nakujaproject/N3-Solid-_Propulsion/FlightData_N3_launch/Motor_design_Aluminum_casing/CAD/landscape04-bg_04.jpg

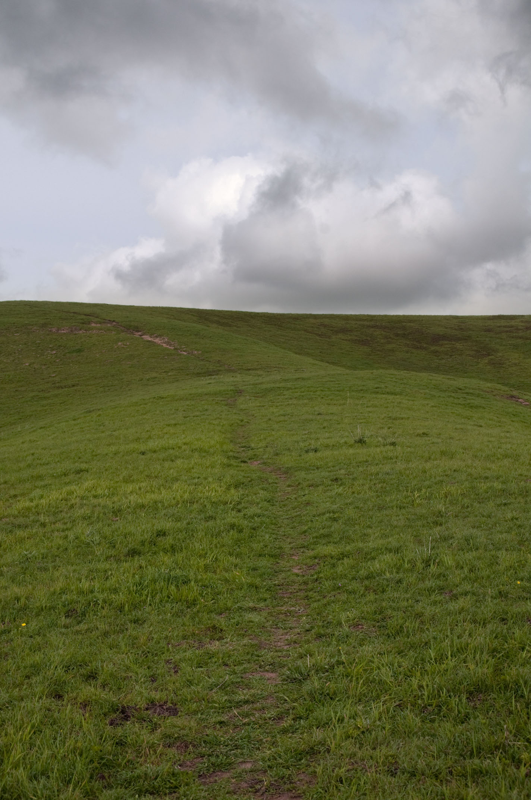
FlightData_N3_launch/Motor_design_Aluminum_casing/CAD/landscape04-bg_04.jpg
