nakujaproject/N3-Solid-_Propulsion/README.md

# N3-Solid-_Propulsion
Reporsitory to hold files for the development of the N3 solid propellant motor.
With a target apogee of 2KM
The propellant of choice is KNSB.
