nakujaproject/N3-Solid-_Propulsion/CAD_files/README.md

#CAD files
Directory to hold all CAD files
