nakujaproject/N3-Solid-_Propulsion/OpenMotor_files/README.md

#Open Motor Files
Directory to hold open motor files.
