nakujaproject/N3-Solid-_Propulsion/weeklyReports/BATCH 2 WEEK 11  REPORT.pptx

## BATCH 2 WEEK 110

SOLID PROPULSION REPORT

## MAJOR REMAINING TASKS ACCORDING TO TIMELINE

1. Three grain static test and analyzing of results.
2. Four grain static test and analyzing of results.

https://docs.google.com/spreadsheets/d/1hBBPNcnpQUVeR51bRd35yVVWFX5lDWHhBGYU0TpIXSk/edit#gid=0

## THIS WEEK'S OBJECTIVES

1. TWO GRAIN MOTOR SECOND STATIC TEST.
2. MODIFY THE DESIGN OF CASTING TOOLS.
3. START AND FINISH WORKING ON THE 3 GRAIN MOTOR.
4. COOK 2 GRAINS FROM SCRATCH.**
5. 3D PRINT REDESIGNED ELECTRONIC CASING.

## TWO GRAIN MOTOR SECOND STATIC TEST.

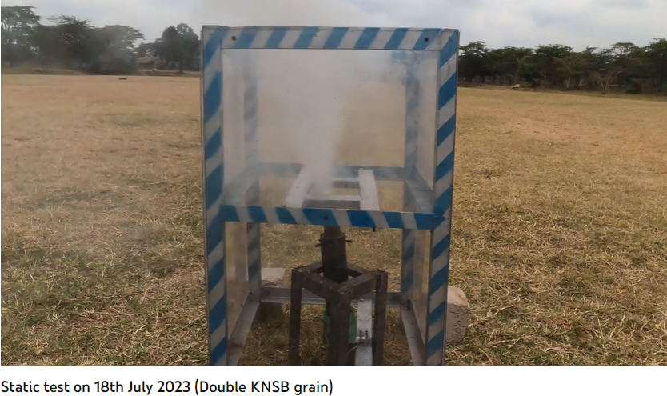
[picture p2: figure]
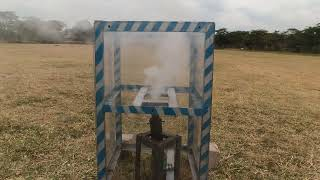
[picture p3: figure]

## AFTERMATH OF STATIC TEST

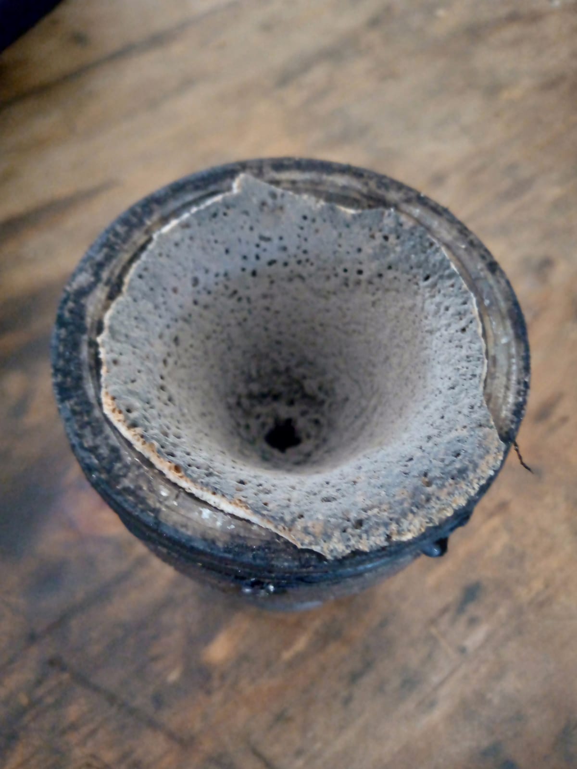
[picture p4: figure]
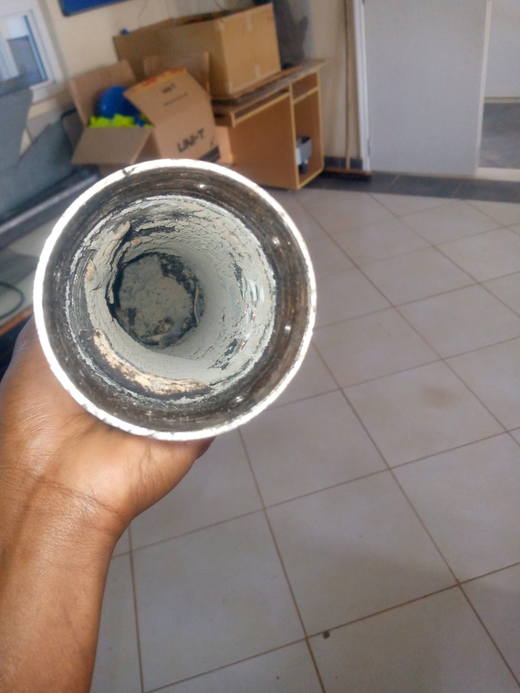
[picture p5: figure]
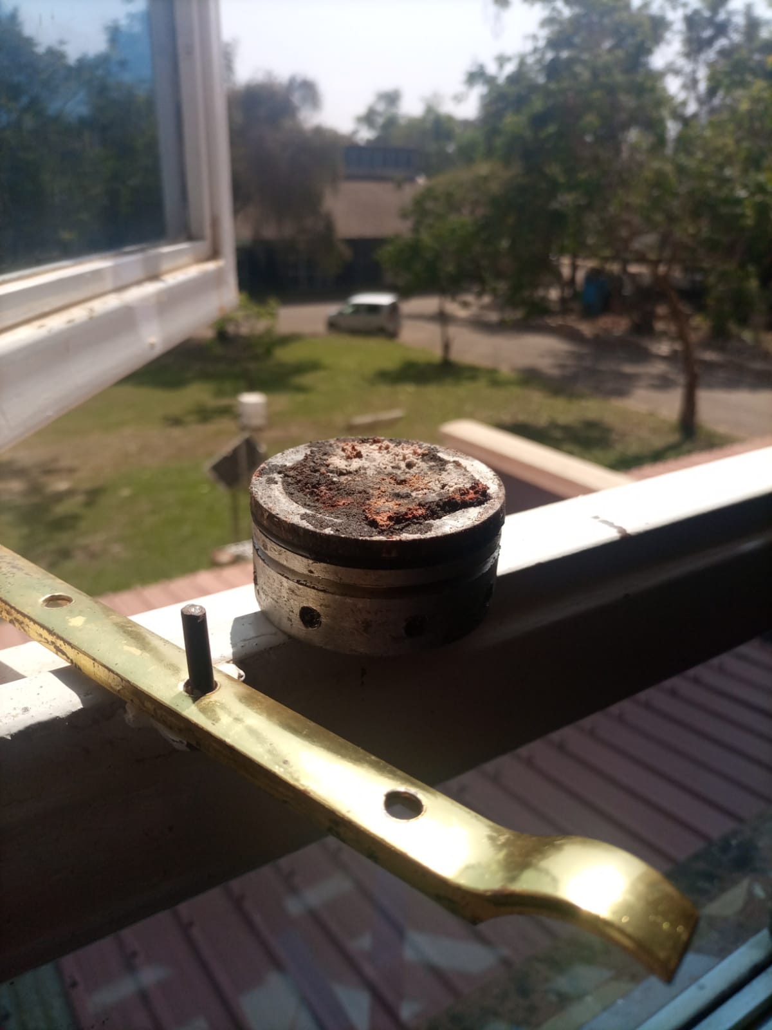
[picture p6: figure]

## OPEN MOTOR SIMULATION

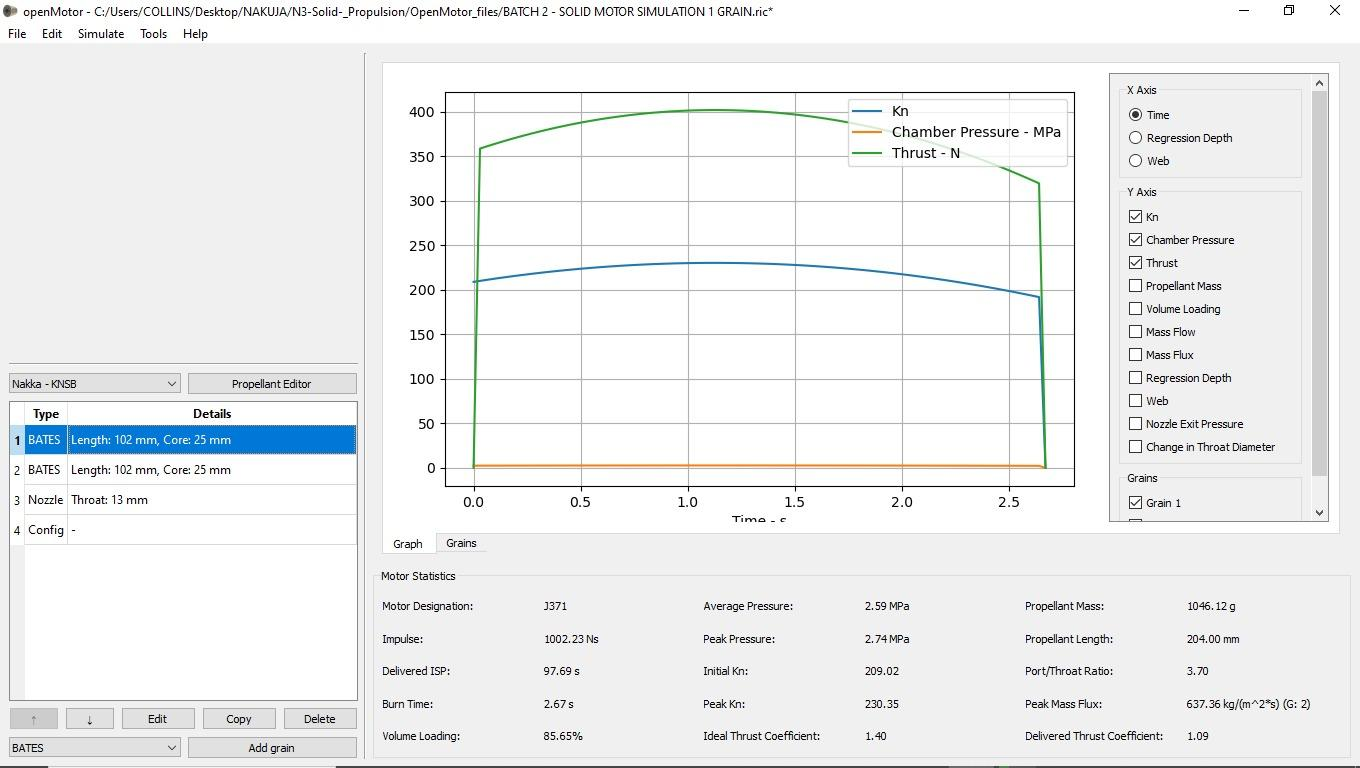
[picture p7: figure]

## ANALYZING STATIC TEST VALUES

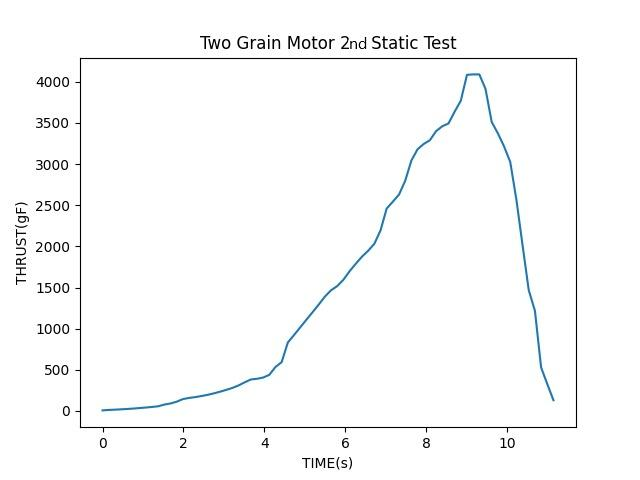
[picture p8: figure]

IMPULSE OF 2ND TWO GRAIN TEST: 165.O6 Ns

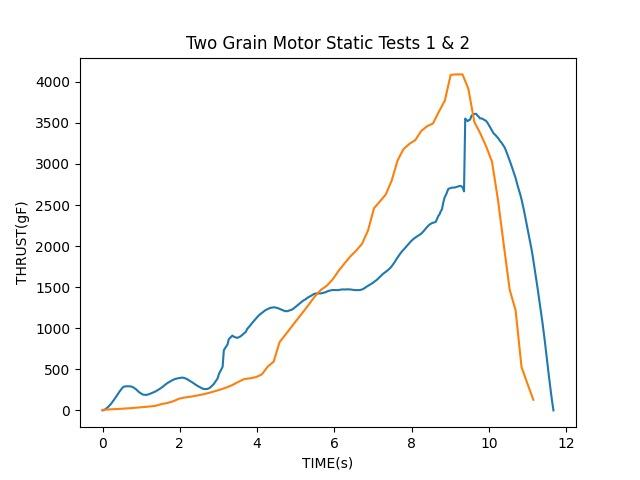
[picture p9: figure]

## TESTING OF THE GRAIN BURN RATE

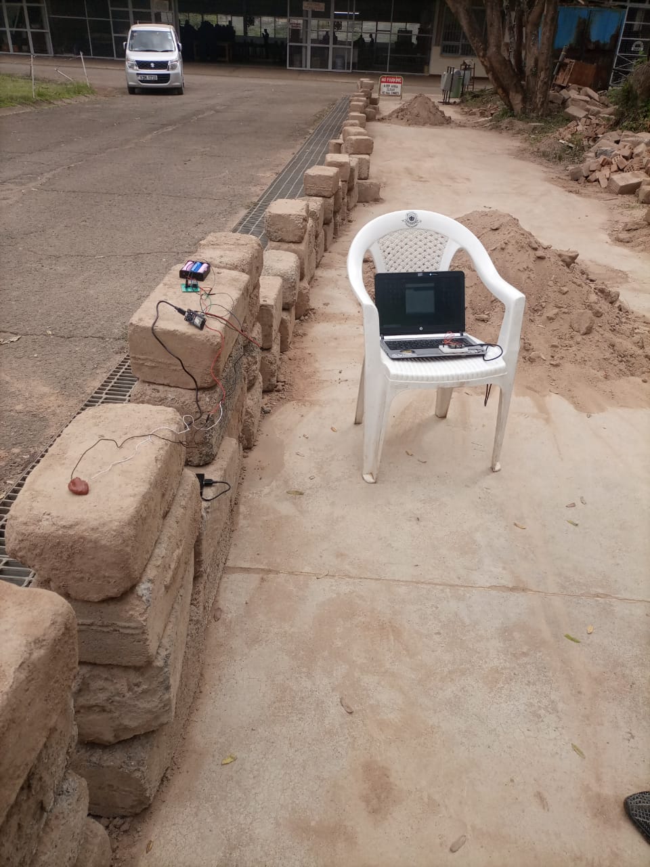
[picture p10: figure]

https://photos.google.com/share/AF1QipPy1zYaDyku8yvup7_9s7e2EUUXyLsp6BuL0e7tGyP1ksXkVun3unHOr58JC0QGWQ/photo/AF1QipNi4DA2iSjmNpshN0YMY0NlOidJ966pOgjzi1Rp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

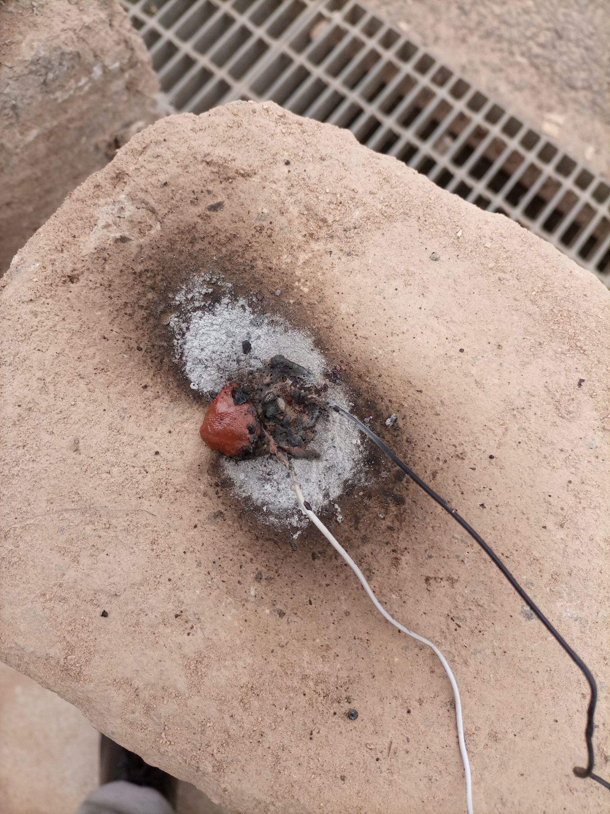
[picture p11: figure]

## MODIFY THE DESIGN OF CASTING TOOLS

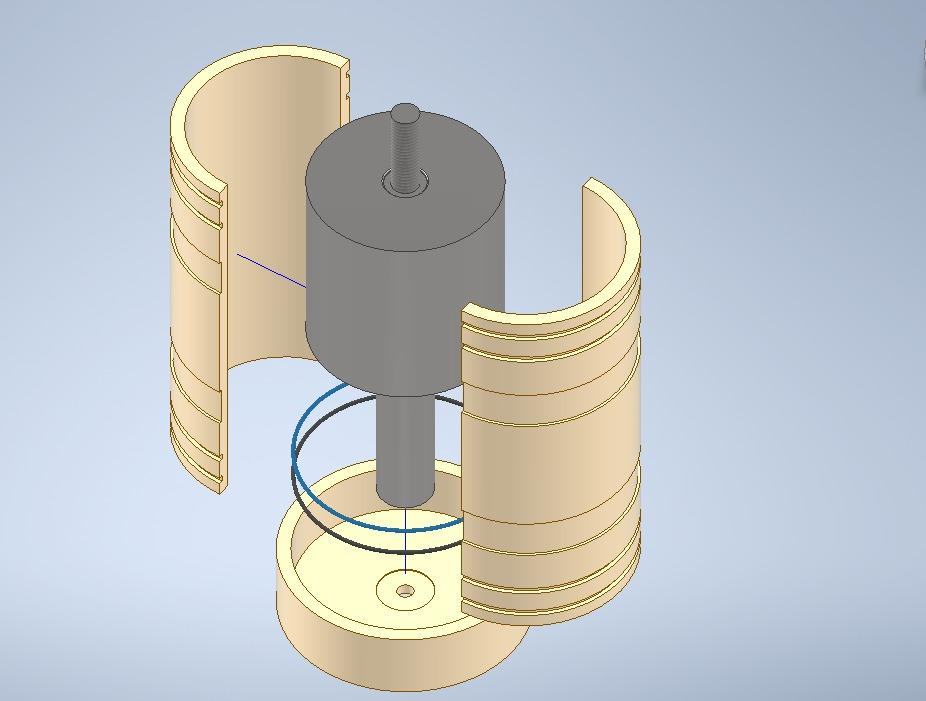
[picture p12: figure]

## START AND FINISH WORKING ON THE THREE GRAIN MOTOR

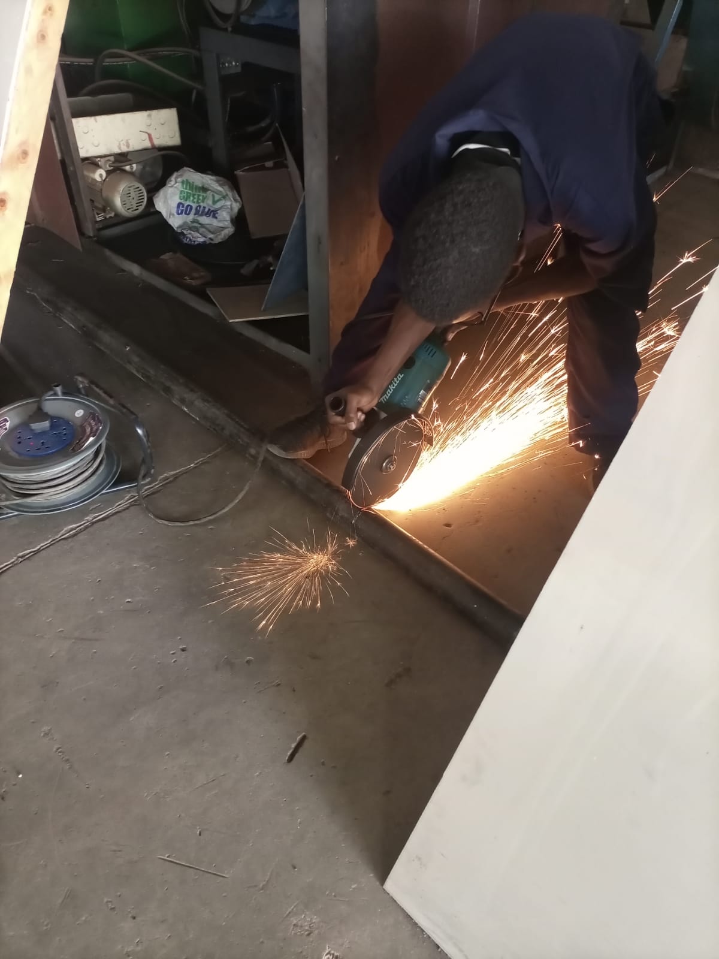
[picture p13: figure]
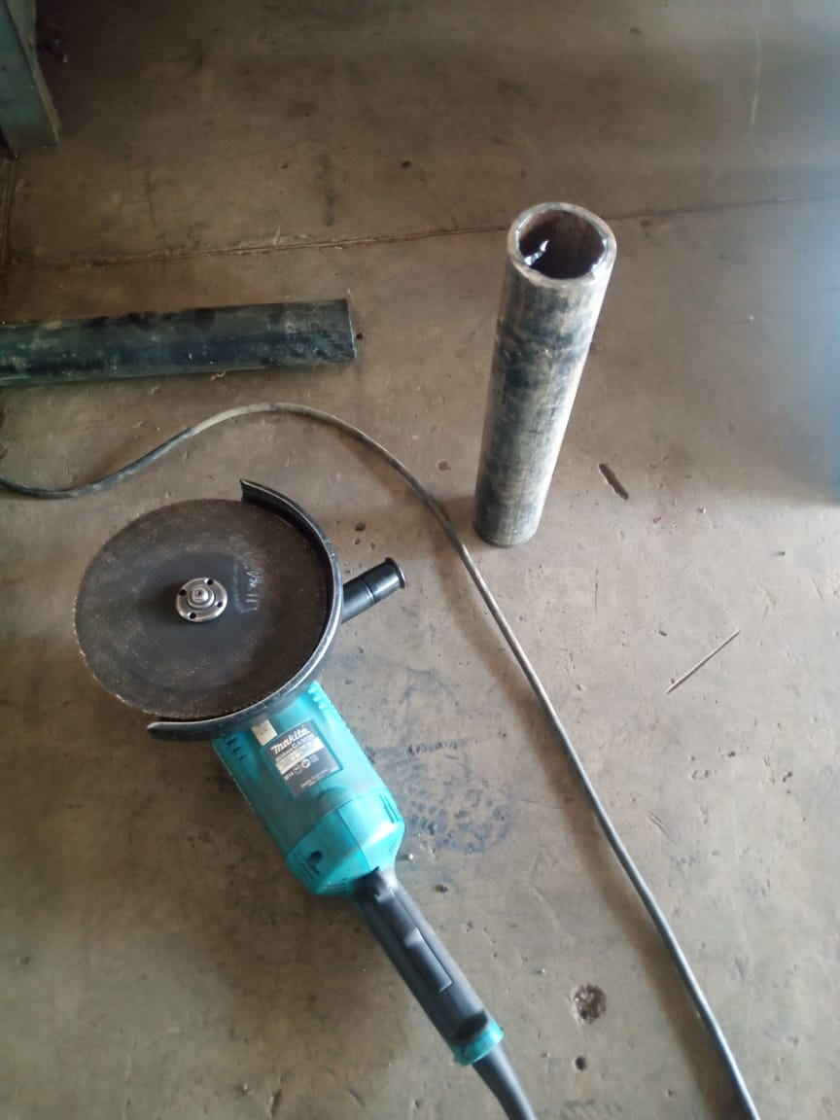
[picture p14: figure]
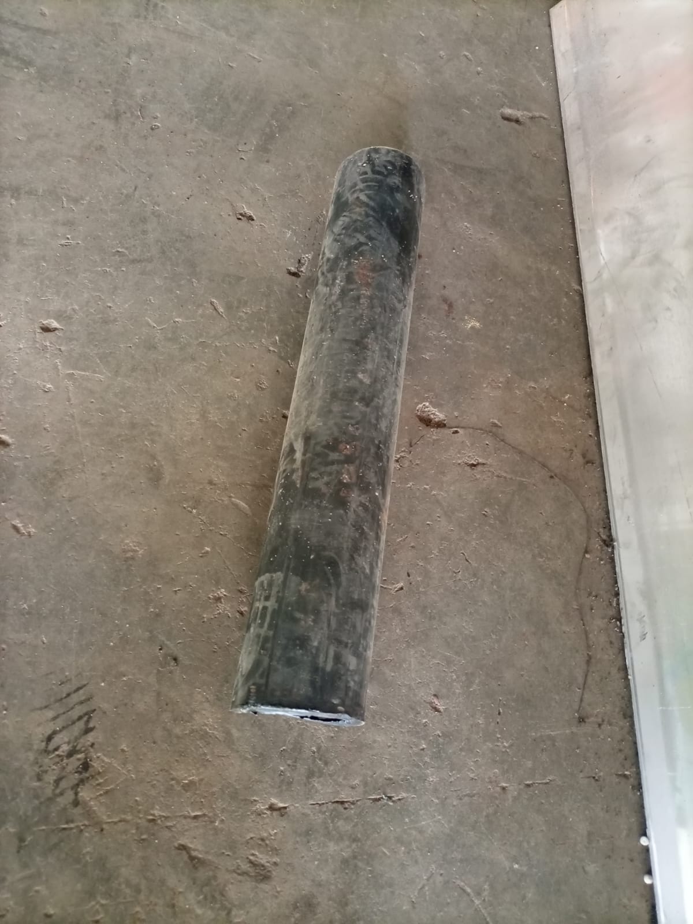
[picture p15: figure]

## 3D PRINTING OF REDESIGNED ELECTRONICS CASING

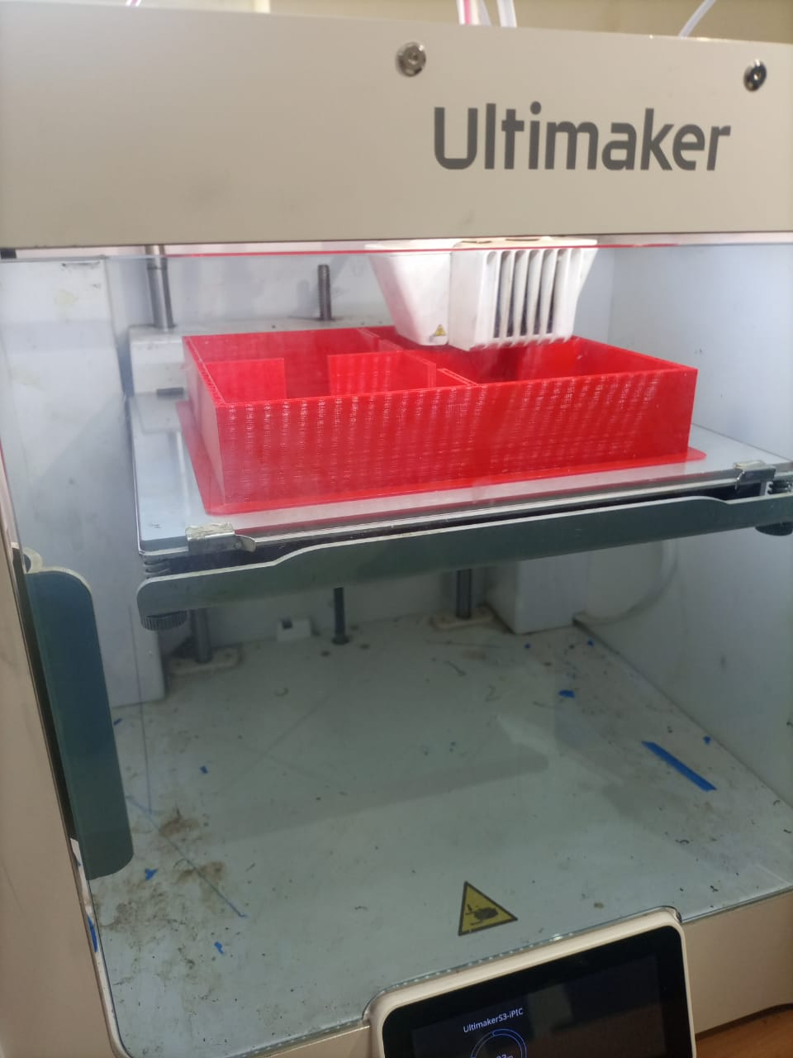
[picture p16: figure]
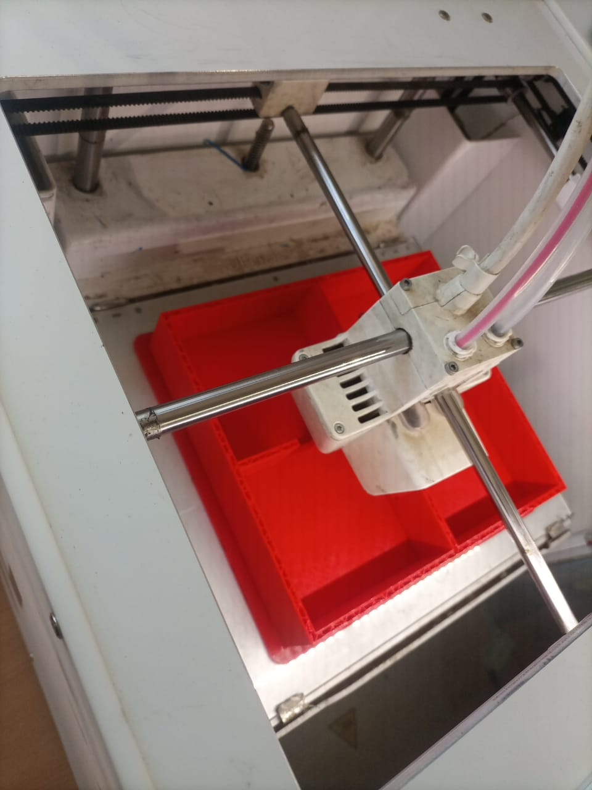
[picture p17: figure]

## CHALLENGES

1. FAULTY ENGINE LATHE

## NEXT WEEK'S OBJECTIVES

1. COOK 2 FULL GRAINS
2. CONDUCT 3RD 2 GRAIN STATIC TEST.
3. FINISH UP ON THE 3 GRAIN MOTOR.

## THANK YOU
