nakujaproject/N3-Solid-_Propulsion/weeklyReports/BATCH_2_WEEK_10.pptx

## WEEK 10 SOLID PROPULSION REPORT

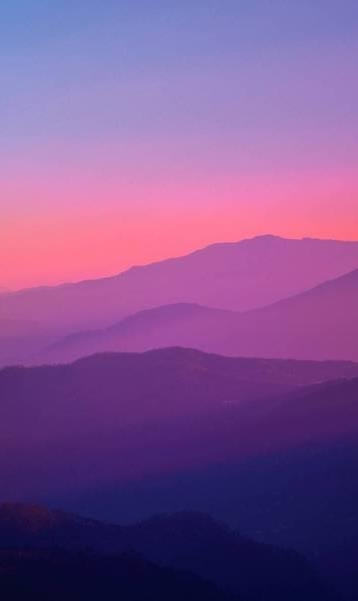
[picture p18: figure]
A picture containing mountain, sky, outdoor, nature, sunrise

BATCH 2

## Slide 2

https://docs.google.com/spreadsheets/d/1hBBPNcnpQUVeR51bRd35yVVWFX5lDWHhBGYU0TpIXSk/edit#gid=0

Gantt chart

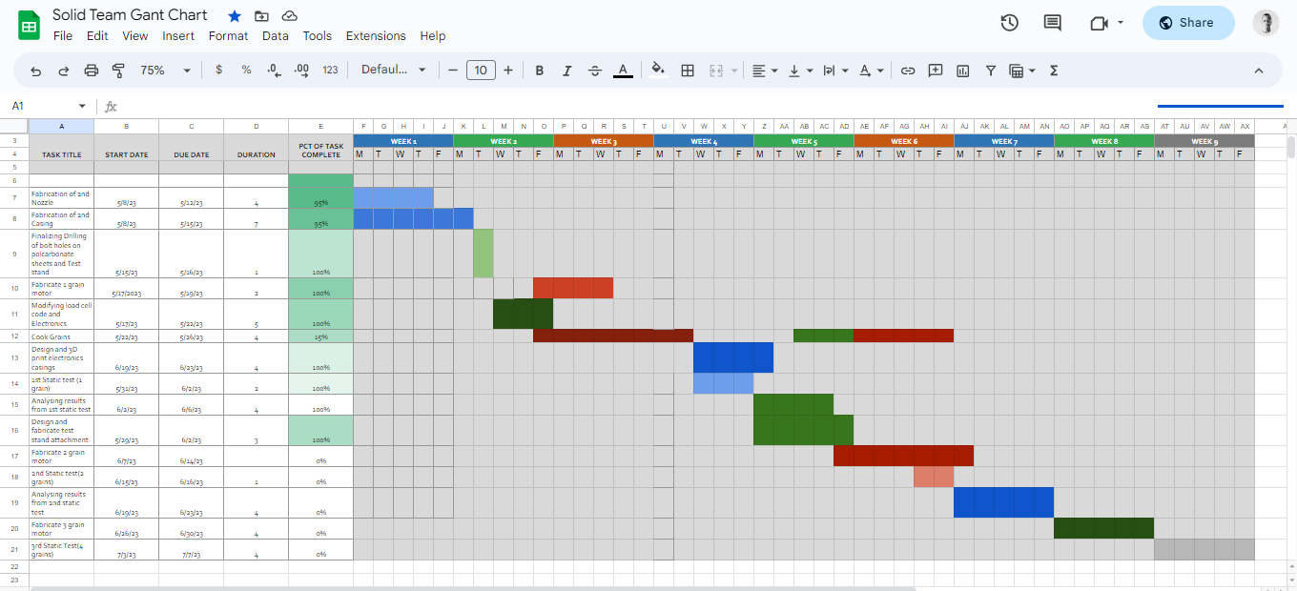
[picture p19: figure]

## WEEKLY OBJECTIVES

COOK
COOK3FULL GRAINS.
TWO GRAIN MOTOR.
PREPARE TWO GRAIN MOTOR FOR SECOND TEST.
REDESIGN.
CASING FOR ELECTRONICS.
MOTOR HOLDER.

## REDESIGN.

CASING FOR ELECTRONICS.

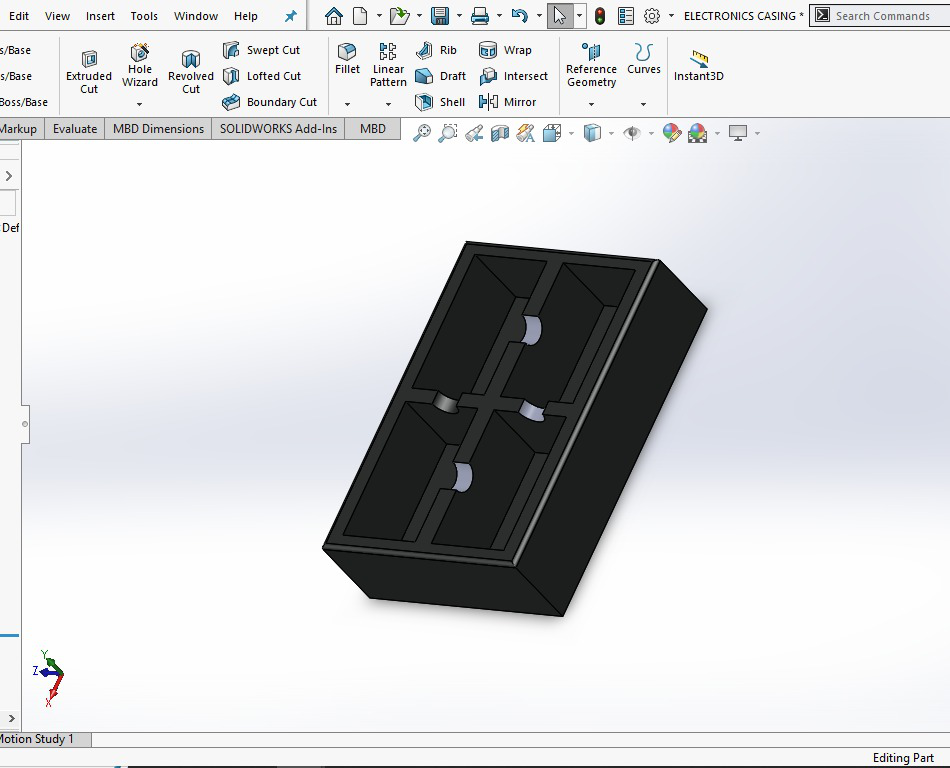
[picture p20: figure]
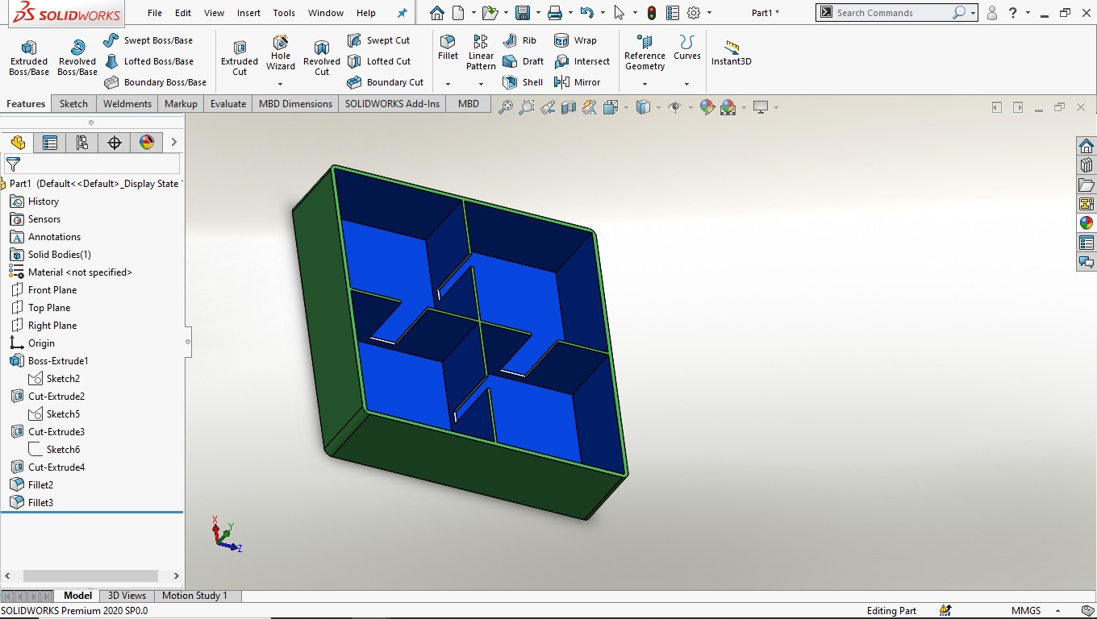
[picture p21: figure]

## COOKING TWO GRINS

REDESIGN.

MOTOR HOLDER.

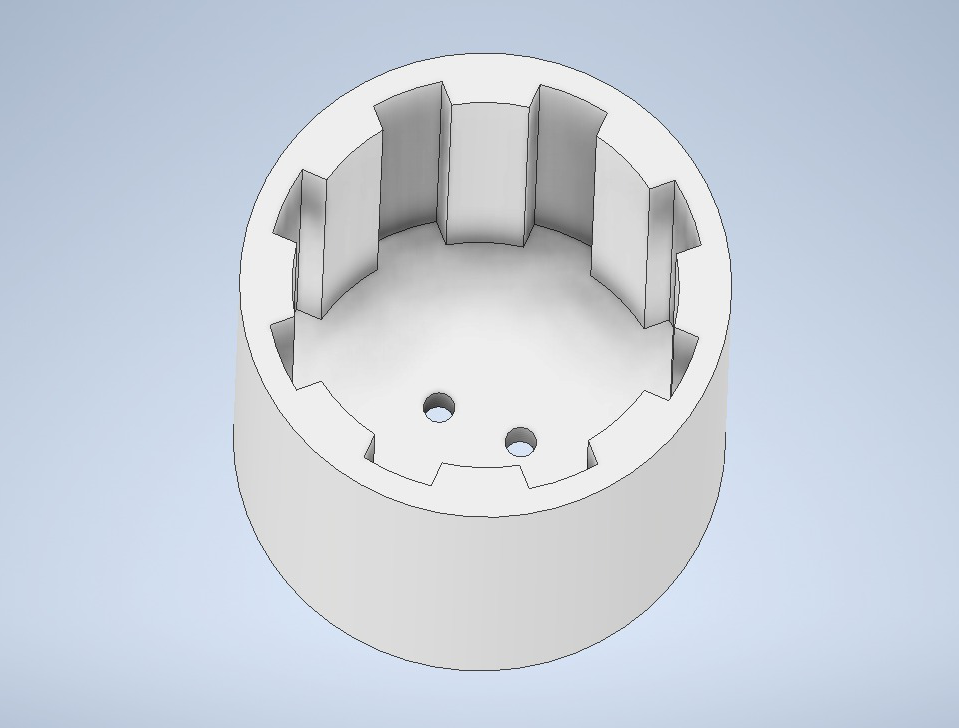
[picture p22: figure]
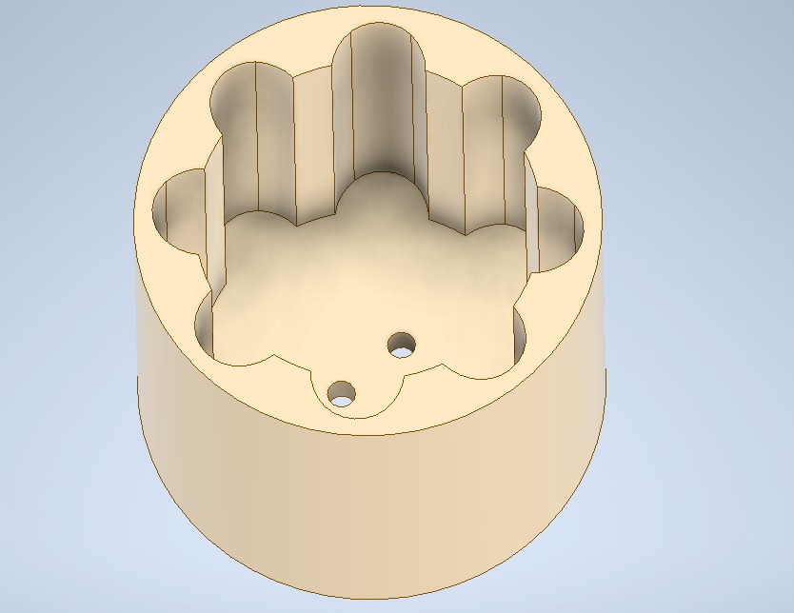
[picture p23: figure]

## FINAL PRODUCT

COOK.

COOK 3 FULL GRAINS.

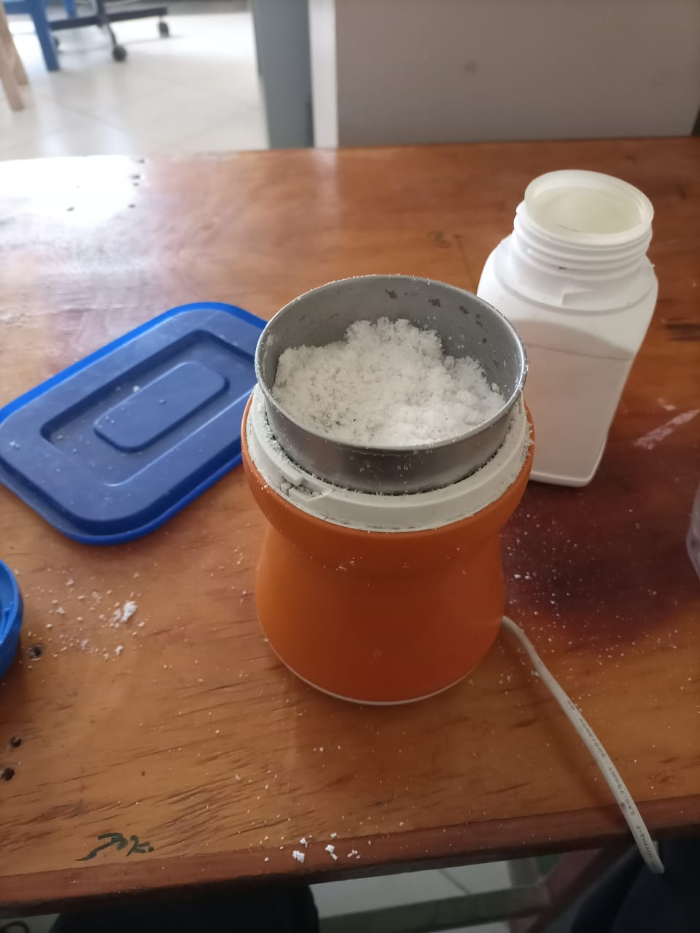
[picture p24: figure]
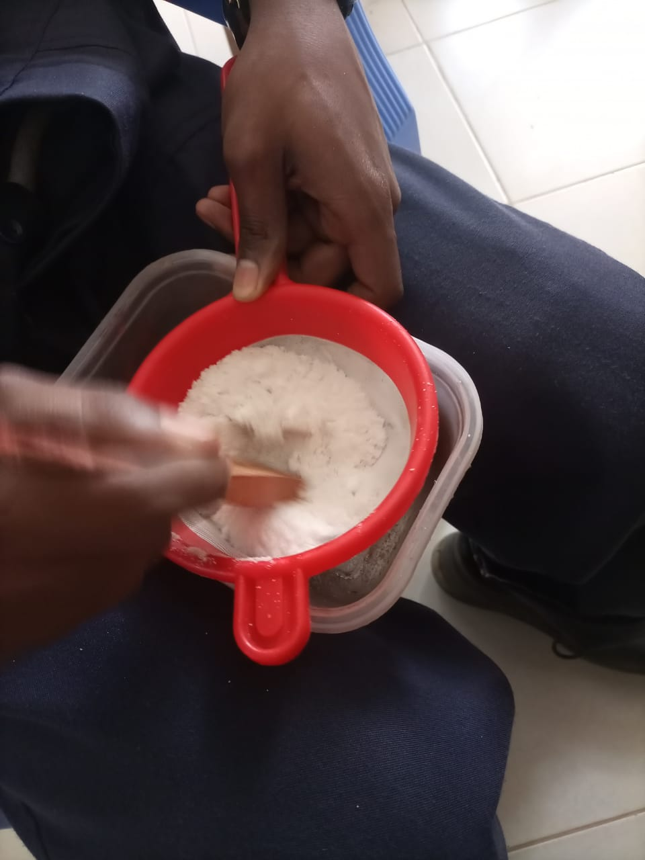
[picture p25: figure]

## DRILLING OF BULKHEAD AND CASING

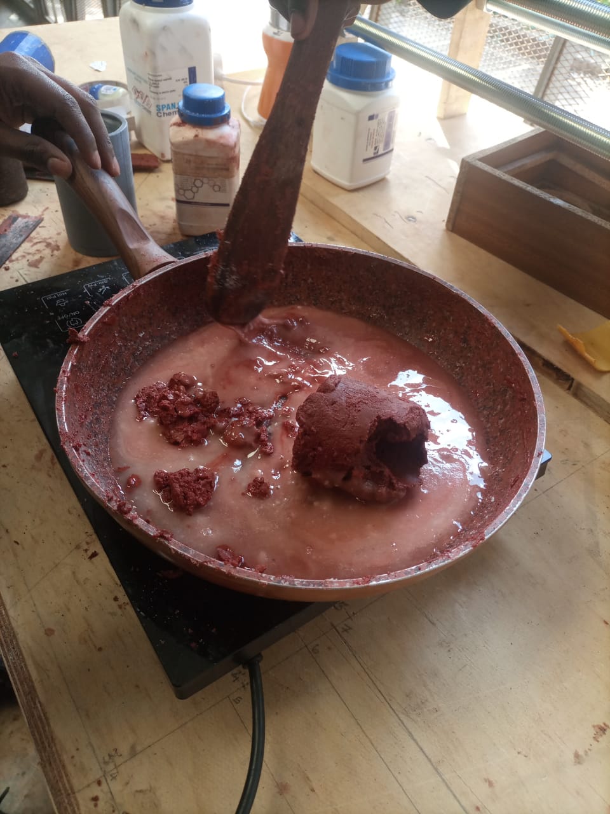
[picture p26: figure]
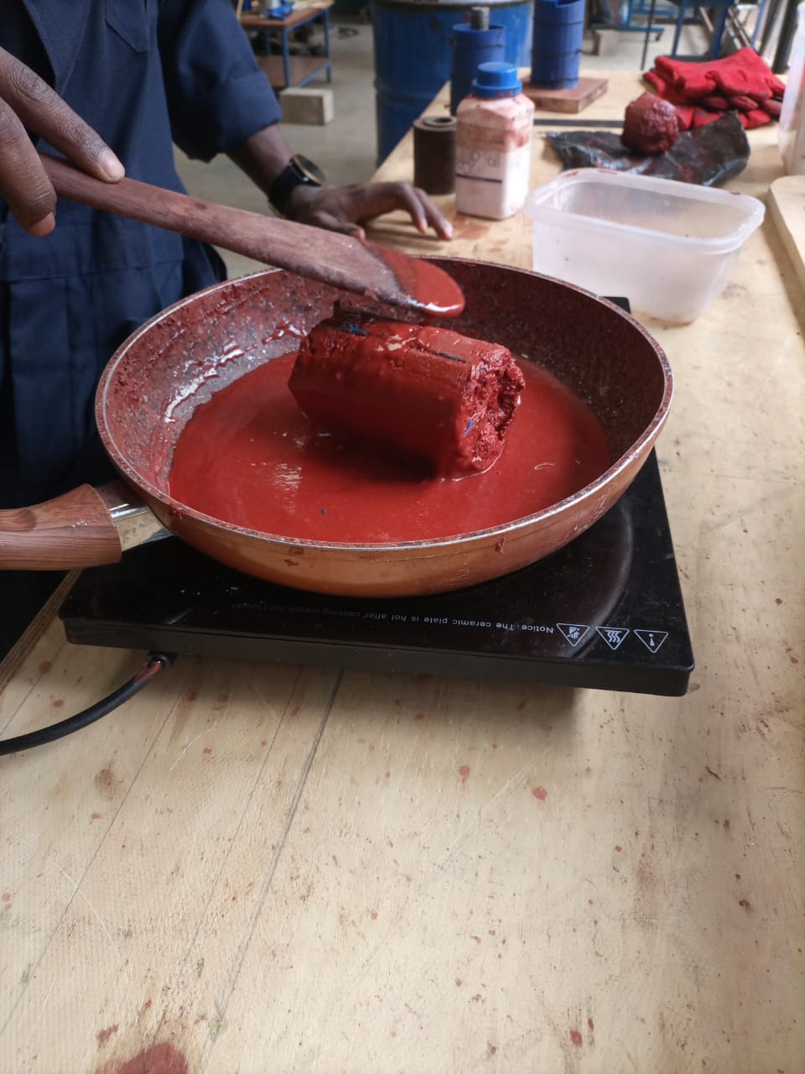
[picture p27: figure]
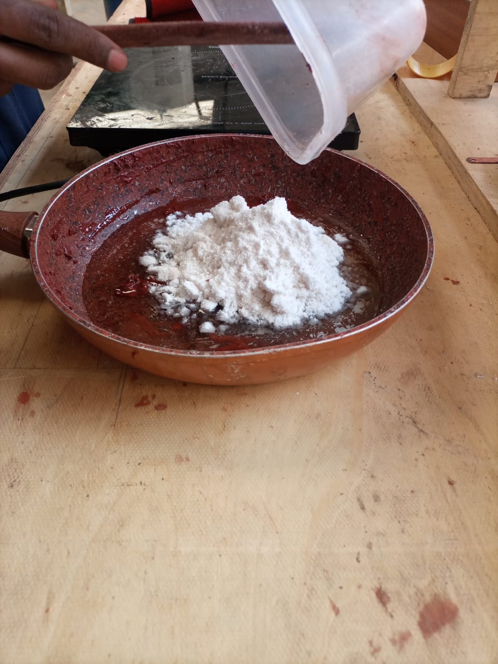
[picture p28: figure]

COOK.

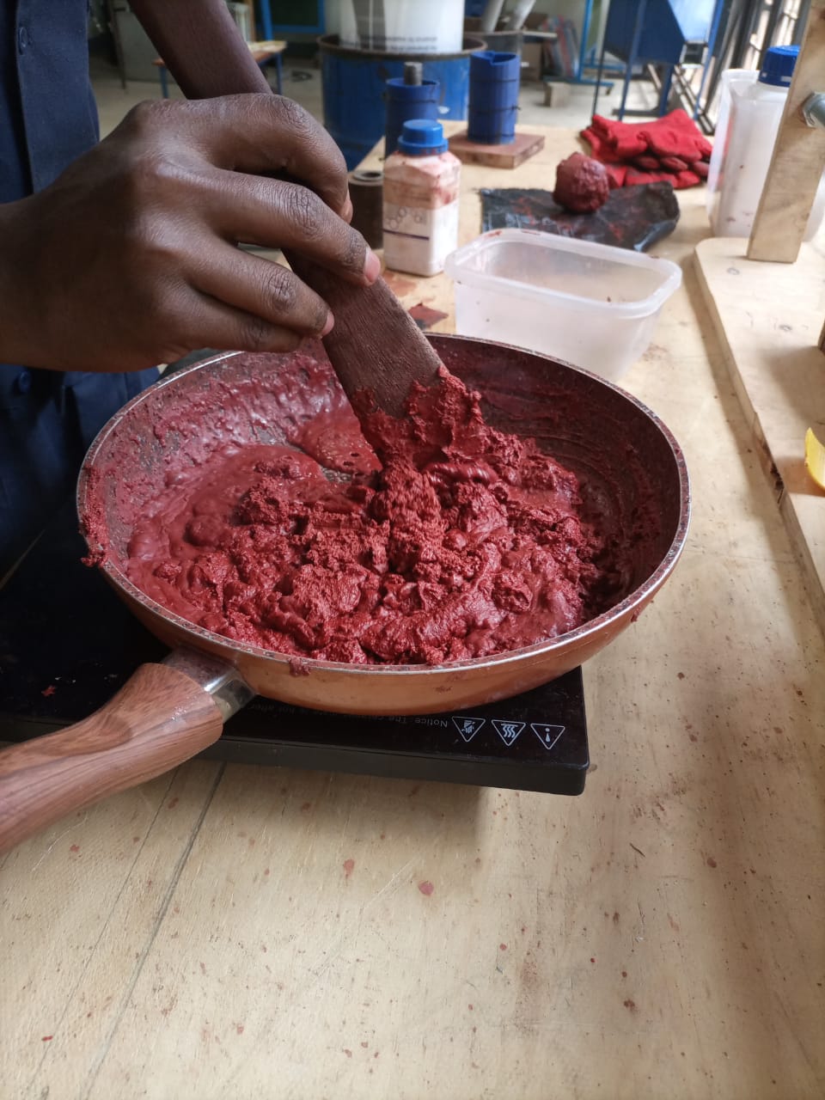
[picture p29: figure]
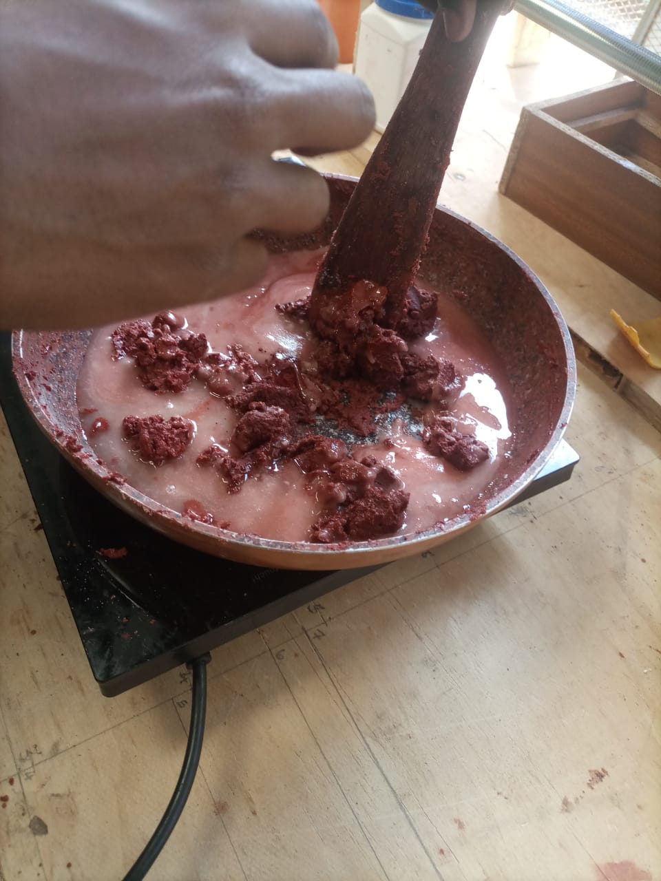
[picture p30: figure]
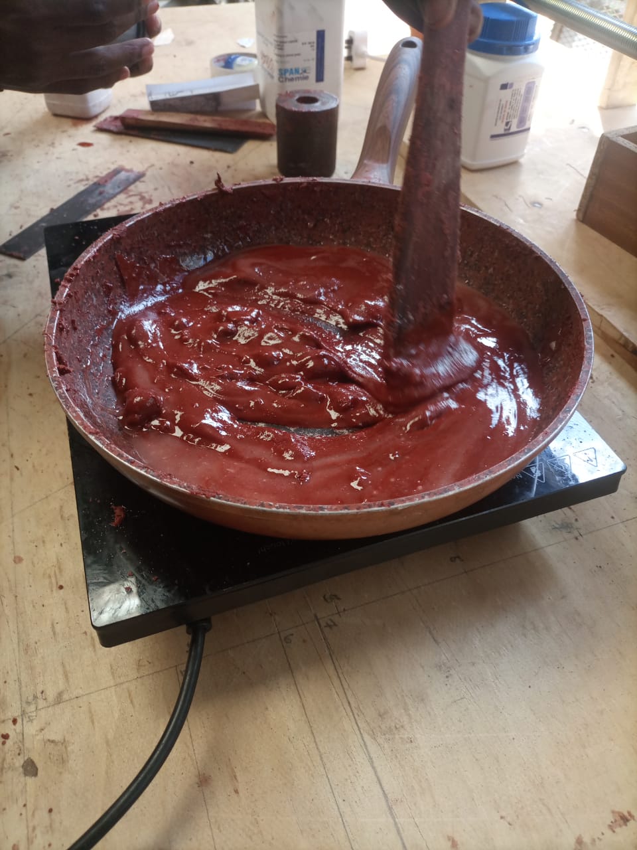
[picture p31: figure]

## Slide 8

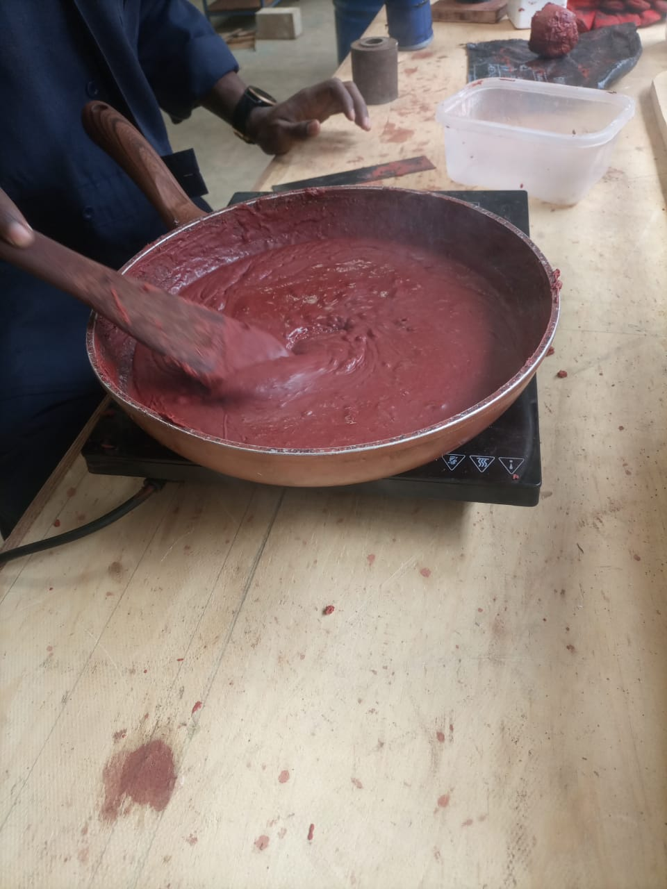
[picture p32: figure]
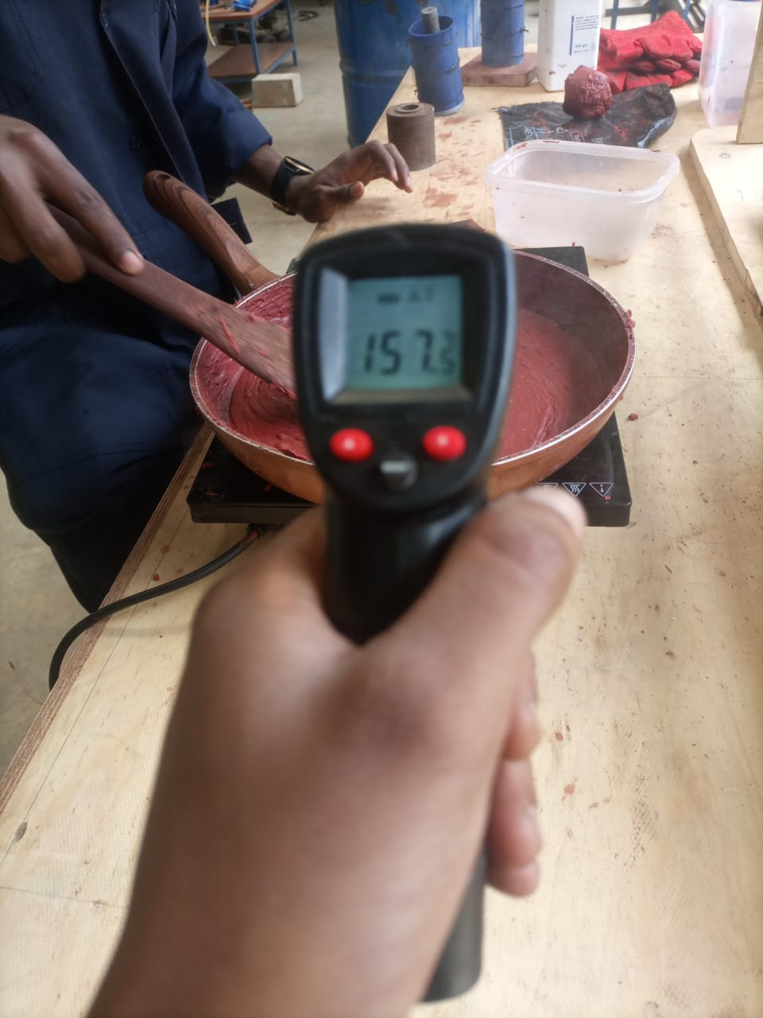
[picture p33: figure]
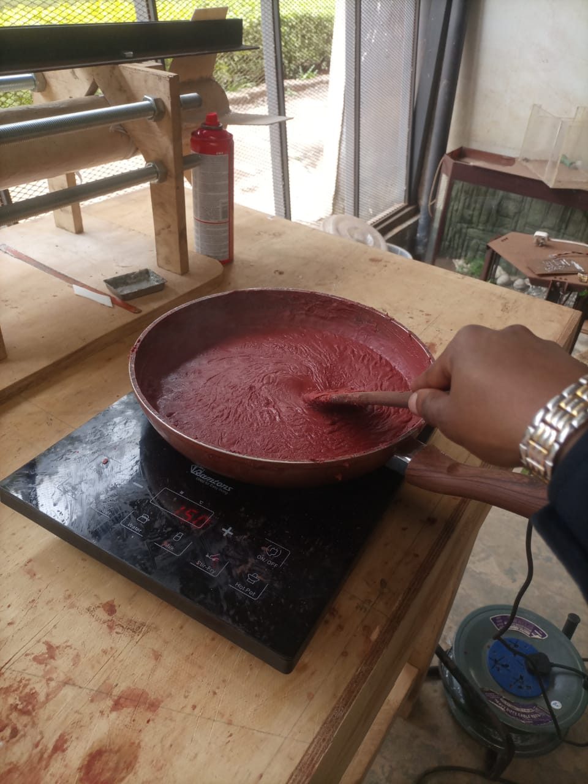
[picture p34: figure]
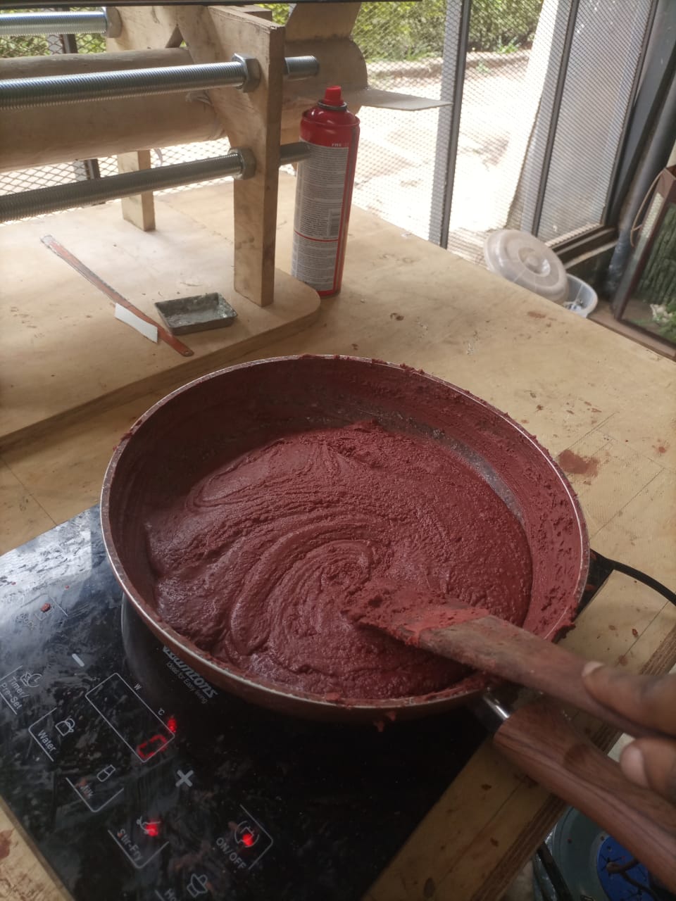
[picture p35: figure]
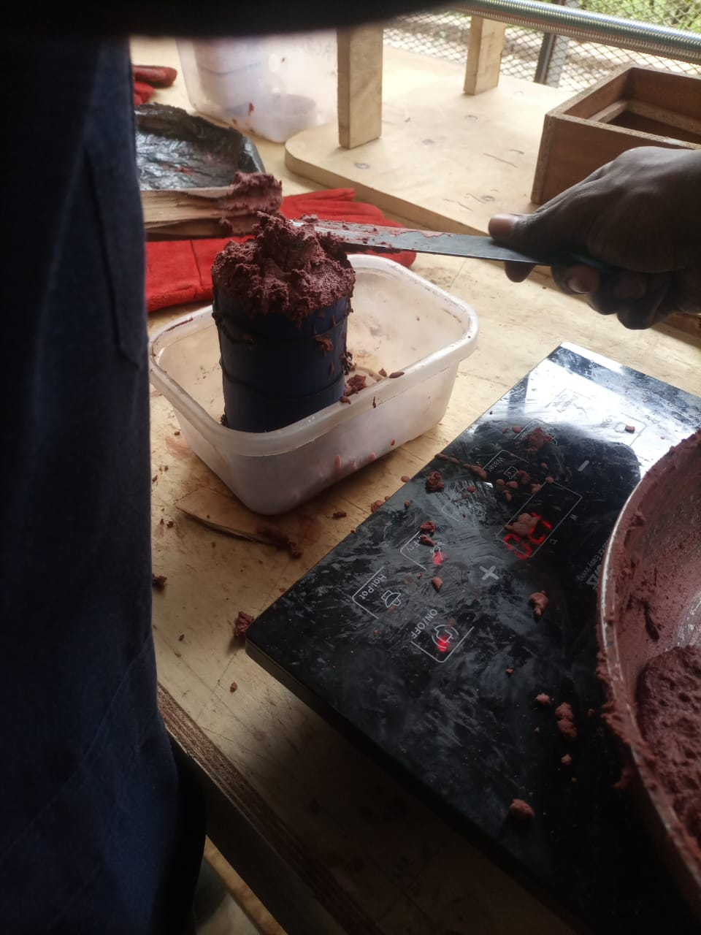
[picture p36: figure]
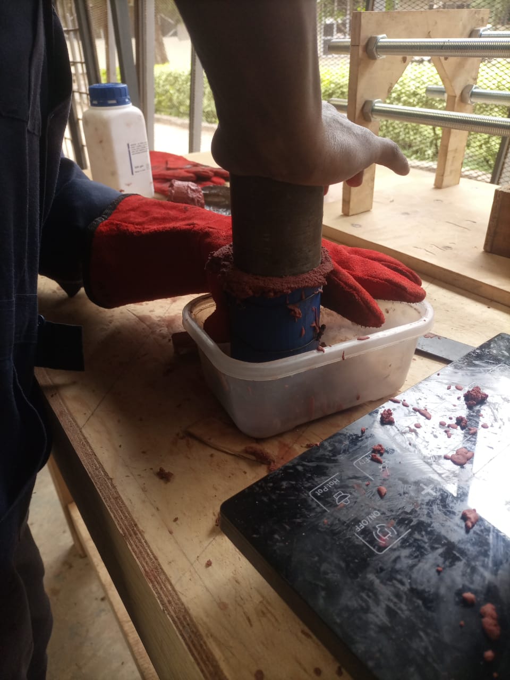
[picture p37: figure]

## FINAL PRODUCT.

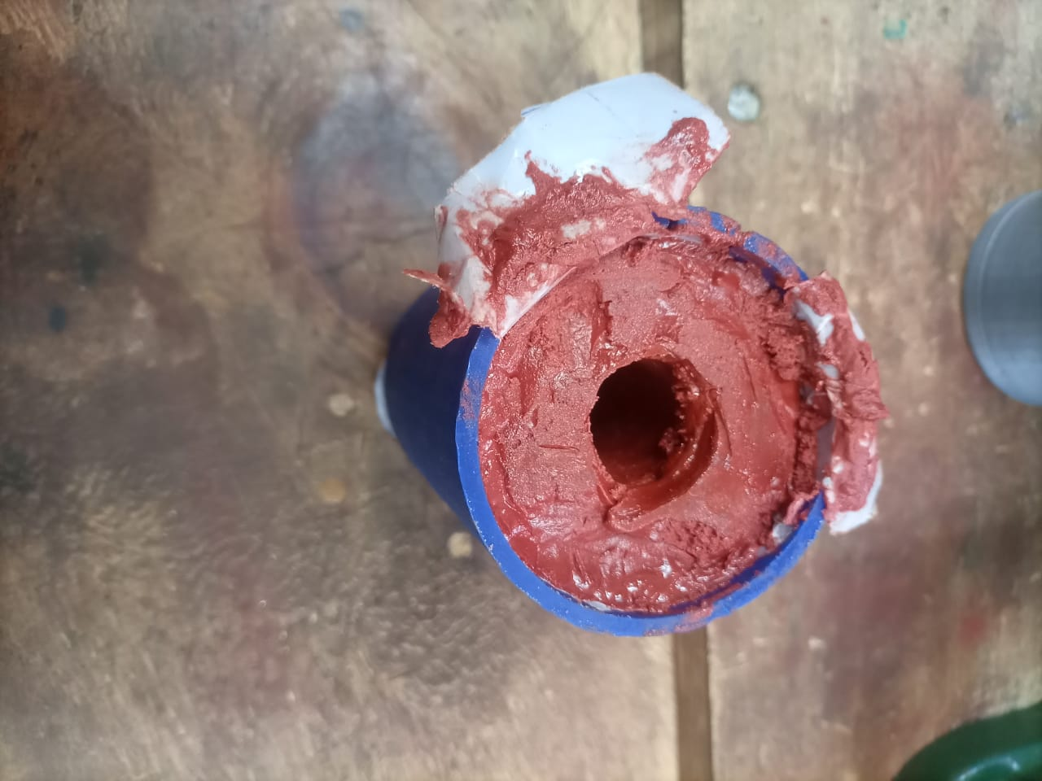
[picture p38: figure]
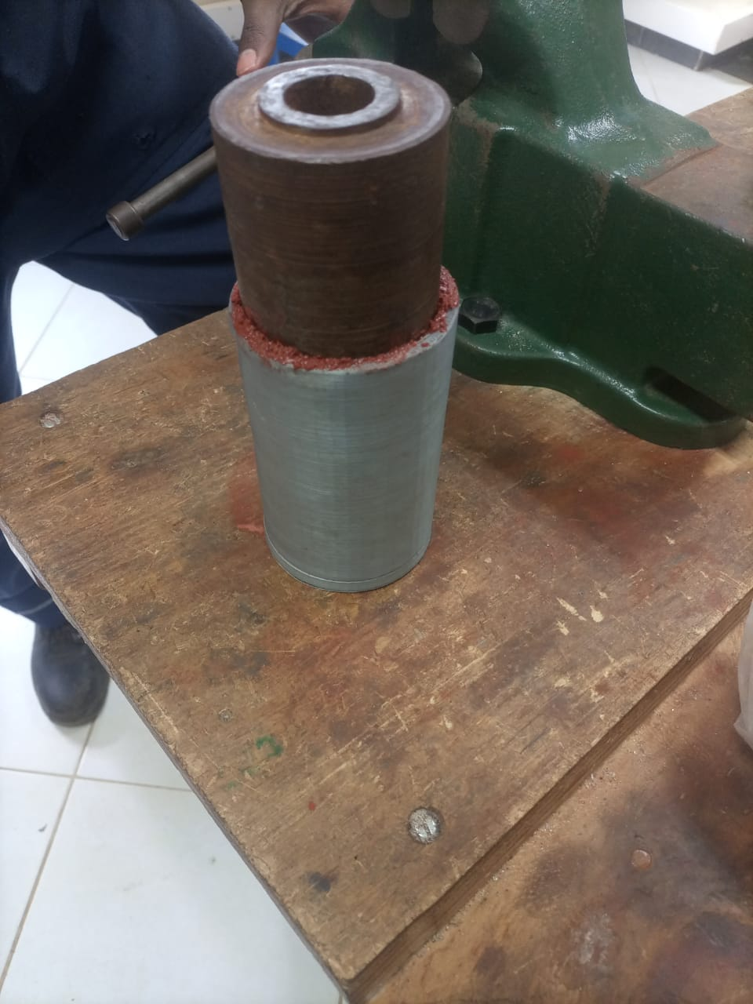
[picture p39: figure]
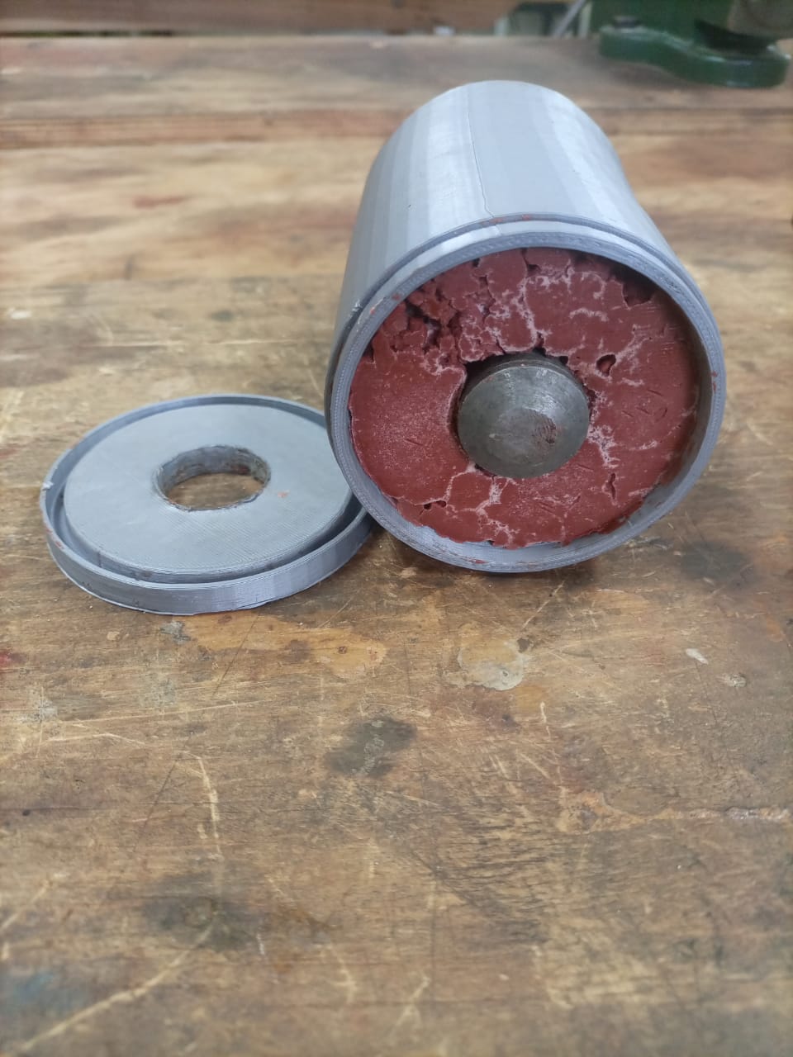
[picture p40: figure]
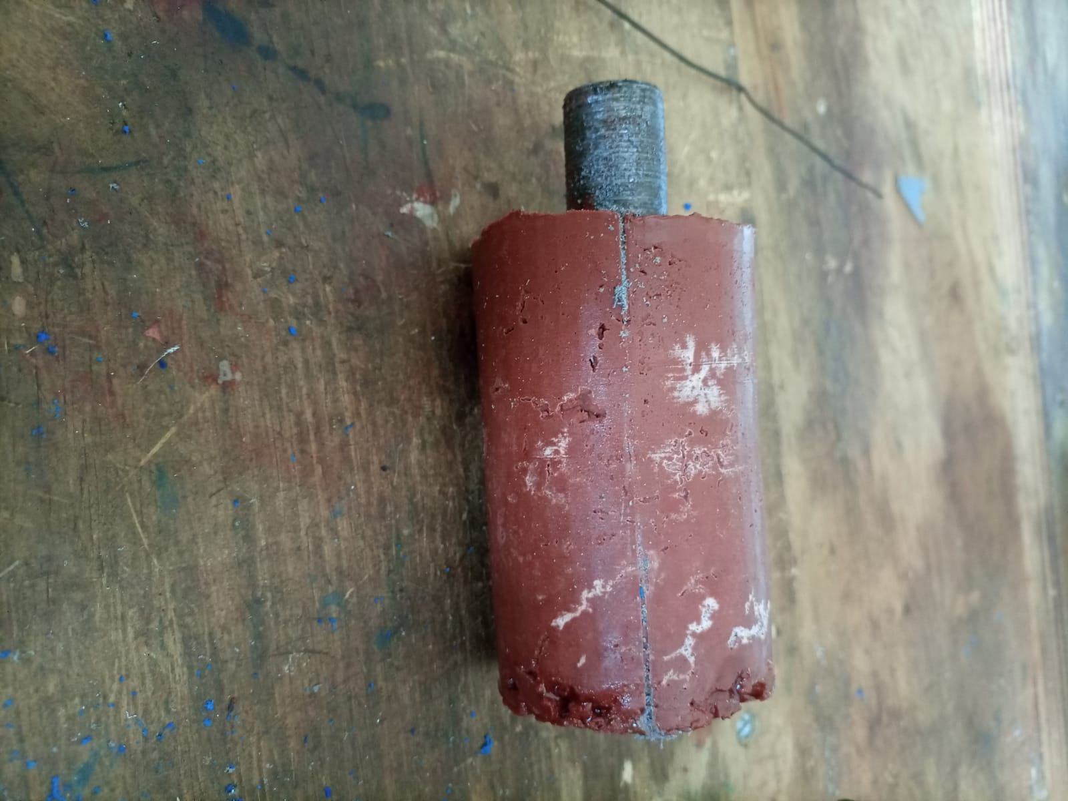
[picture p41: figure]

## CHALLENGES

- Lathe machine faulty.

## NEXT WEEK’S OBJECTIVES

- TWO GRAIN MOTOR SECOND STATIC TEST.
- COOK 2 GRAINS FROM SCRATCH.
- START AND FINISH WORKING ON THE 3 GRAIN MOTOR.
- MODIFY THE DESIGN OF CASTING TOOLS.

## THANK YOU

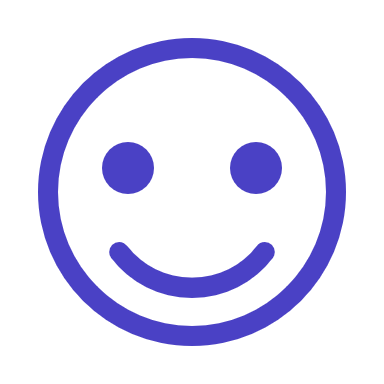
[picture p42: figure]
Smiling Face with No Fill
