nakujaproject/N3-Solid-_Propulsion/weeklyReports/BATCH 2 WEEK 9 SOLID TEAM REPORT.pptx

## WEEK 9 SOLID TEAM REPORT

A picture containing mountain, sky, outdoor, nature, sunrise

BATCH 2

## WEEKLY OBJECTIVES

FINISH UP
FINISH UP ON THE 2 GRAIN MOTOR.
COOK
COOK 2 FULL GRAINS.
CONDUCT
CONDUCT STATIC TEST.

## SIMULATION OF TWO GRAIN MOTOR

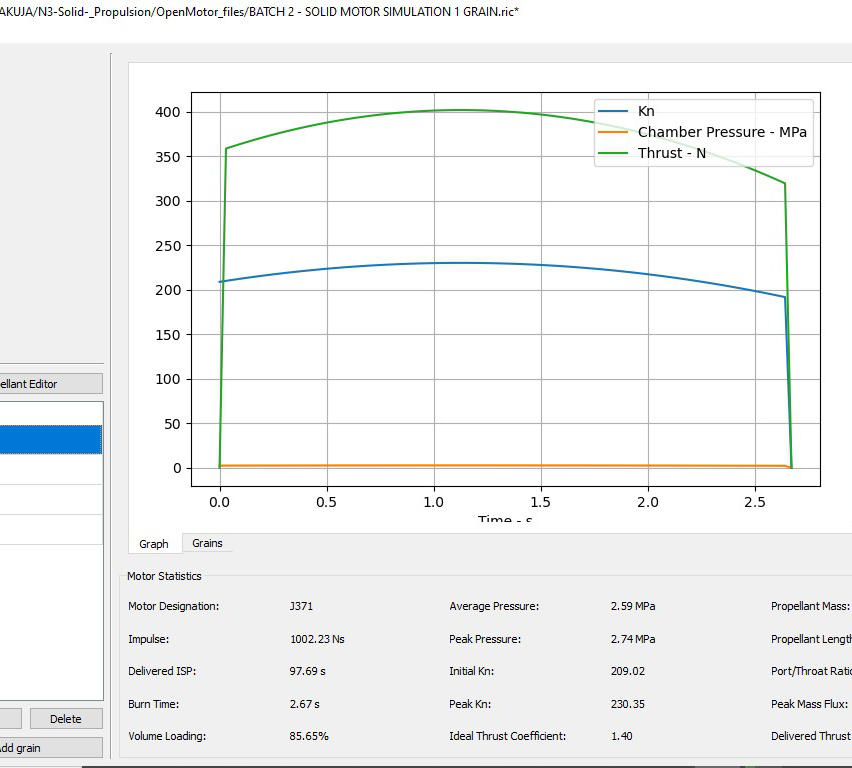
[picture p43: figure]

## COOKING TWO GRAINS

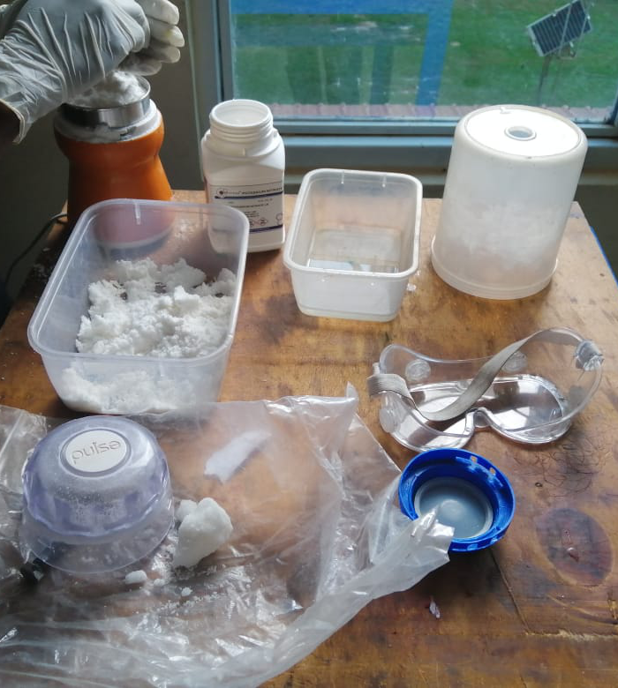
[picture p44: figure]
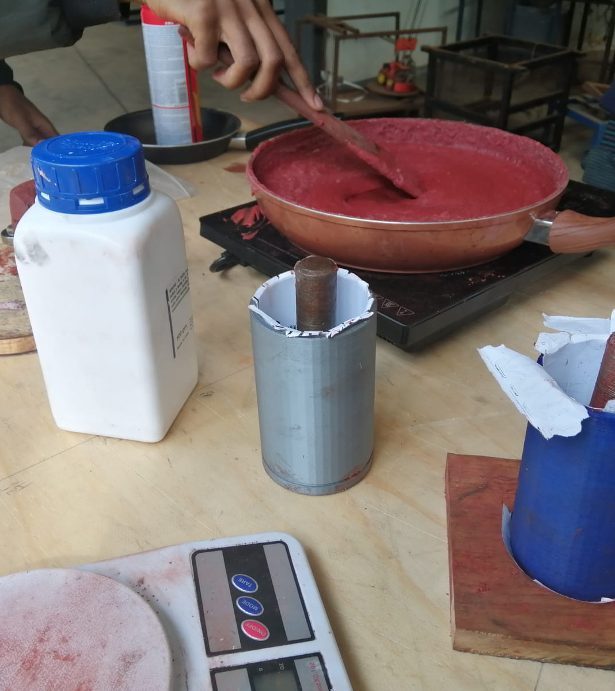
[picture p45: figure]
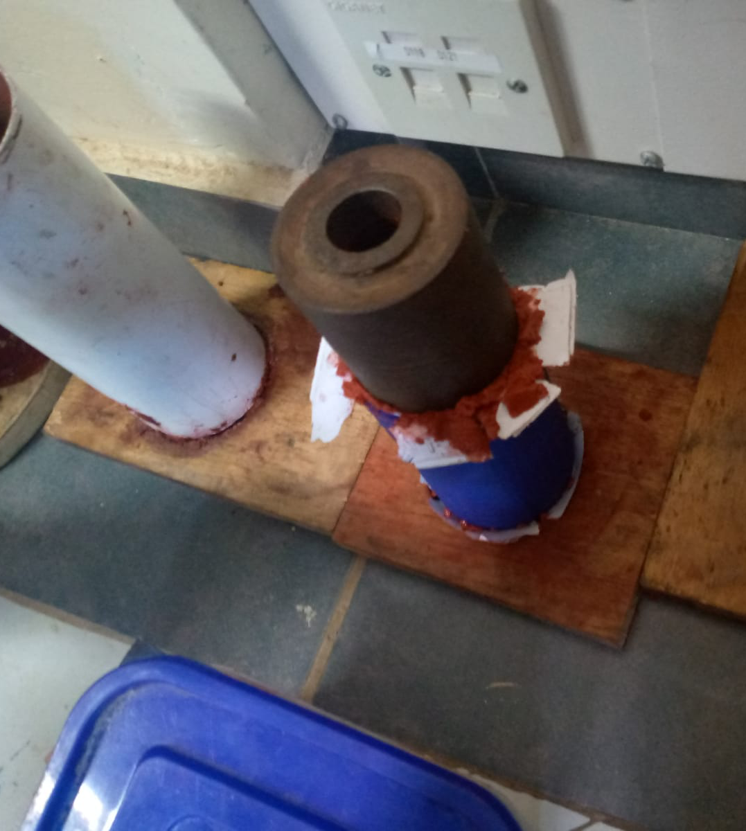
[picture p46: figure]

## FINAL PRODUCT

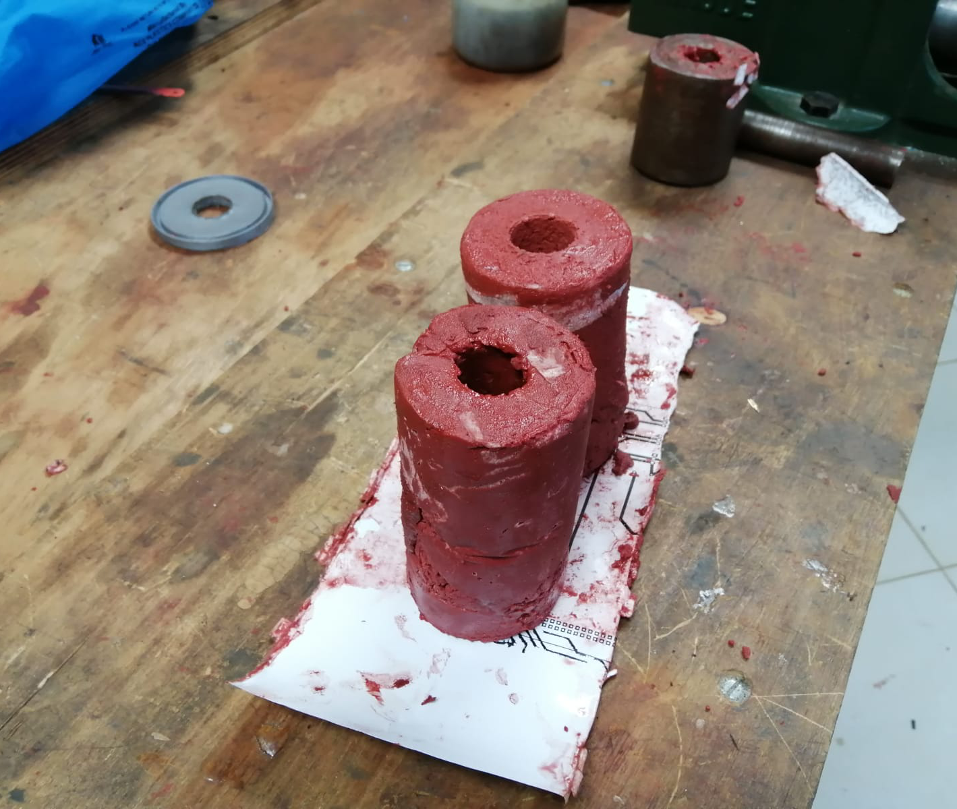
[picture p47: figure]

## DRILLING OF BULKHEAD AND CASING

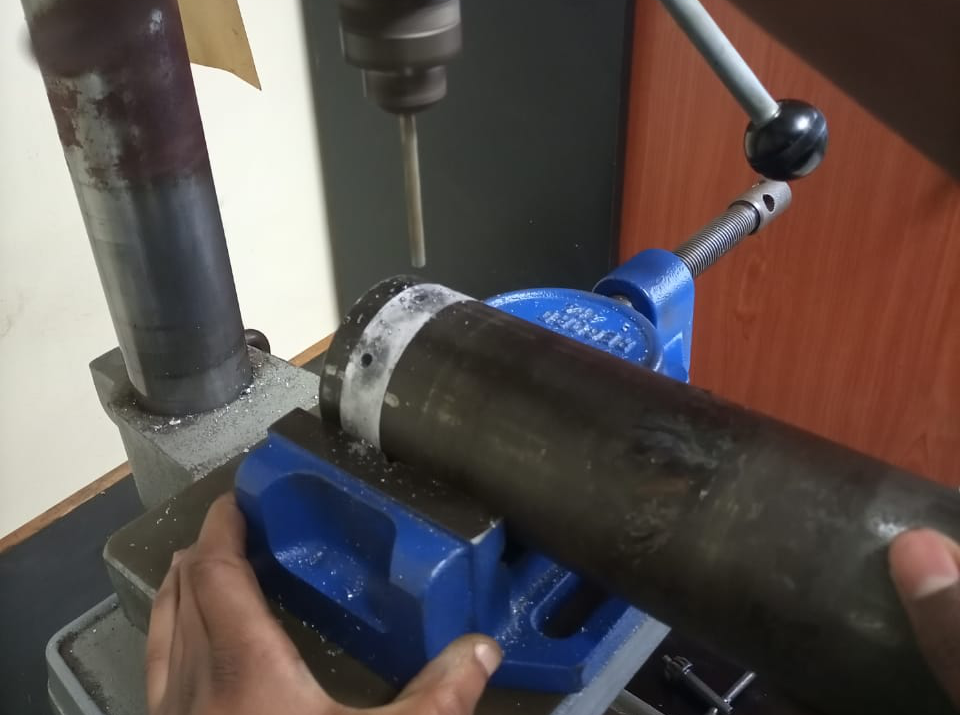
[picture p48: figure]
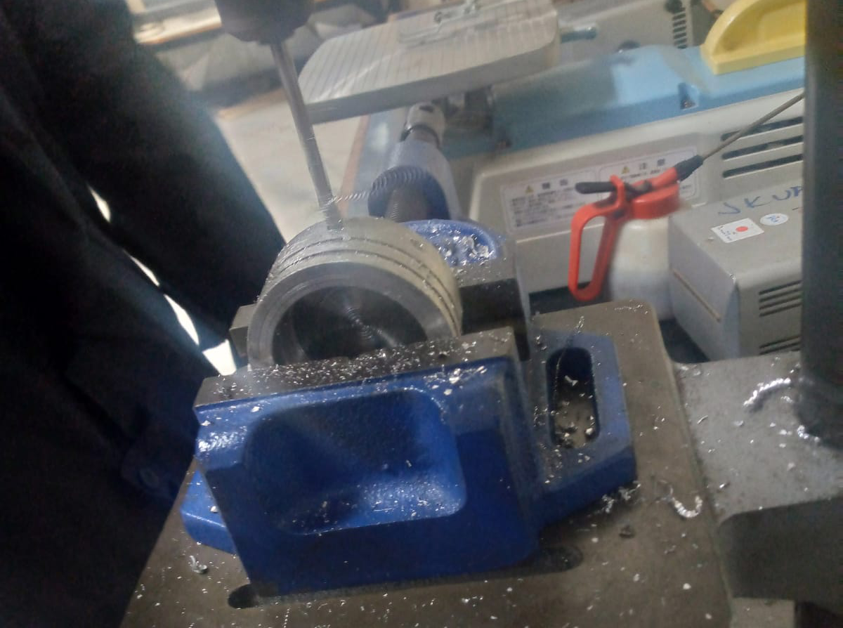
[picture p49: figure]

## TAPPING OF BULKHEAD AND CASING

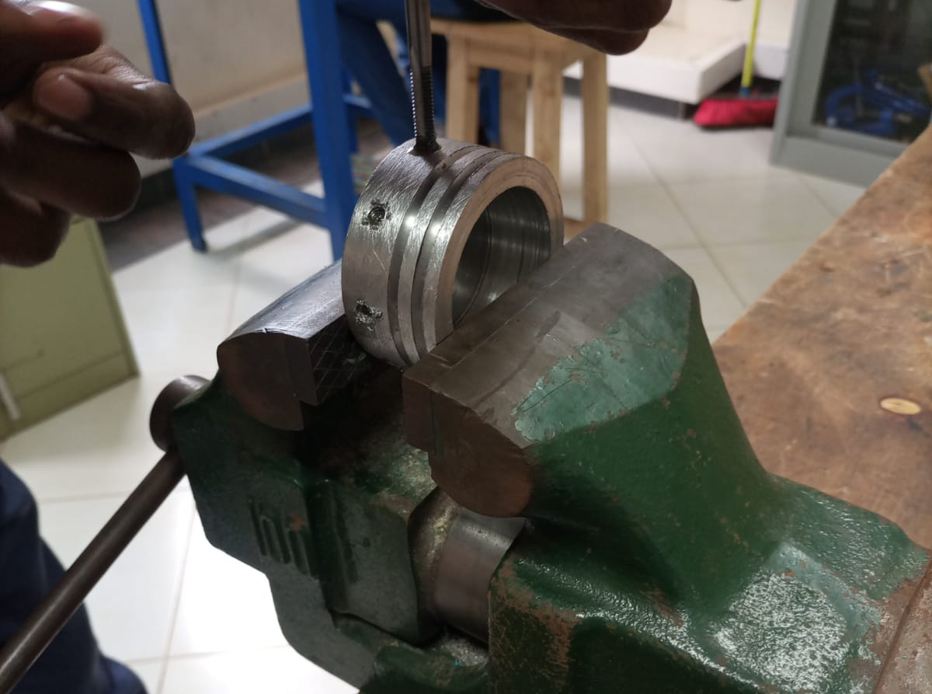
[picture p50: figure]
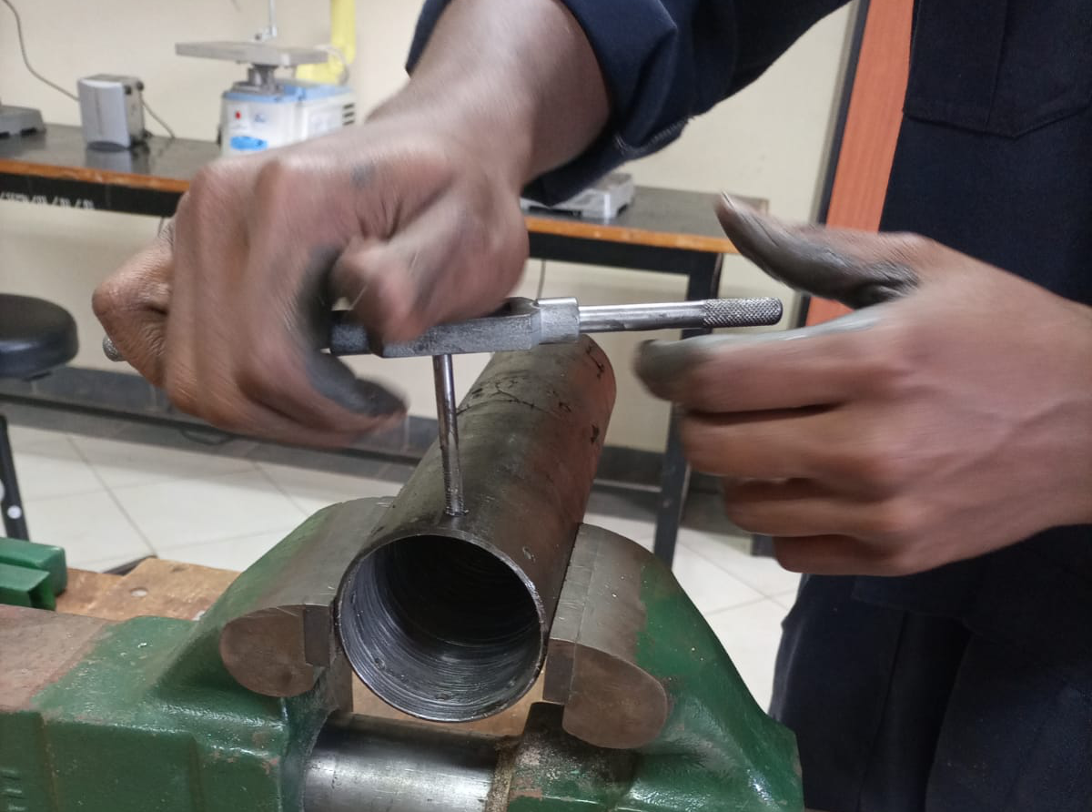
[picture p51: figure]

## ASSEMBLY

Presentation title

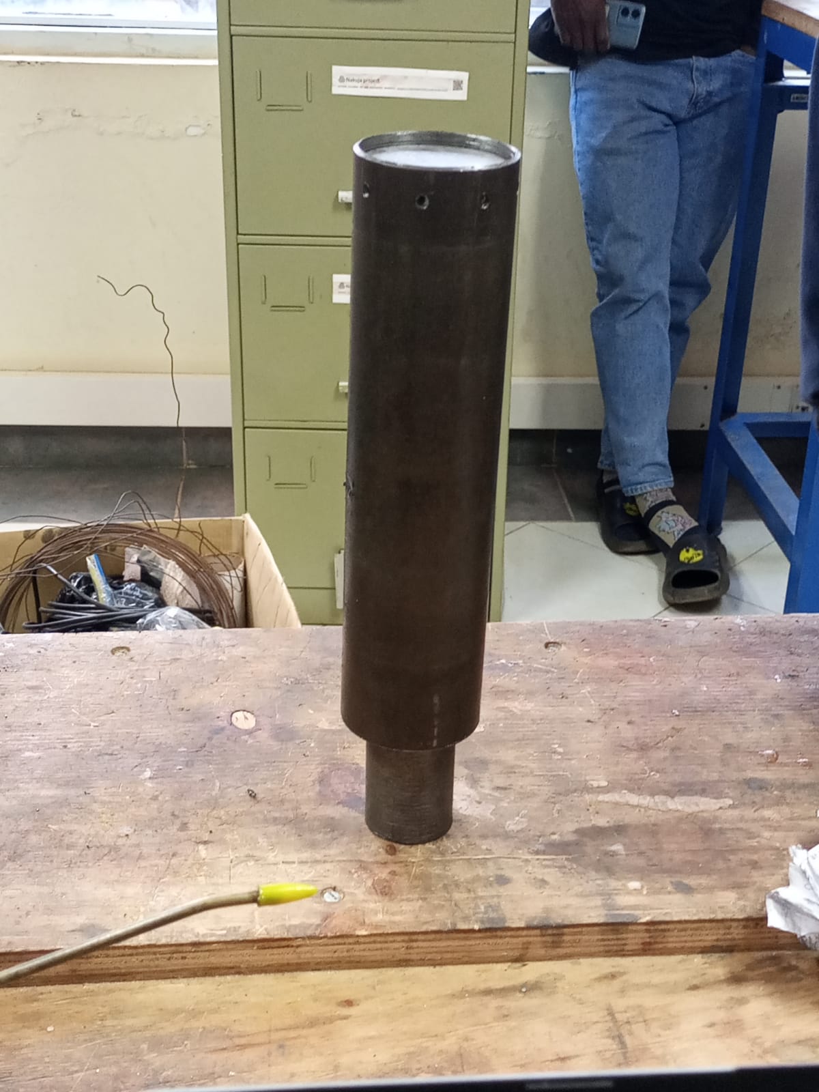
[picture p52: figure]

## STATIC TEST

https://photos.google.com/share/AF1QipPy1zYaDyku8yvup7_9s7e2EUUXyLsp6BuL0e7tGyP1ksXkVun3unHOr58JC0QGWQ/photo/AF1QipMpY0uJvHiwtVLpGcDX913BXv2ZJIp-a-Eqessq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

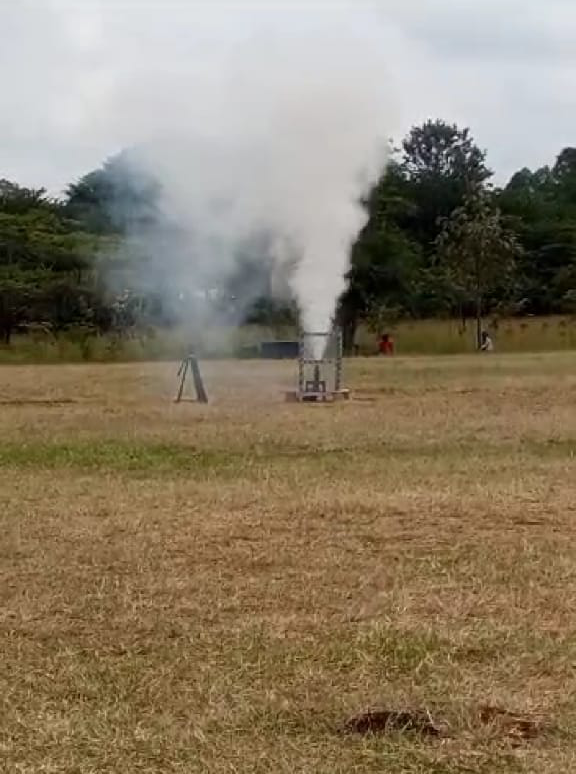
[picture p53: figure]

## RESULTS

Total impulse generated was 169Ns

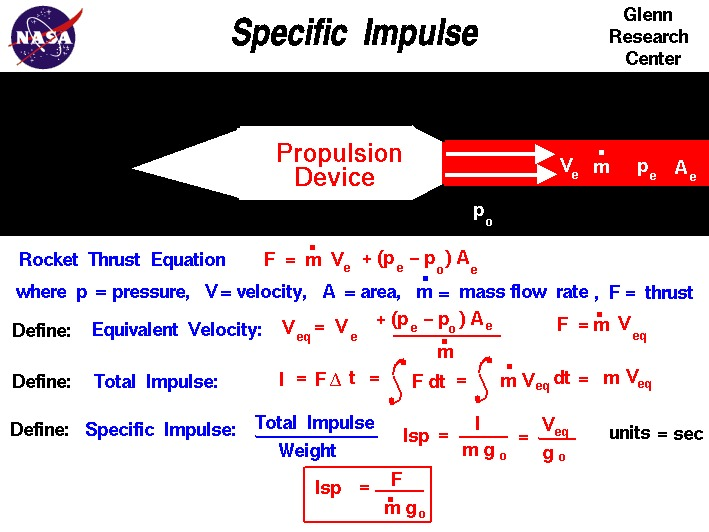
[picture p54: figure]
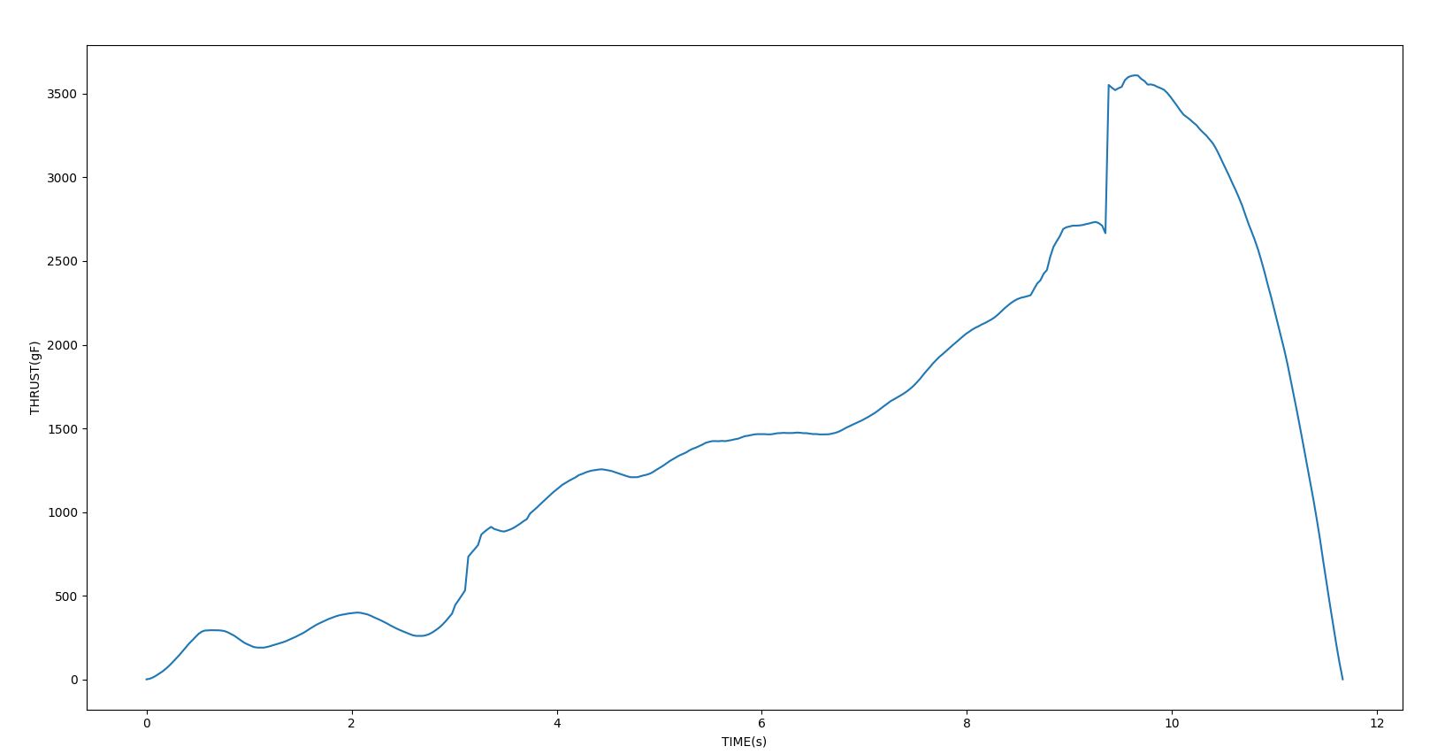
[picture p55: figure]

## CHALLENGES

- GRAINS USED DID NOT DRY

## NEXT WEEK’S OBJECTIVES

- COOK 2 GRAINS FOR SCRATCH
- REDESIGN CASING FOR ELECTRONICS
- FINISHING UP ON DESICCATOR
- PREPARE TWO GRAIN MOTOR FOR SECOND TEST

## THANK YOU

Smiling Face with No Fill
