nakujaproject/N3-Solid-_Propulsion/weeklyReports/BATCH 2  WEEK 8 REPORT.pptx

## BATCH 2

WEEK 8 SOLID TEAM REPORT

## WEEKLY OBJECTIVES

1. MODIFY THE CASE FABRICATION PROCESS.
2. COOK 1 GRAIN FROM SCRATCH.
3. CREATE MORE CASTING TOOLS.
4. PREP THE TWO GRAIN MOTOR.

## Gantt chart

https://docs.google.com/spreadsheets/d/1hBBPNcnpQUVeR51bRd35yVVWFX5lDWHhBGYU0TpIXSk/edit#gid=0


## MODIFY CASE FABRICATION PROCESS

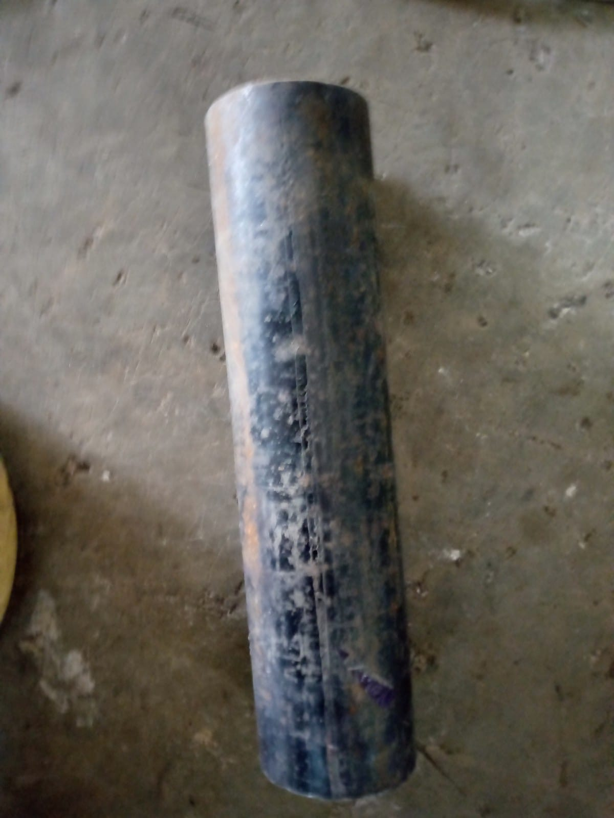
[picture p56: figure]
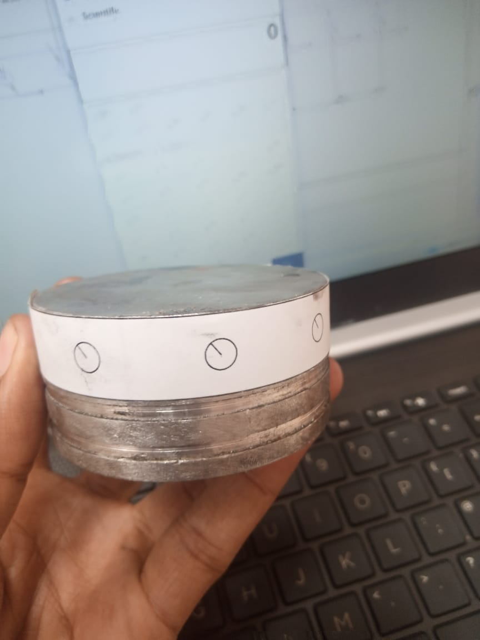
[picture p57: figure]

## PREP THE 2 GRAIN MOTOR

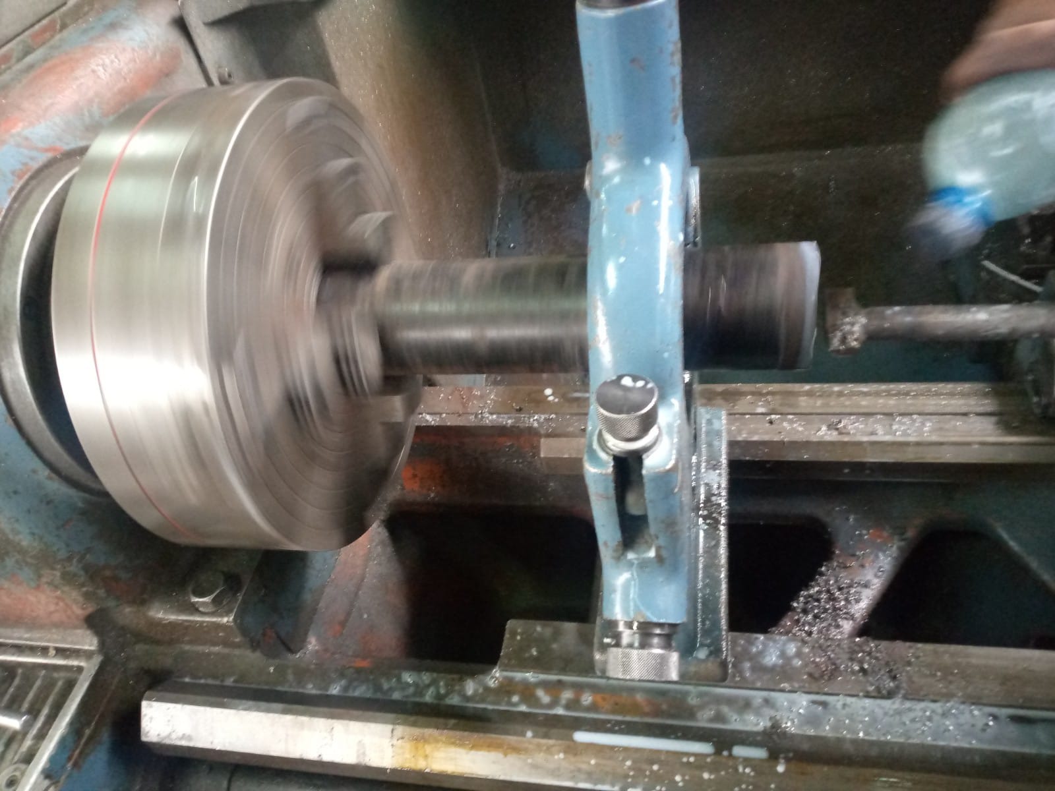
[picture p58: figure]
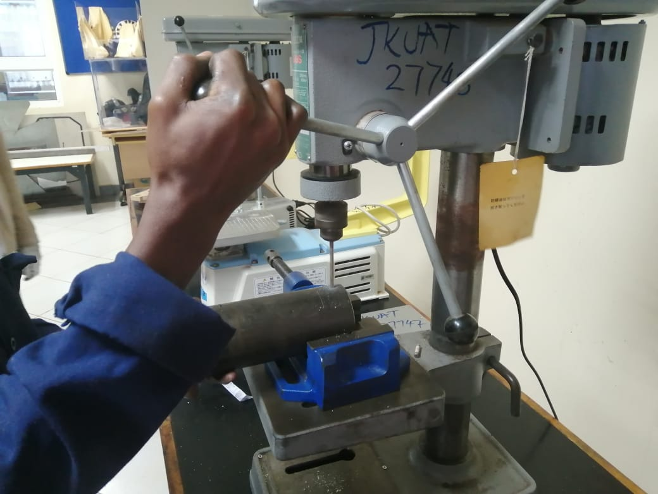
[picture p59: figure]
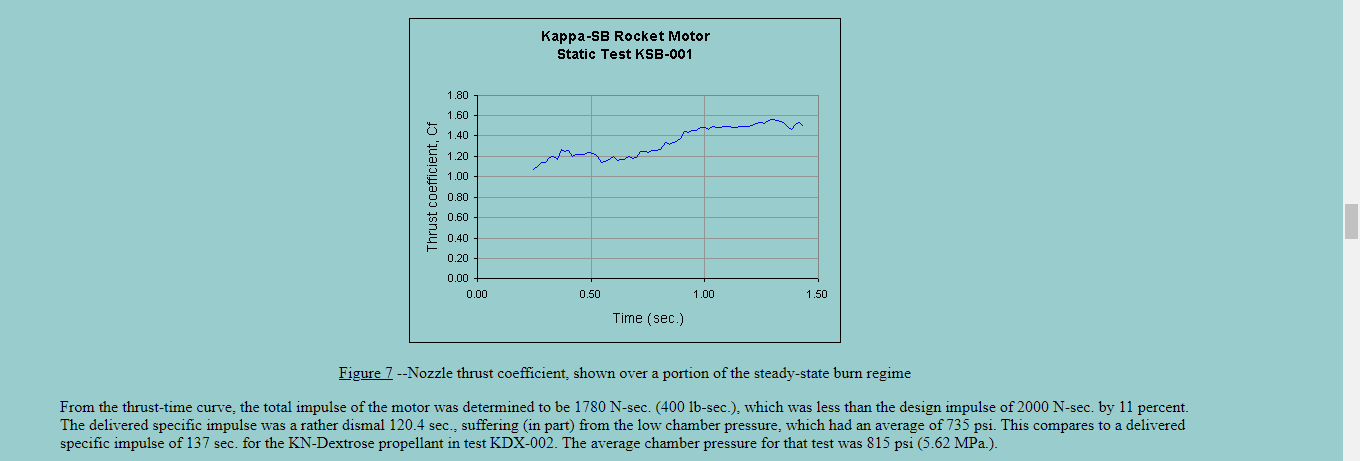
[picture p60: figure]

## COOK 1 GRAIN FROM SCRATCH

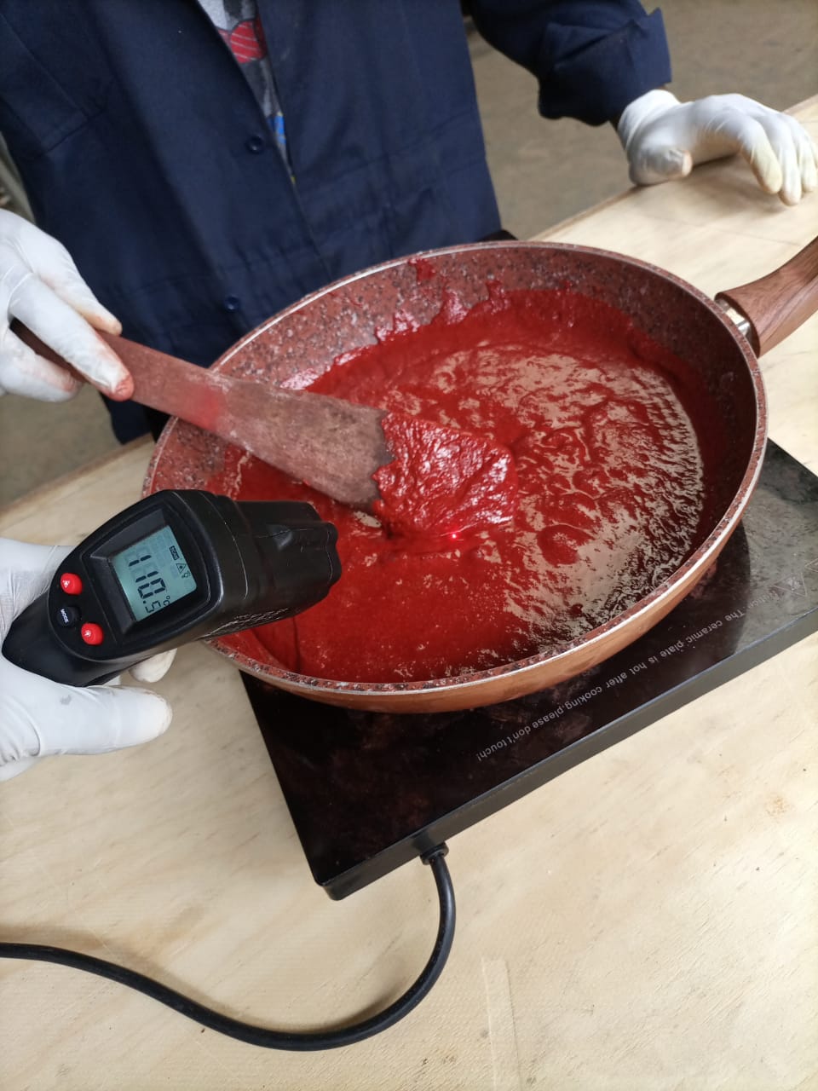
[picture p61: figure]
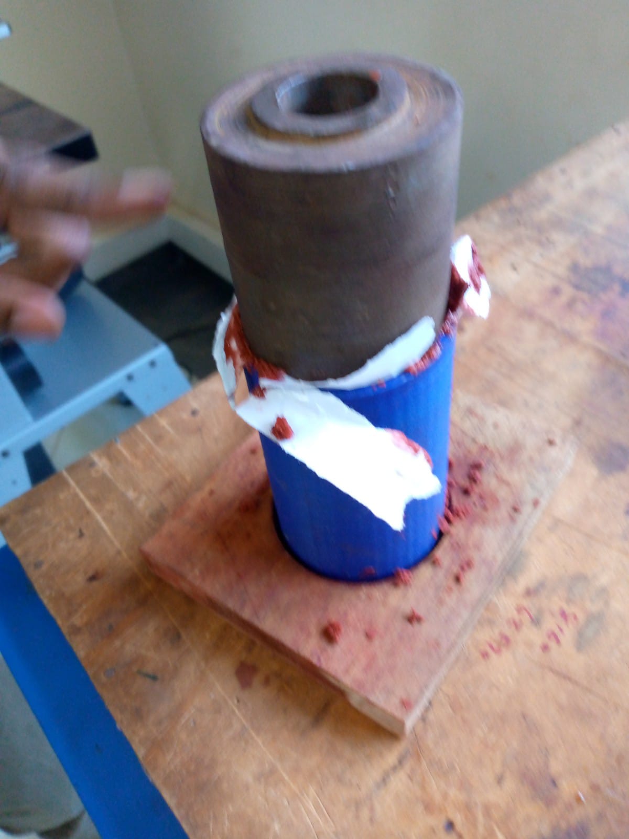
[picture p62: figure]
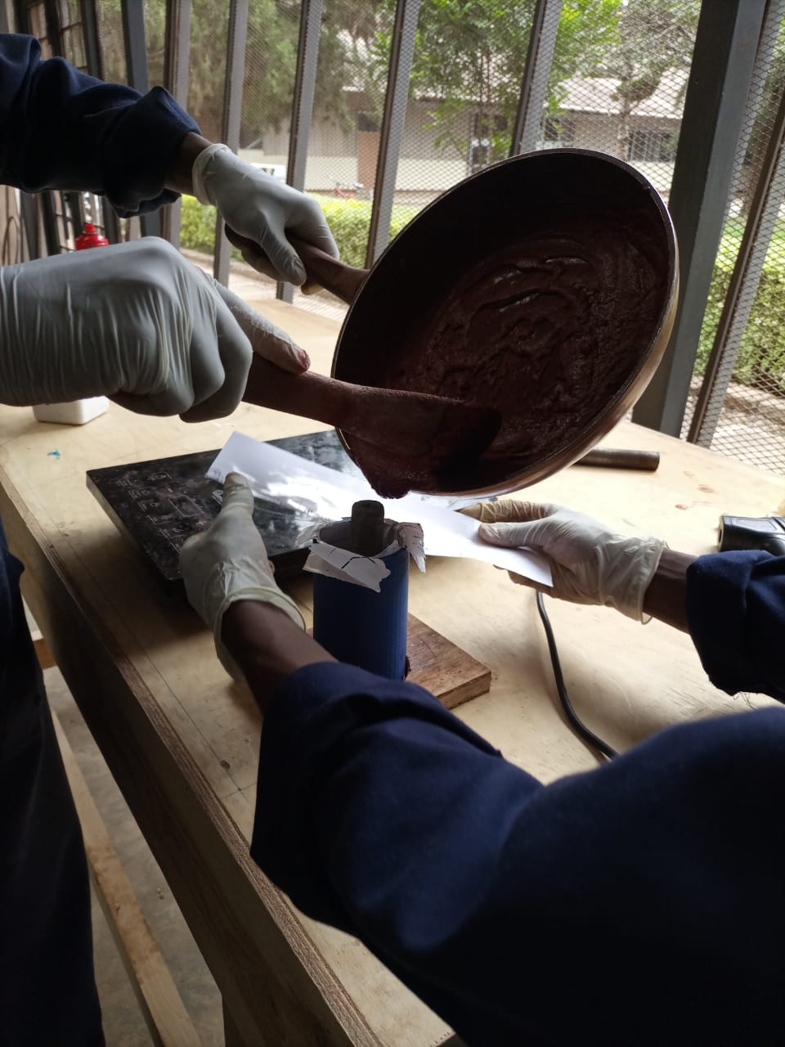
[picture p63: figure]

## CREATE MORE CASTING TOOLS

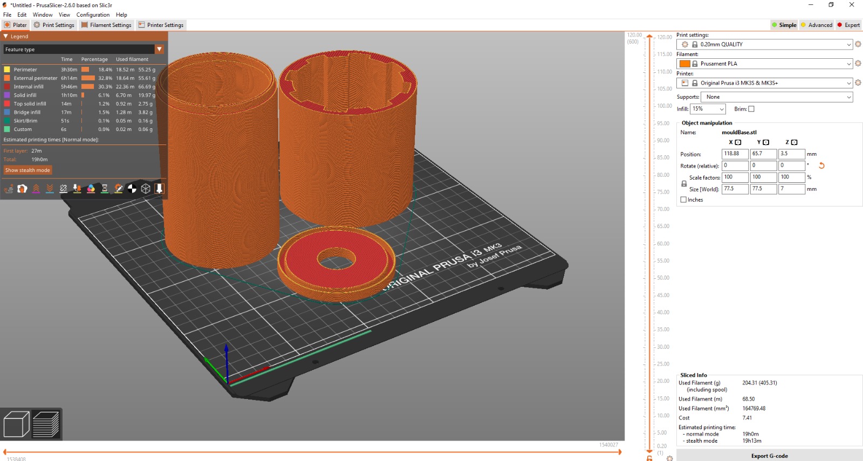
[picture p64: figure]
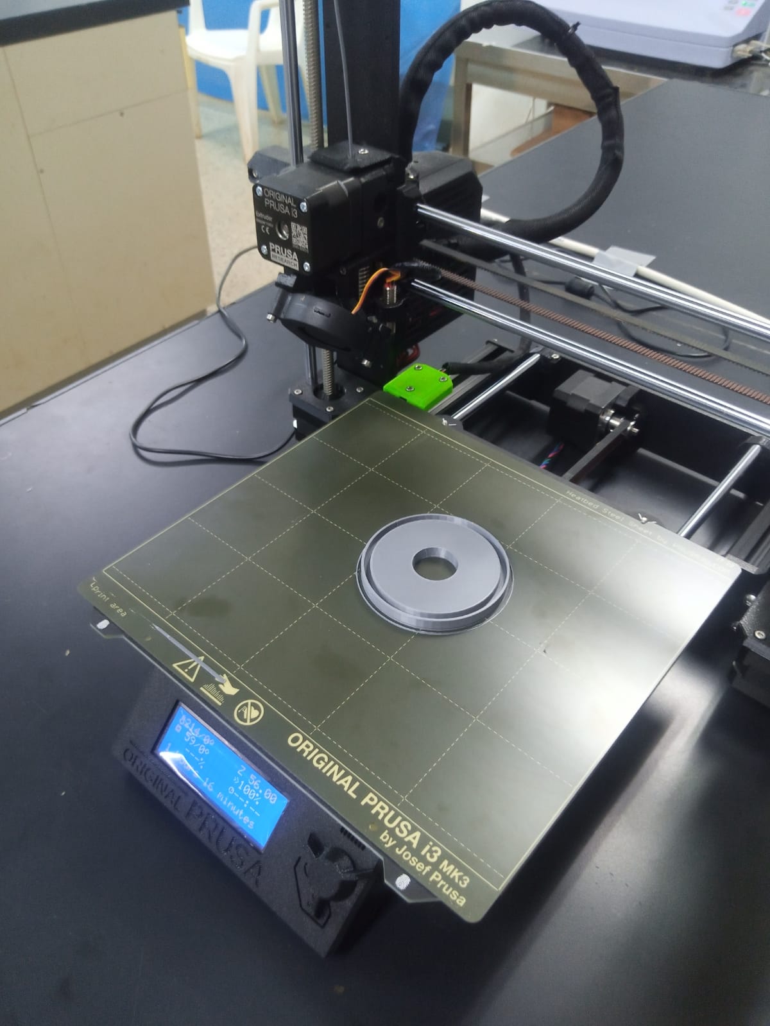
[picture p65: figure]

## NEXT WEEK’S OBJECTIVES

1. FINISH UP ON THE 2 GRAIN MOTOR.
2. COOK 2 FULL GRAINS.
3. CONDUCT STATIC TEST.

## THANK YOU
