nakujaproject/N3-Solid-_Propulsion/weeklyReports/BATCH 2 WEEK 3 REPORT.pptx

## BATCH 2 WEEK 3 REPORT

## This weeks objectives:

1. Ascertain the credibility of the use of bolts in holding the nozzle and the bulkhead
2. Test the load cell instrumentation system
3. Prepare one propellant grain
4. Search for a material to fabricate an N2 case

## Slide 3

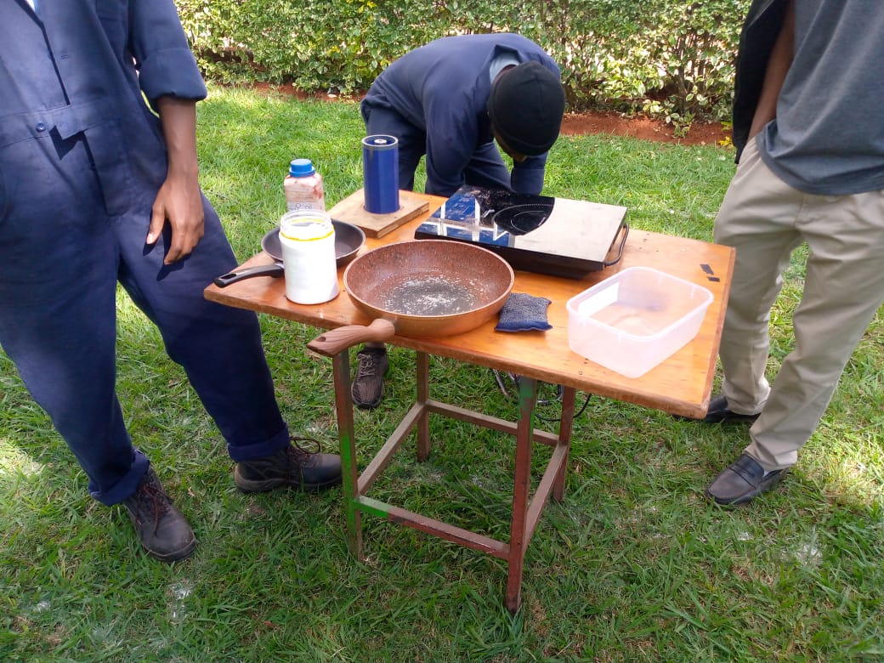
[picture p66: figure]
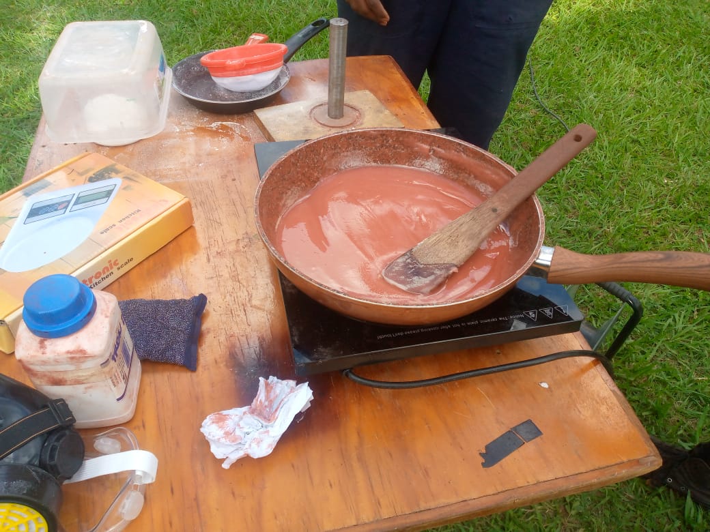
[picture p67: figure]
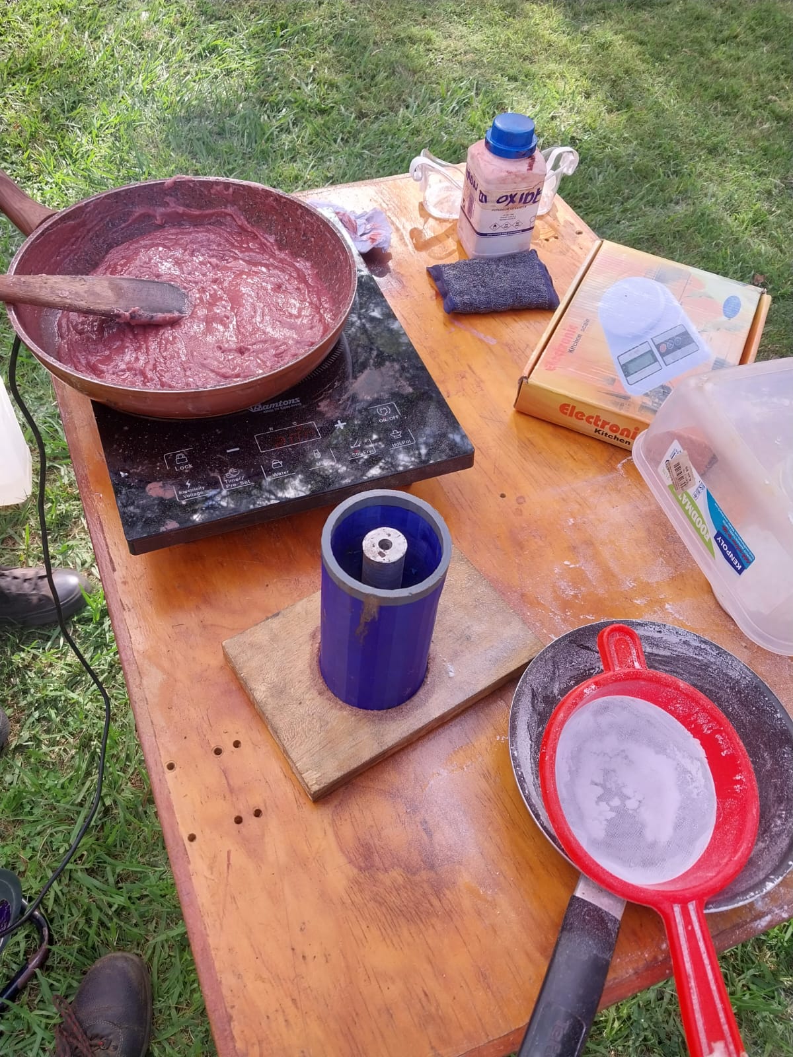
[picture p68: figure]
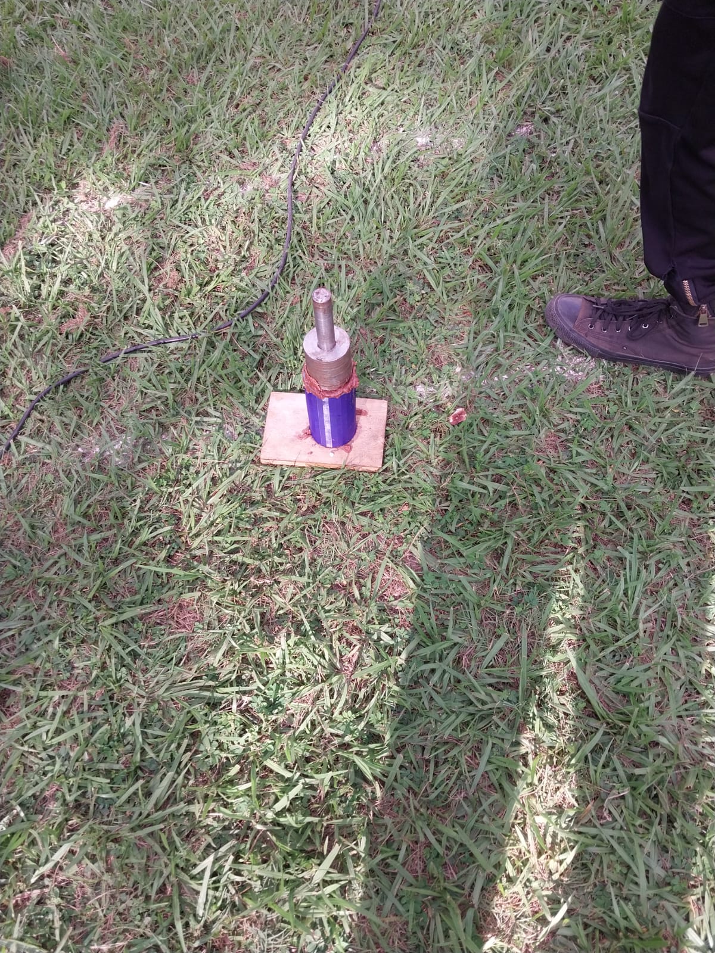
[picture p69: figure]

## Open motor simulation:

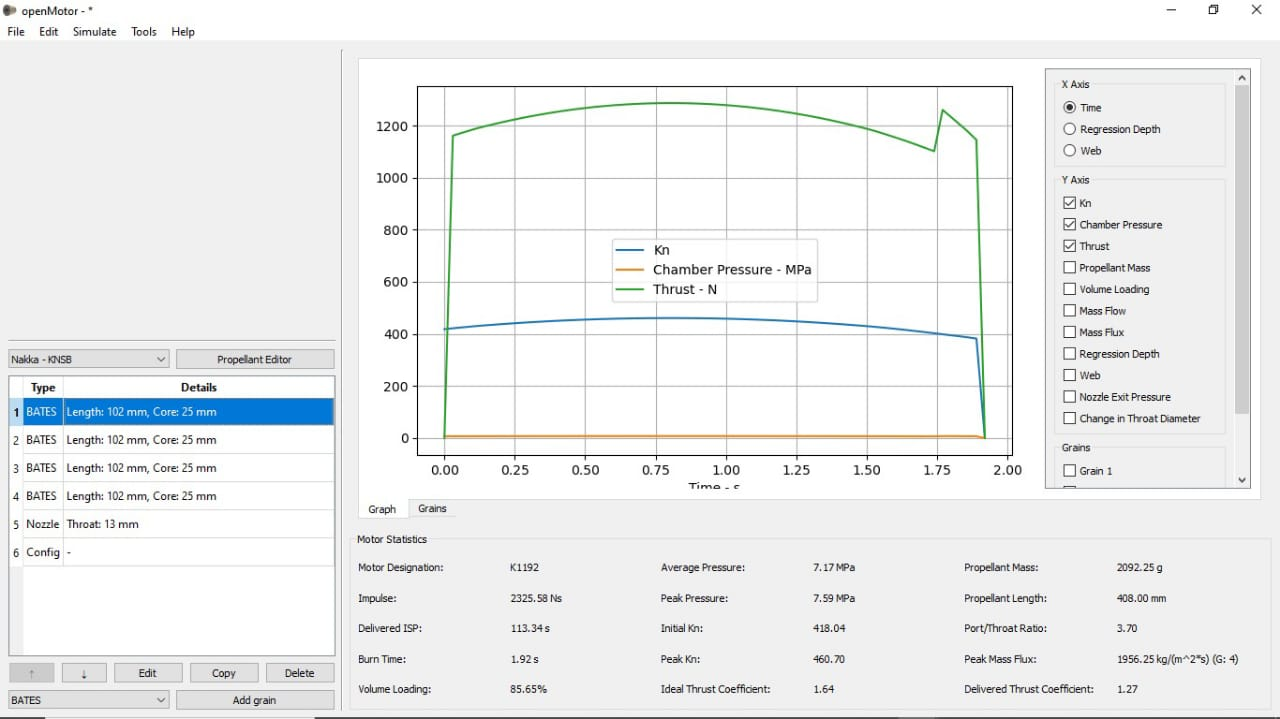
[picture p70: figure]

Finding: peak chamber pressure 7.59 MPa

## Slide 5

Converting the chamber pressure to force (F):

=chamber pressure×cross area=(7.59×10^6 )×(π×(0.034)^2 )

FORCE GENERARED = 27564 N

=8×π×(3 ×10^(−3) )^2 =2.262 ×10^(−4) m^2

Bolt surface area subjected to the shear force:

Shear stress generated on the bolts:

=(FORCE)/(AREA)=27564/(2.262×10^(−4))= 122MPa

FINDING:
Since the shear yield strength of stainless steel is 303MPa
Achieving a safety factor=2.97

## Load cell testing:

- Issues:
- Nrf24101+ module transmits noisy data
- Suggested solution:
- Utilize EEPROM(AT24C256) to temporarily store data

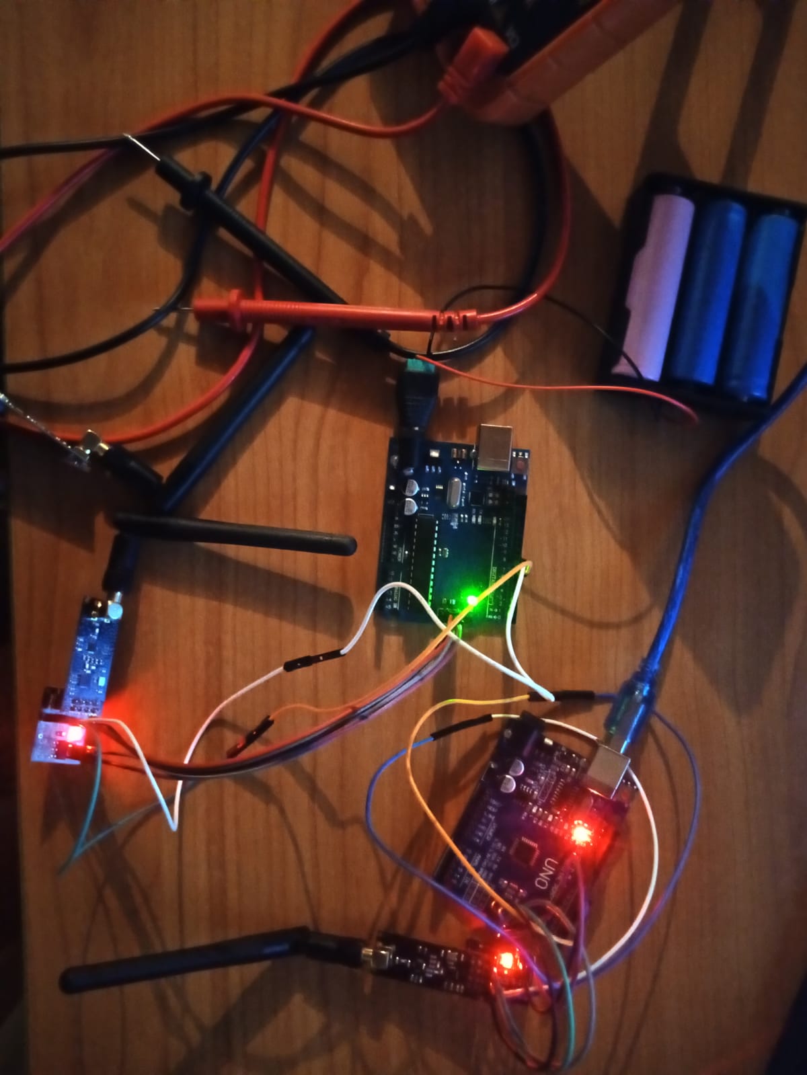
[picture p71: figure]

## THE TEST STAND SUPPORTS

- Settled on bolting as a means of connecting the supports as opposed to welding

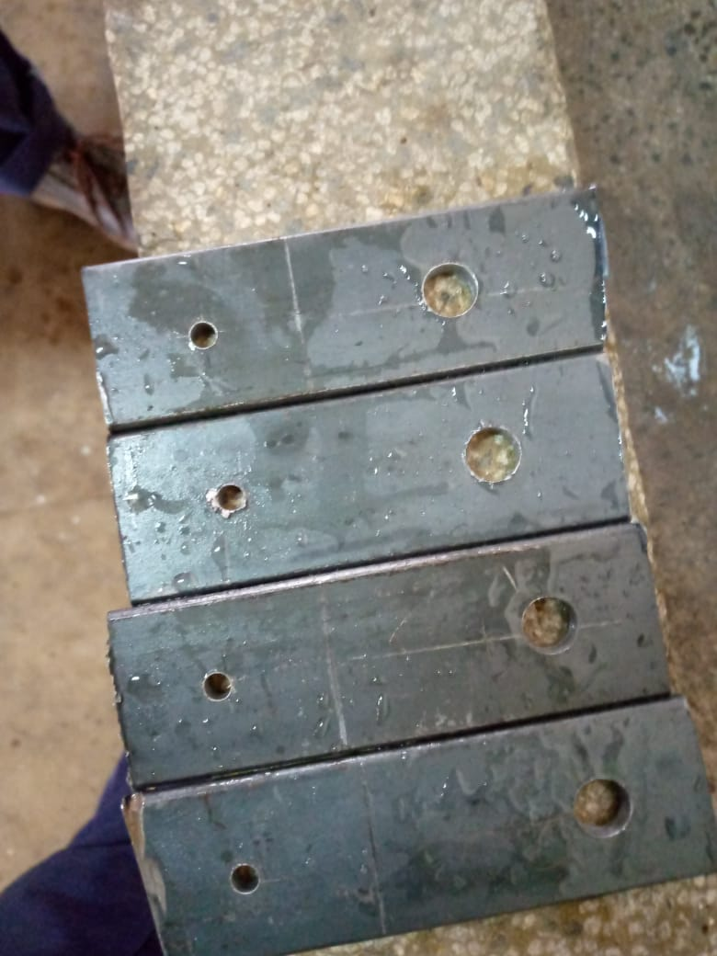
[picture p72: figure]
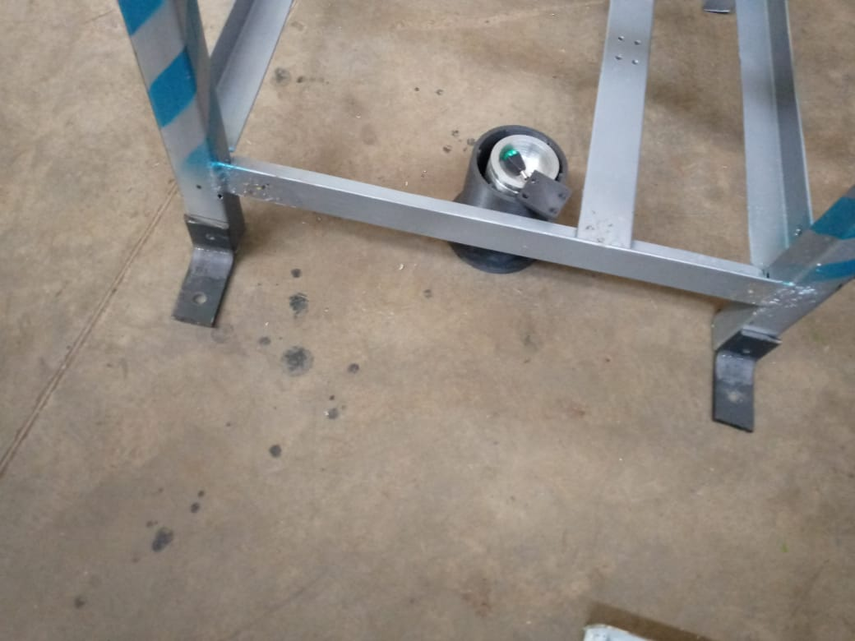
[picture p73: figure]

## Next weeks objectives:

- Melt and recast the previous cooked grains
- Continue search for a 2 1/2" SCH40 pipe for the N2 case
- Modify the test stand to accommodate the N2 motor
- Continue testing the loadcell instrumentation system
