nakujaproject/N3-Solid-_Propulsion/weeklyReports/BATCH 2 WEEK 2.pptx

## BATCH 2

WEEK 2 REPORT

## WEEK’S OBJECTIVES

- 1. FINISH MACHINING 2ND CASING
- 2. FINALIZE INSTALLEMENT OF POLYCARBONATE SHEETS ON TEST STAND
- 3. CREATE A GANTT CHART
- 4. PROOF THAT THE BOLTS AND O-RINGS METHOD IS SUFFICIENT FOR CASING , NOZZLE & BULKHEAD JOINING.
- 5. COOK A TEST GRAIN.
- 6. REFINE LOAD CELL READING AND VALUE TRANSMISSION CODE.

## FINISHED MACHINING OF THE SECOND CASING

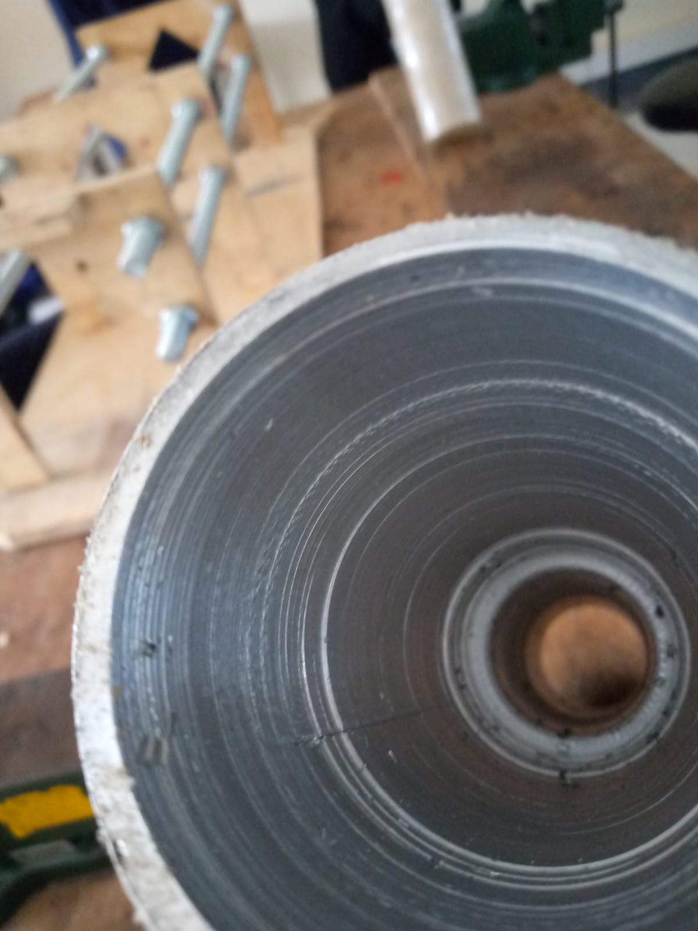
[picture p74: figure]
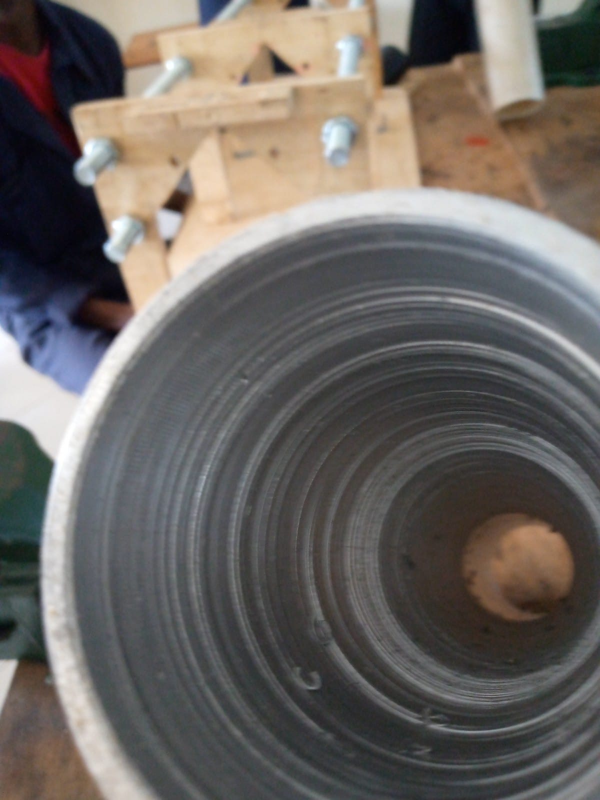
[picture p75: figure]

1. Temporarily paused fabrication.
- Awaiting a proper boring tool
- but the work is almost complete

## COMPLETED INSTALLEMENT OF POLYCARBONATE SHEETS

1. Need:
- -20 m6 bolts needed for complete assembly.
- - Mesh for top part

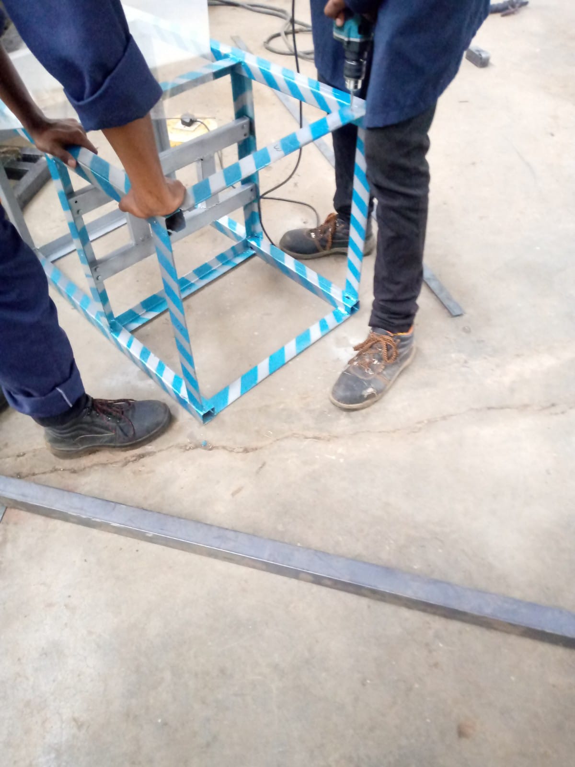
[picture p76: figure]

## EXAMINED AND REFINED LOAD CELL CODE

1. https://gist.github.com/Collins-Omariba/2d21948d538d4a60c9a962925e4371f2
2. https://gist.github.com/Collins-Omariba/1e220c2707260a9d6de4eb6ad4a623cc

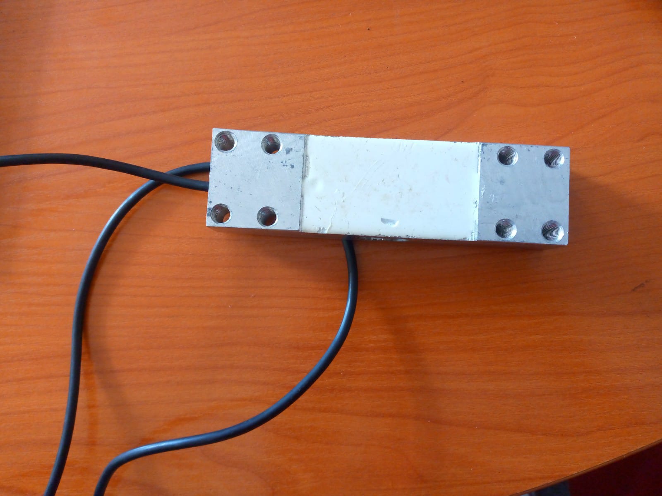
[picture p77: figure]

## SOLID MOTOR ASSEMBLY

- OUR DESIGN

- KAPPA MOTOR ON NAKKA’S WEBSITE

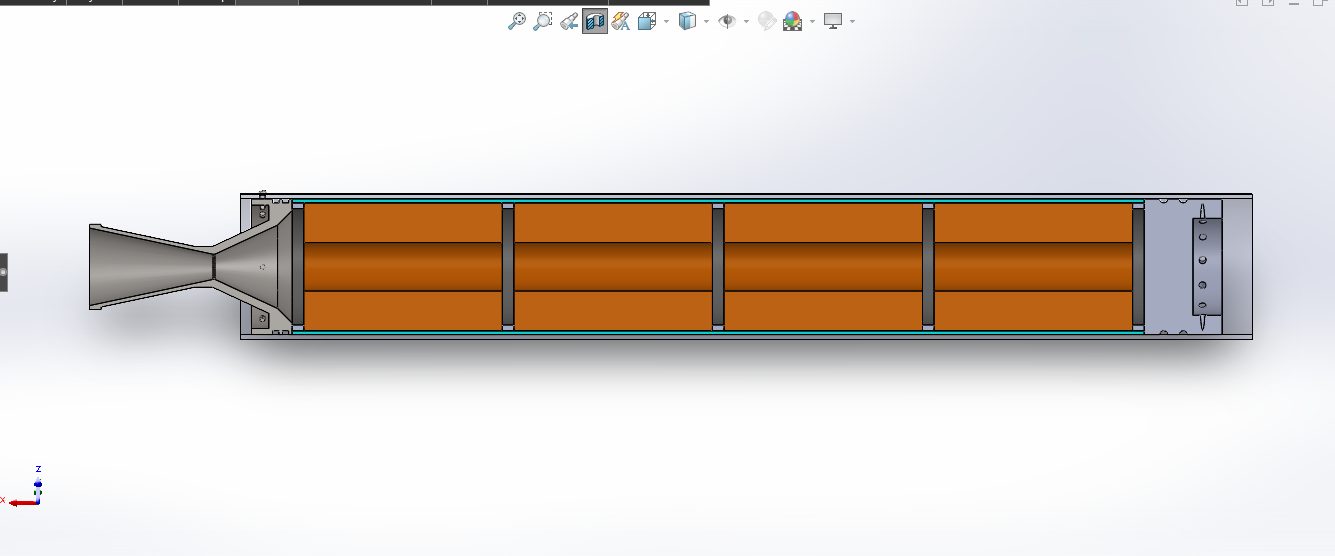
[picture p78: figure]
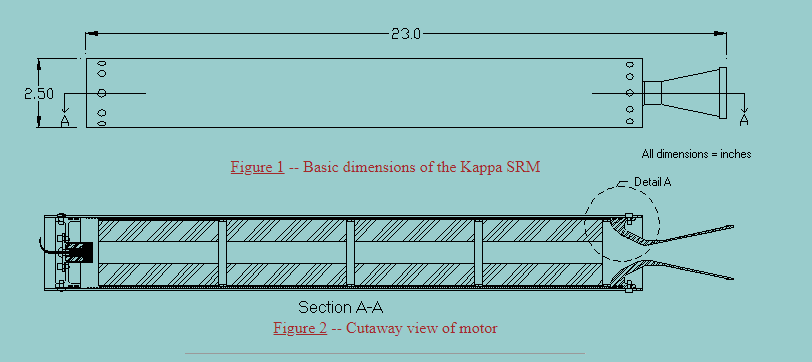
[picture p79: figure]

## NOZZLE & JOINING MECHANISM

- KAPPA MOTOR ON NAKKA’S WEBSITE

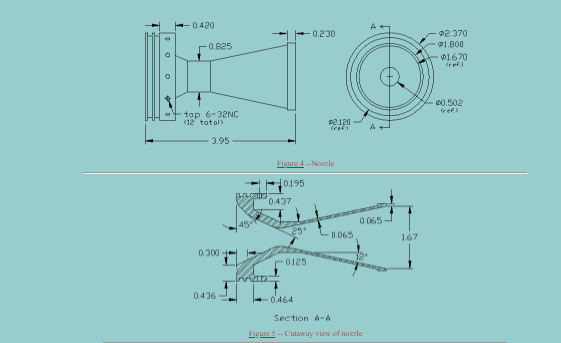
[picture p80: figure]

- OUR DESIGN

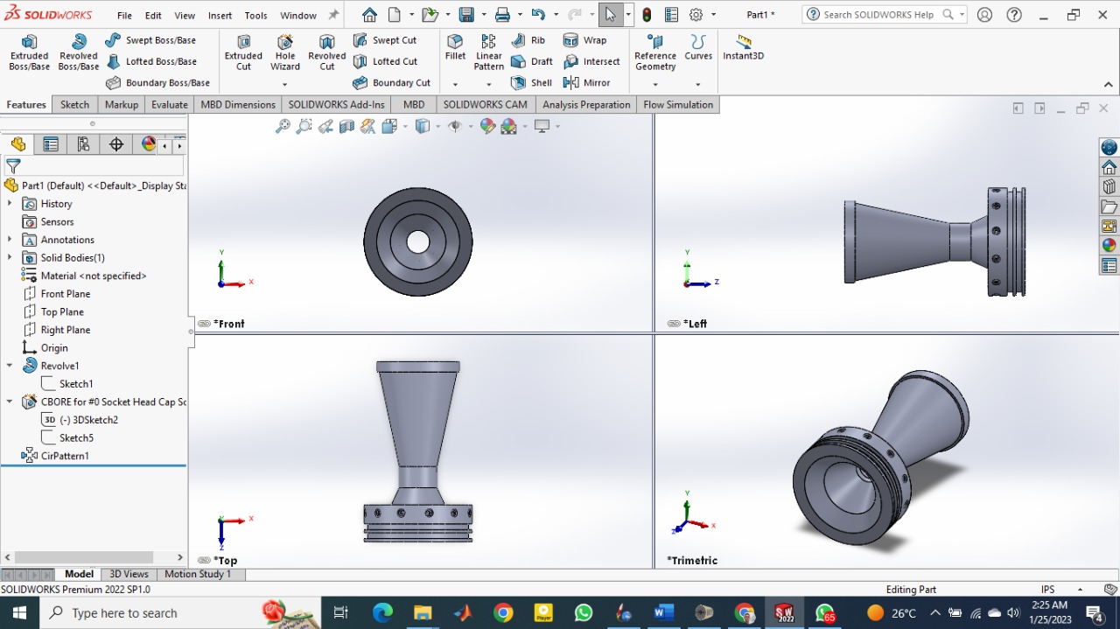
[picture p81: figure]

- The comparison between the 2 proves that the method of joining using bolts & O-rings will work.
- Currently working on the calculations.

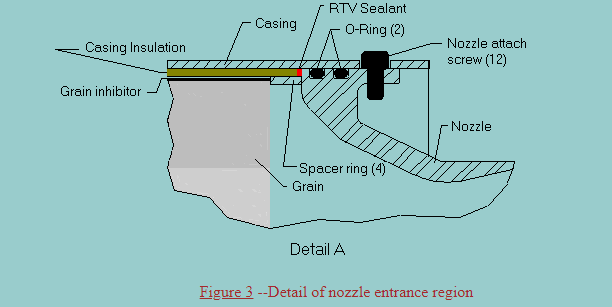
[picture p82: figure]

## GANTT CHART

- https://docs.google.com/spreadsheets/d/1hBBPNcnpQUVeR51bRd35yVVWFX5lDWHhBGYU0TpIXSk/edit#gid=0

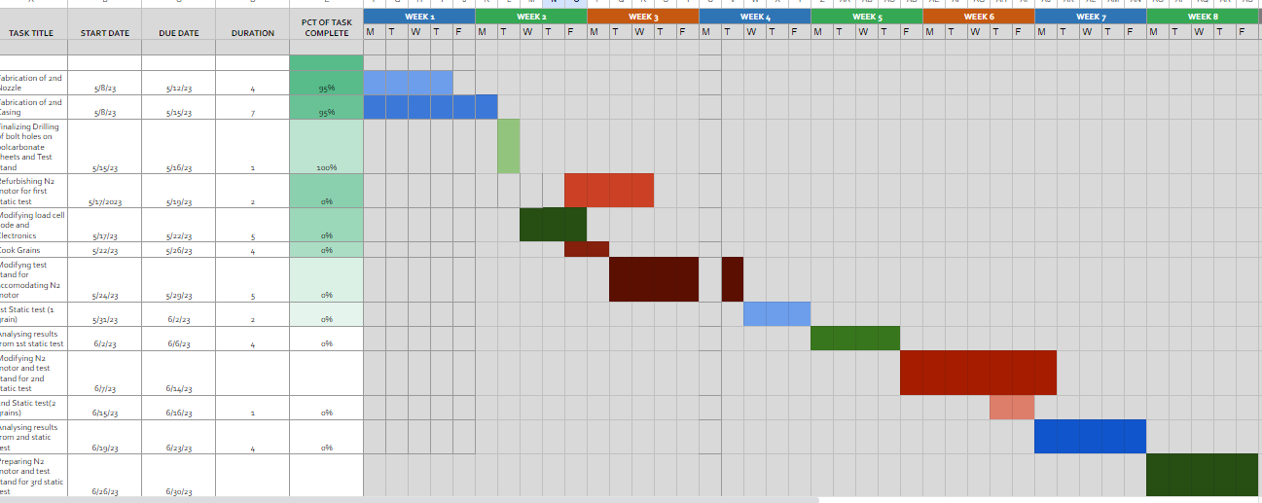
[picture p83: figure]

## CHALLENGES ENCOUNTERED

- 1. LOW TURN UP OF MEMBERS
- 2. INEFFECTIVE BORING TOOL

## NEXT WEEK’S OBJECTIVES

- 1. COOK 1 FULL GRAIN
- 2. COMPLETELY ASSEMBLE THE TEST STAND
- 3. FURTHER RESEARCH ON THE USAGE OF BOLTS & O-RINGS JOINING METHOD.
- 4. FABRICATE 1 GRAIN MOTOR FOR 1ST STATIC TEST
- 5. FABRICATE N2 MOTOR FOR A MINIATURIZED STATIC TEST
