nakujaproject/N3-Solid-_Propulsion/weeklyReports/WEEK_2_EDITED.pptx

## WEEK 2

Motor configuration, nozzle and casing

## Slide 2

## MOTOR

- The grain structure that brought desired results was the bates configuration.
- The dimensions are as follows:
- 1. Length – 102mm x 4 cartridges
- 2. Diameter – 60mm
- 3. Core diameter – 20mm

## Simulation results

1. Average pressure – 6.57Mpa
2. Peak pressure – 7.52Mpa
3. ISP – 115.77seconds
4. Burn time – 1.83seconds
5. Motor Designation – K1095
6.

## Properties from simulation

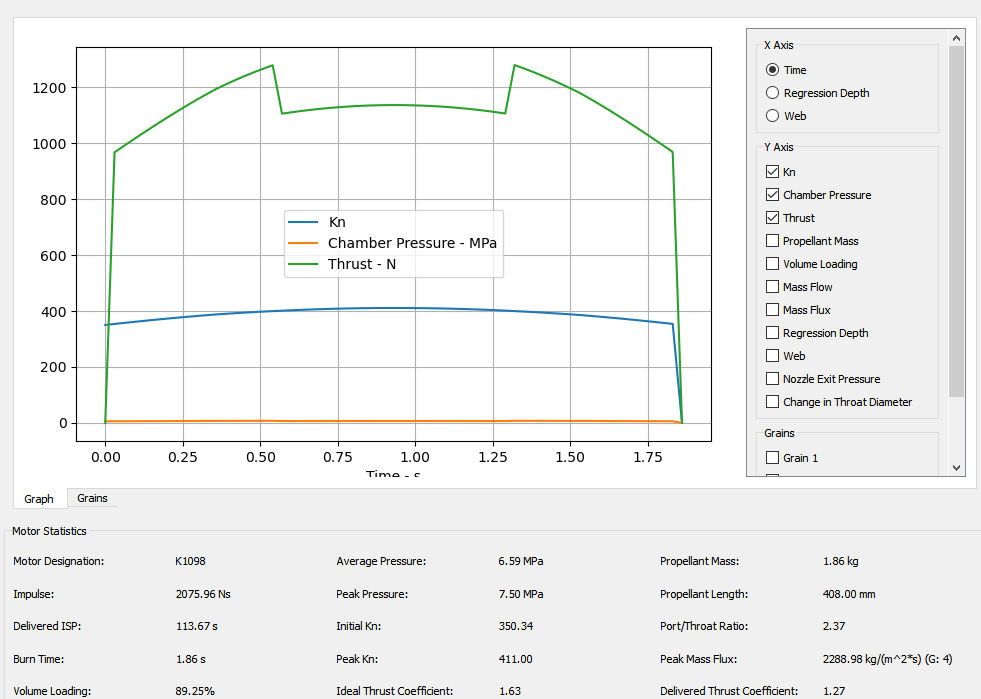
[picture p98: figure]

## NOZZLE

the nozzle configurations are as follows
1. Throat diameter - 13.000000 mm
2. Exit diameter – 40.00000mm
3. Divergence half angle – 12 degrees
4. Convergence half angle – 25 degrees
5. Throat length – 3mm

## Nozzle diagrams


## Section view

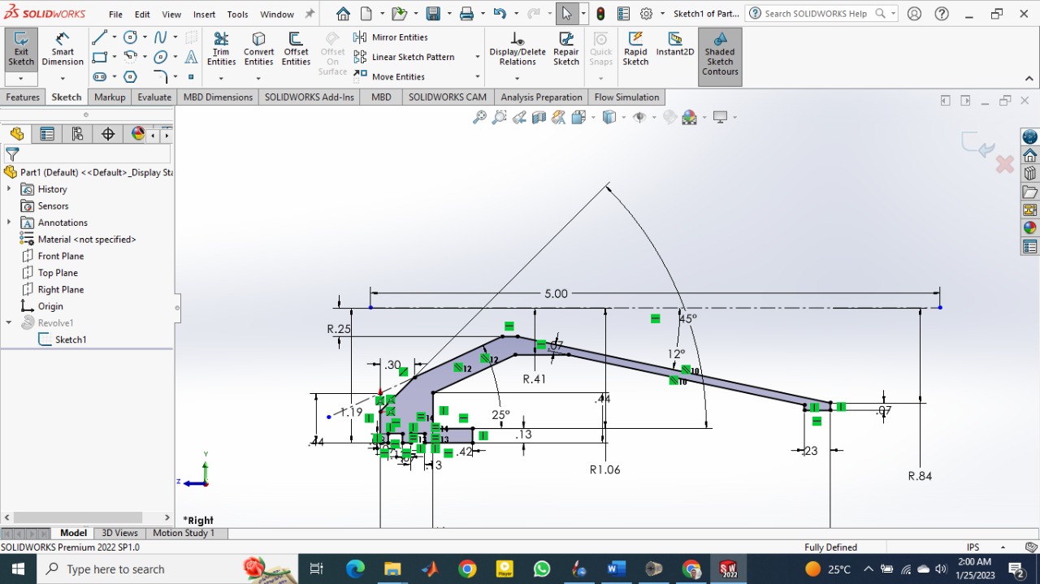
[picture p99: figure]

## Casing

- The casing of choice was Aluminum 6063 of density 2690kg/mm3 and yield strength 214Mpa
- Casing external diameter – 70mm
- Casing thickness taking a safety factor of 2 – 2.5mm
- BURST PRESSURE – 23.75Mpa
