nakujaproject/N3-Solid-_Propulsion/Nakuja _ Solid Propulsion.pdf

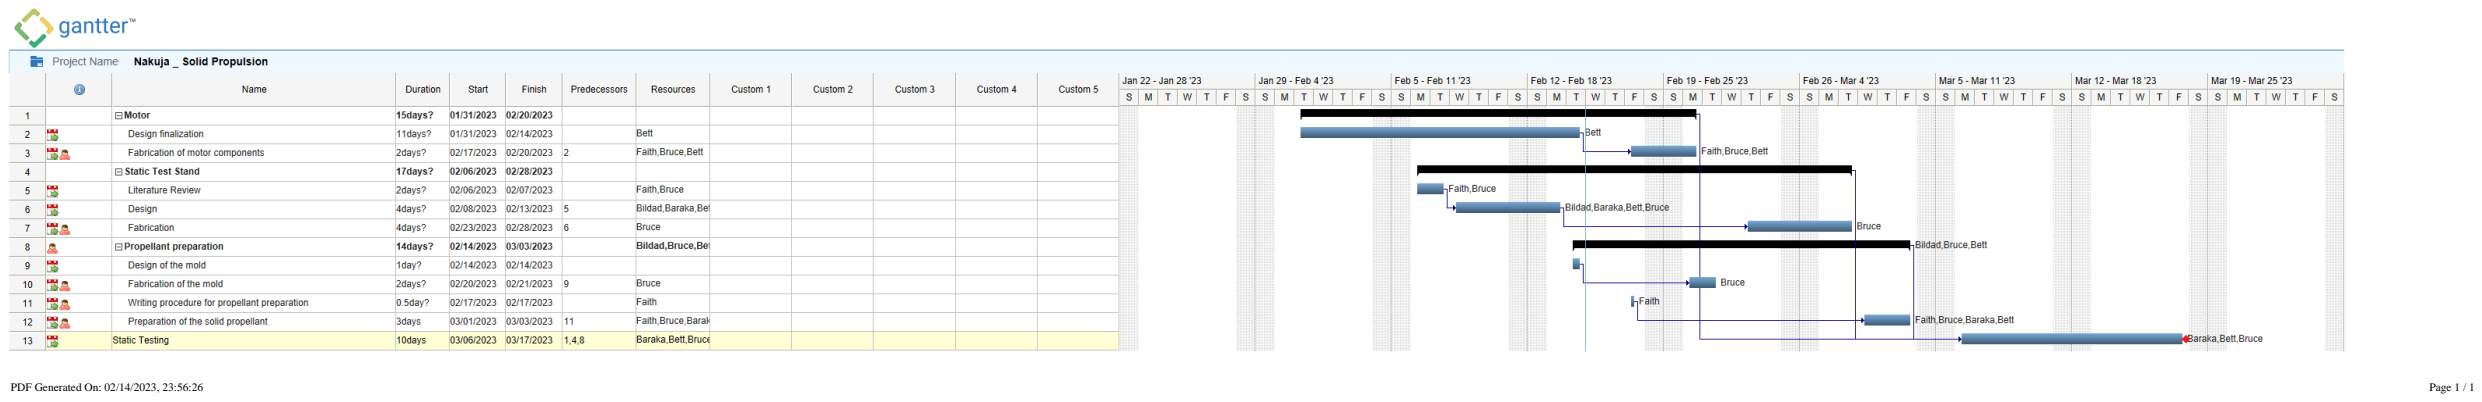
[picture p107: page 1]

PDF Generated On: 02/14/2023, 23:56:26

Page 1 / 1
