nakujaproject/N3-Solid-_Propulsion/CAD_files/mould 4.0/Screenshot (15).png

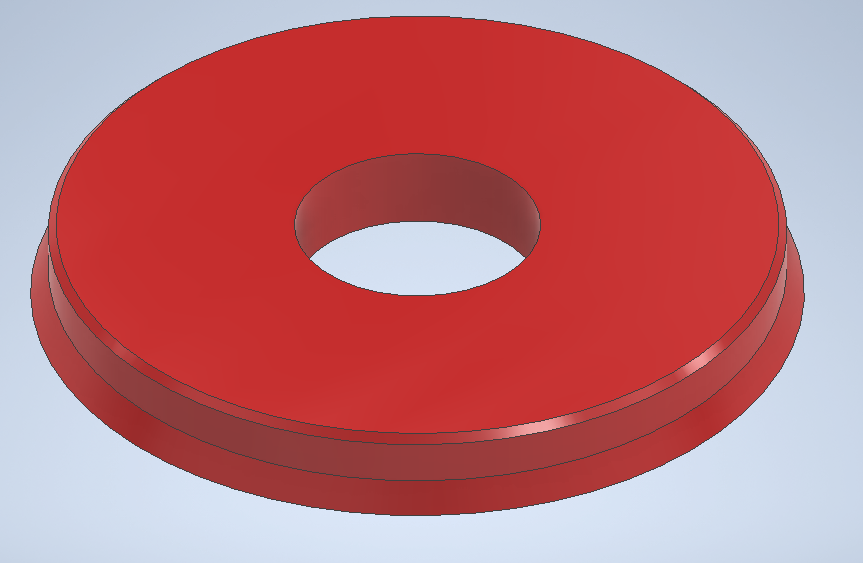
CAD_files/mould 4.0/Screenshot (15).png
