nakujaproject/N3-Solid-_Propulsion/FlightData_N3_launch/OpenMotor/OpenMotor.jpeg

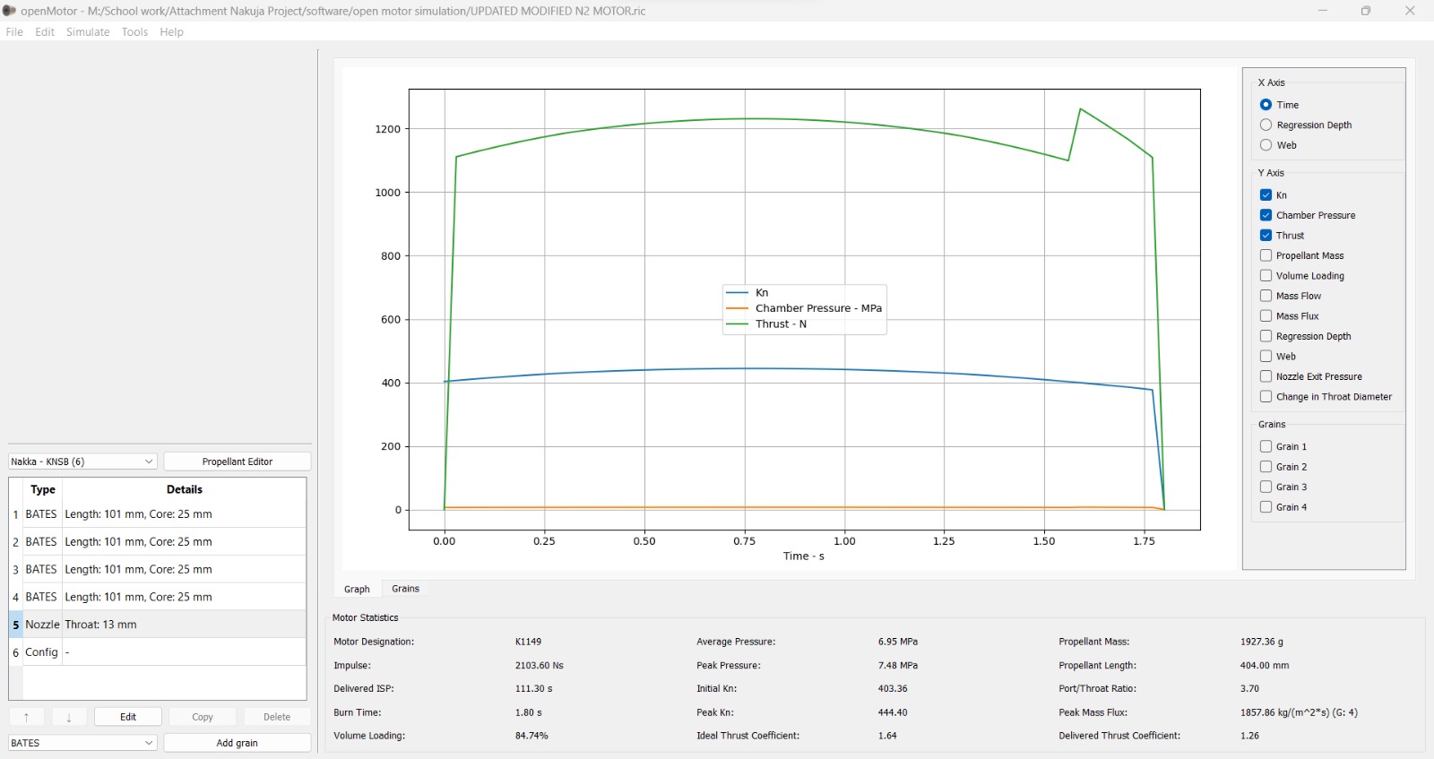
FlightData_N3_launch/OpenMotor/OpenMotor.jpeg
