nakujaproject/N3-Solid-_Propulsion/Images/225c4aa0-7e10-440a-aaa2-5c5255d45535.jpeg

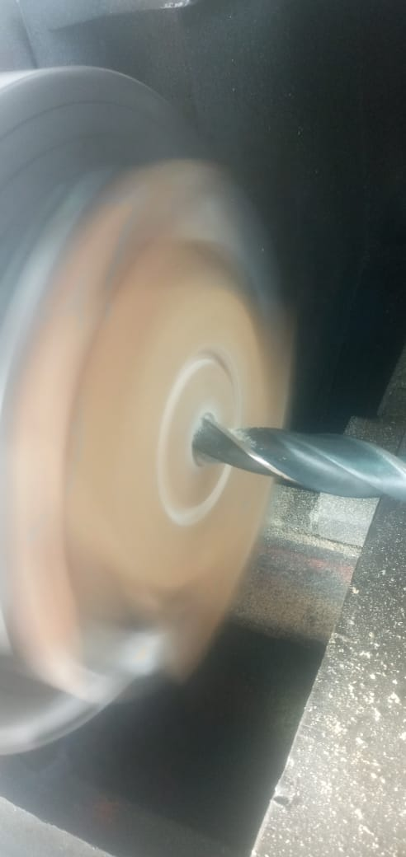
Images/225c4aa0-7e10-440a-aaa2-5c5255d45535.jpeg
