nakujaproject/N3-Solid-_Propulsion/Images/ba4d772a-c9c4-40f6-83b1-45494b9b7f9e.jpeg

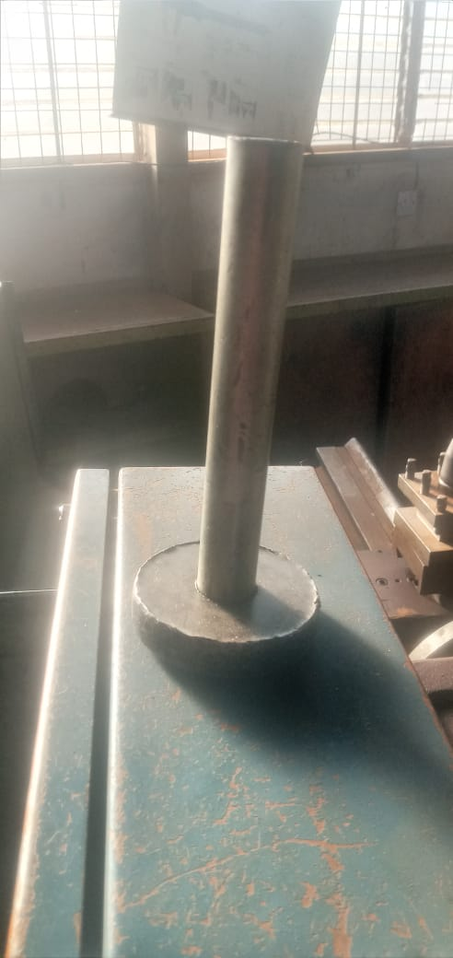
Images/ba4d772a-c9c4-40f6-83b1-45494b9b7f9e.jpeg
