nakujaproject/N3-Solid-_Propulsion/Images/final.png

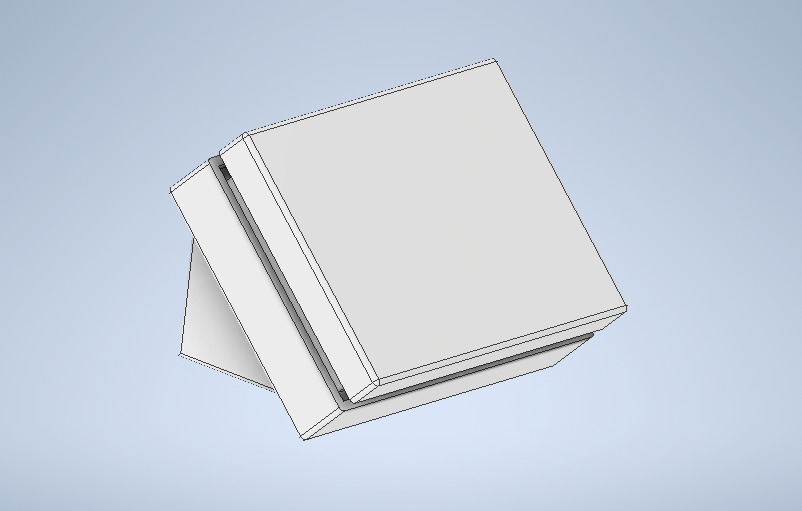
Images/final.png
