nakujaproject/N3-Solid-_Propulsion/FlightData_N3_launch/Motor_design_mildsteel_casing/CAD/motor1.SLDASM

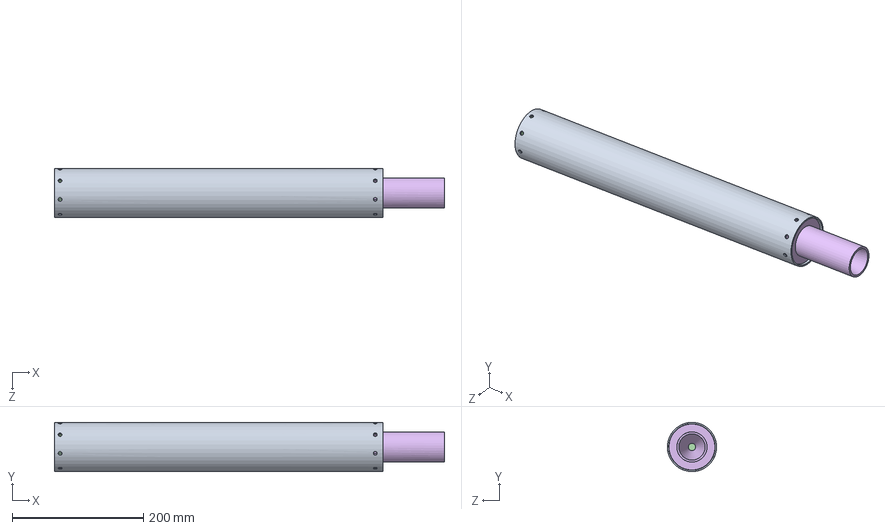
[picture p118: CAD file, 2023-11-21]
FlightData_N3_launch/Motor_design_mildsteel_casing/CAD/motor1.SLDASM
594.0 x 74.9 x 74.9 mm
casing
spacer x 5
propellant x 4
bulkhead
liner
nozzle6
