nakujaproject/N3-Solid-_Propulsion/CAD_files/mouldBase.stl

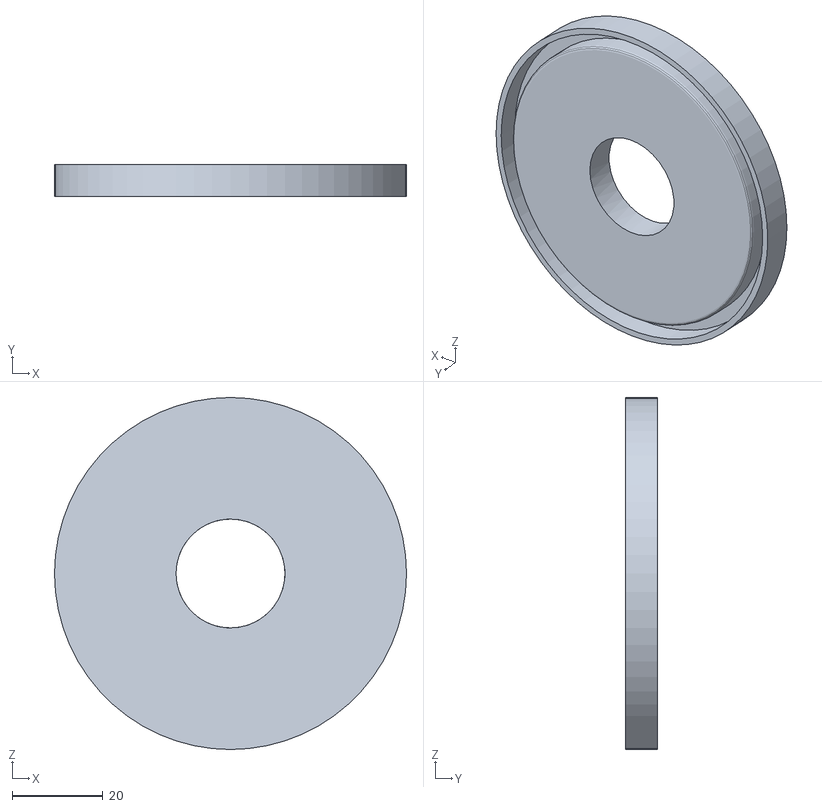
[picture p119: CAD file, 2023-06-30]
CAD_files/mouldBase.stl
77.5 x 7.00 x 77.5
