nakujaproject/N3-Solid-_Propulsion/FlightData_N3_launch/Motor_design_Aluminum_casing/CAD/spacer.SLDPRT

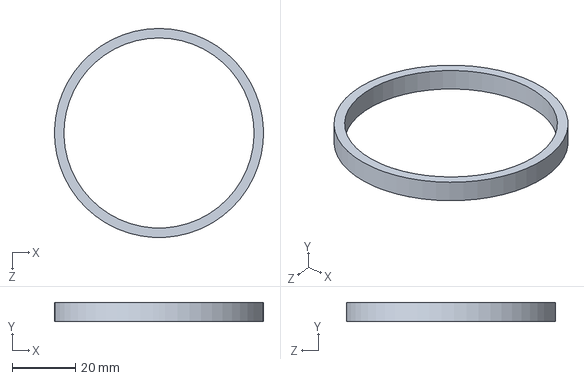
[picture p120: CAD file, 2023-11-21]
FlightData_N3_launch/Motor_design_Aluminum_casing/CAD/spacer.SLDPRT
66.0 x 6.00 x 66.0 mm
