nakujaproject/N3-Solid-_Propulsion/FlightData_N3_launch/Motor_design_mildsteel_casing/CAD/nozzle3.SLDPRT

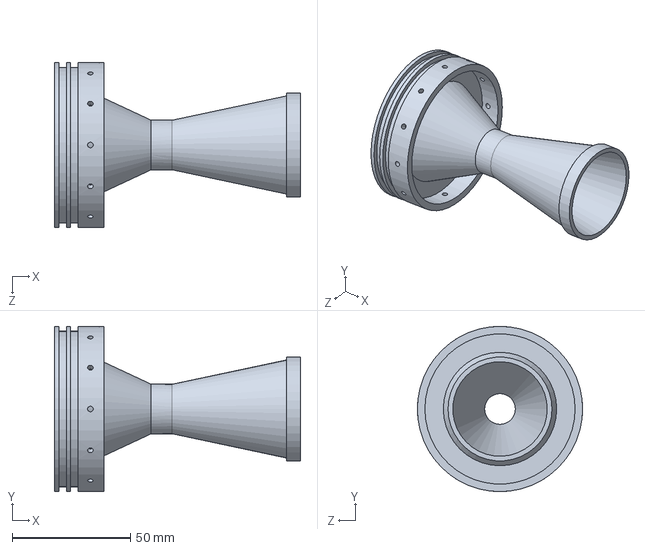
[picture p121: CAD file, 2023-11-21]
FlightData_N3_launch/Motor_design_mildsteel_casing/CAD/nozzle3.SLDPRT
104.2 x 70.0 x 70.0 mm
