nakujaproject/N3-Solid-_Propulsion/FlightData_N3_launch/Motor_design_mildsteel_casing/for_outsourcing/CAD/bulkhead.SLDPRT

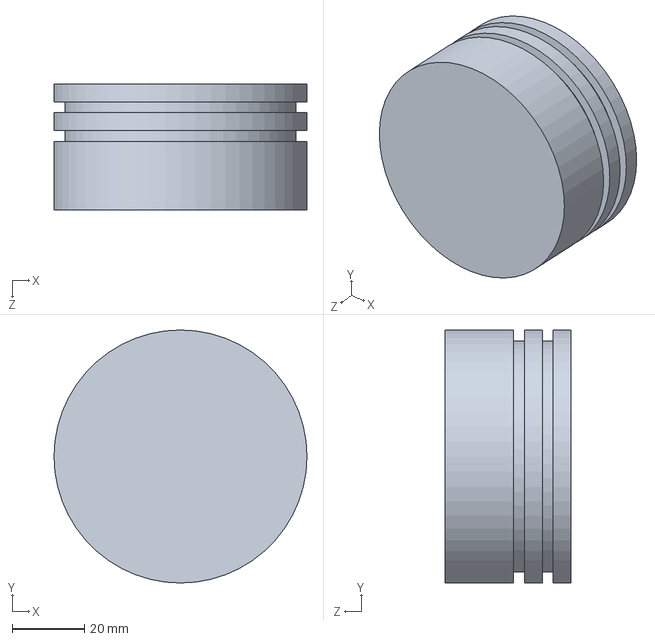
[picture p122: CAD file, 2023-11-22]
FlightData_N3_launch/Motor_design_mildsteel_casing/for_outsourcing/CAD/bulkhead.SLDPRT
70.0 x 70.0 x 35.0 mm
