nakujaproject/N3-Solid-_Propulsion/CAD_files/motorHolder.stl

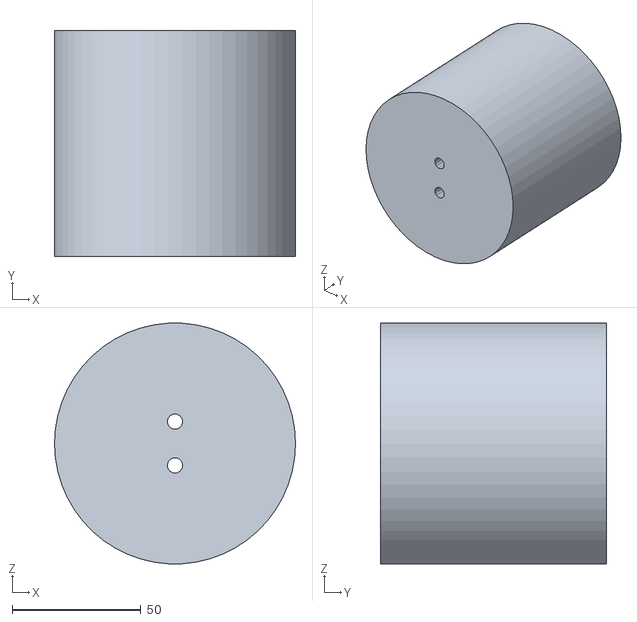
[picture p123: CAD file, 2023-06-30]
CAD_files/motorHolder.stl
93.7 x 88.0 x 93.5
