nakujaproject/N3-Solid-_Propulsion/CAD_files/mould 4.0/cyl inner.stl

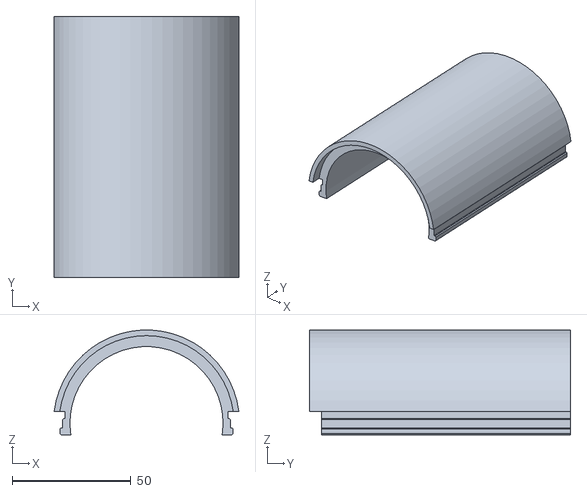
[picture p124: CAD file, 2023-11-19]
CAD_files/mould 4.0/cyl inner.stl
77.9 x 110.0 x 44.2
