nakujaproject/N3-Solid-_Propulsion/FlightData_N3_launch/Motor_design_Aluminum_casing/CAD/bulkhead.SLDPRT

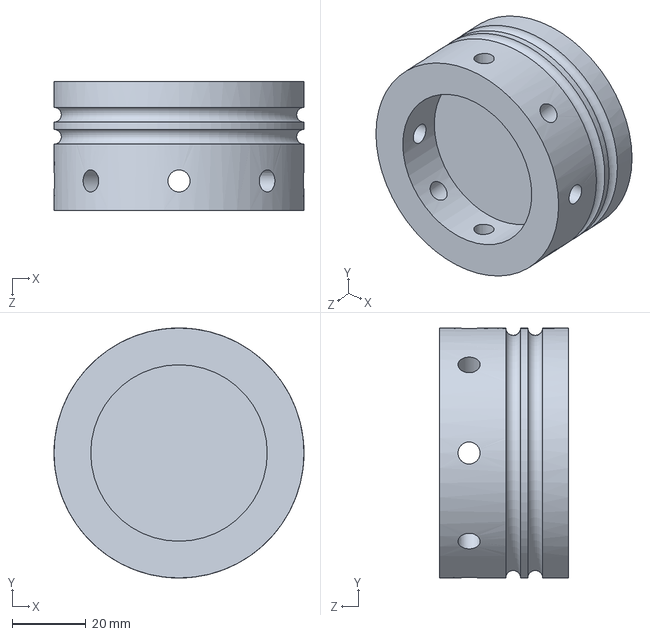
[picture p125: CAD file, 2023-11-21]
FlightData_N3_launch/Motor_design_Aluminum_casing/CAD/bulkhead.SLDPRT
68.0 x 68.0 x 35.0 mm
