nakujaproject/N3-Solid-_Propulsion/CAD_files/mould 4.0/base.stl

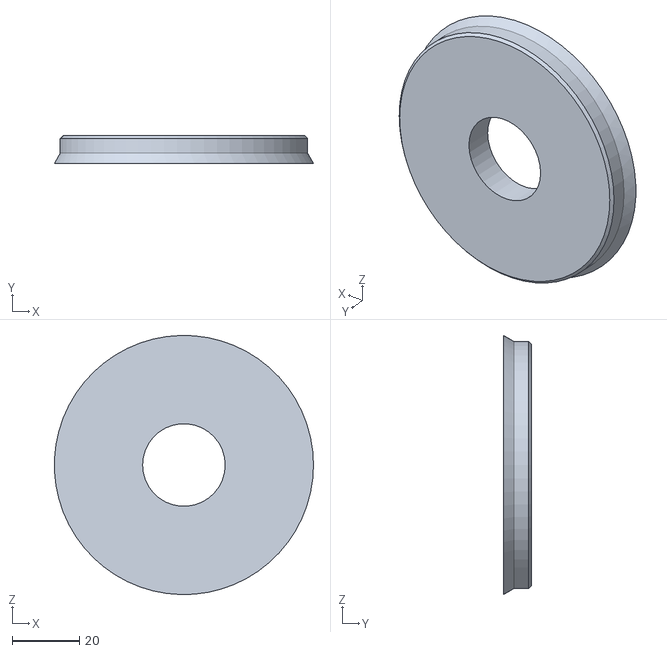
[picture p127: CAD file, 2023-11-19]
CAD_files/mould 4.0/base.stl
76.8 x 8.20 x 76.9
