nakujaproject/N3-Solid-_Propulsion/CAD_files/MouldCylinder.stl

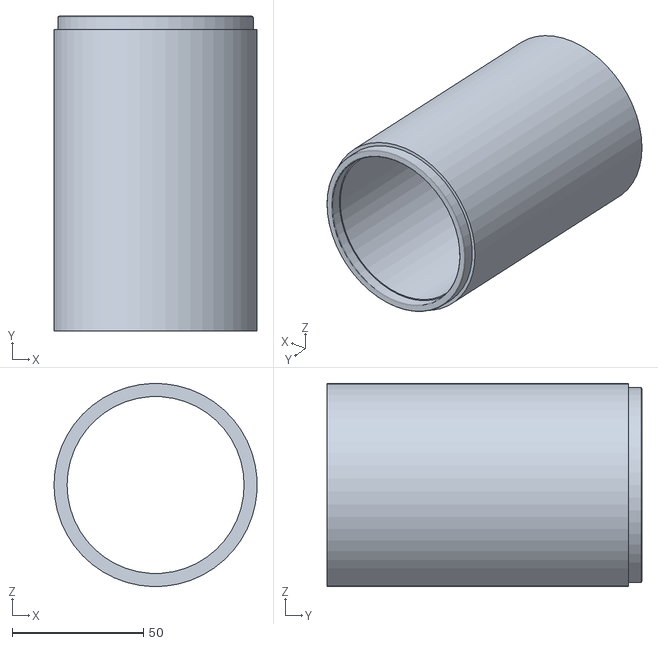
[picture p128: CAD file, 2023-06-30]
CAD_files/MouldCylinder.stl
77.4 x 120.0 x 77.5
