nakujaproject/N3-Solid-_Propulsion/FlightData_N3_launch/Motor_design_mildsteel_casing/CAD/propellant.SLDPRT

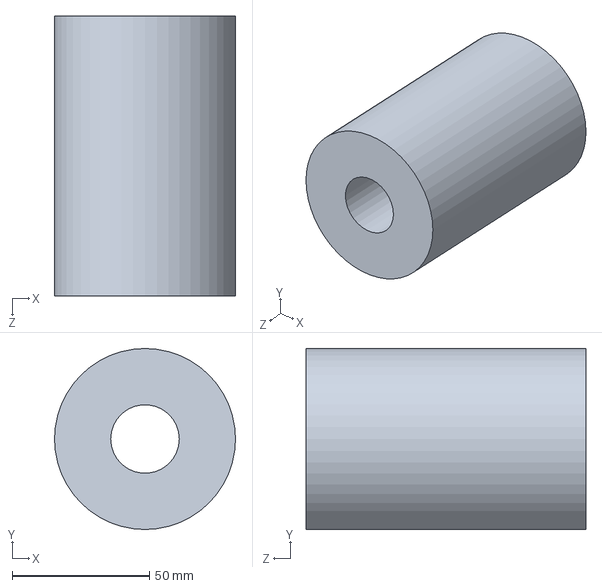
[picture p129: CAD file, 2023-11-21]
FlightData_N3_launch/Motor_design_mildsteel_casing/CAD/propellant.SLDPRT
66.0 x 66.0 x 102.0 mm
