nakujaproject/N3-Solid-_Propulsion/FlightData_N3_launch/Motor_design_mildsteel_casing/for_outsourcing/CAD/casing.SLDPRT

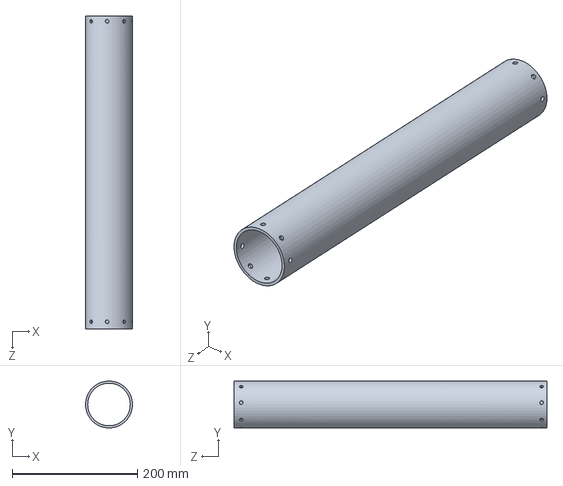
[picture p130: CAD file, 2023-11-21]
FlightData_N3_launch/Motor_design_mildsteel_casing/for_outsourcing/CAD/casing.SLDPRT
75.0 x 75.0 x 500.0 mm
