nakujaproject/N3-Solid-_Propulsion/FlightData_N3_launch/Motor_design_Aluminum_casing/CAD/liner.SLDPRT

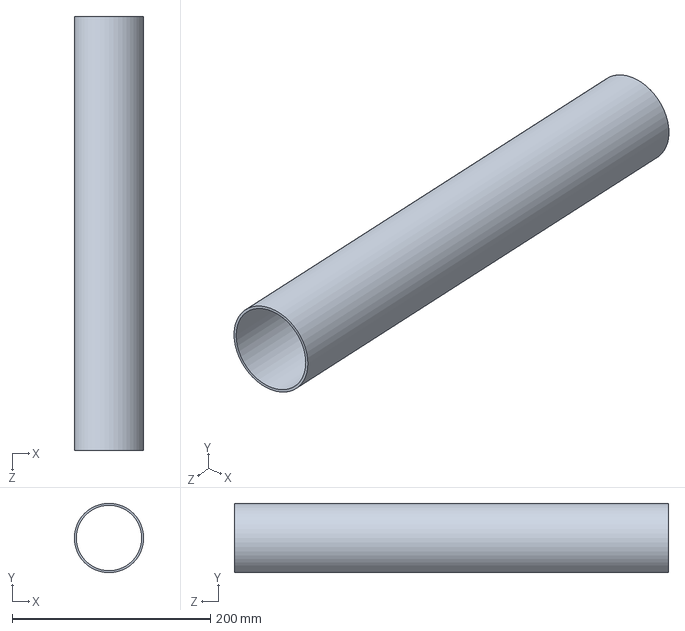
[picture p131: CAD file, 2023-11-21]
FlightData_N3_launch/Motor_design_Aluminum_casing/CAD/liner.SLDPRT
70.0 x 70.0 x 438.0 mm
