nakujaproject/N3-Solid-_Propulsion/FlightData_N3_launch/Motor_design_Aluminum_casing/CAD/nozzle6.SLDPRT

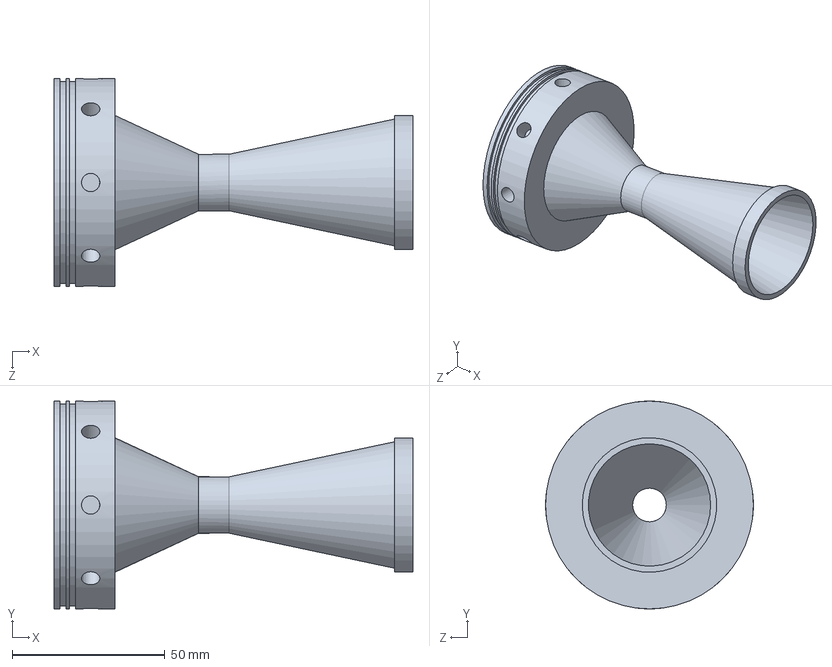
[picture p132: CAD file, 2023-11-21]
FlightData_N3_launch/Motor_design_Aluminum_casing/CAD/nozzle6.SLDPRT
117.5 x 68.0 x 68.0 mm
