nakujaproject/N3-Solid-_Propulsion/FlightData_N3_launch/Motor_design_mildsteel_casing/CAD/nozzle6.SLDPRT

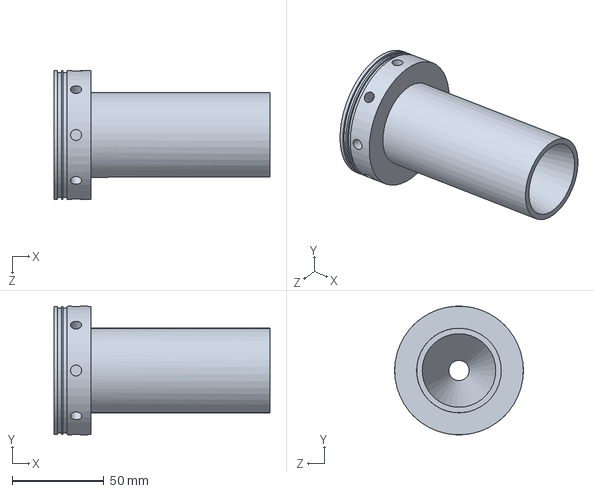
[picture p133: CAD file, 2023-11-21]
FlightData_N3_launch/Motor_design_mildsteel_casing/CAD/nozzle6.SLDPRT
117.5 x 70.0 x 70.0 mm
