nakujaproject/N3-Solid-_Propulsion/(list of files, cad)

Other CAD files:
Grain Mould/mould assembly-1 drg.dwg
CAD_files/mould 4.0/drng.dwg
CAD_files/mould 4.0/cyl outer.stl
FlightData_N3_launch/Motor_design_mildsteel_casing/CAD/bulkhead.SLDPRT
FlightData_N3_launch/Motor_design_mildsteel_casing/CAD/casing.SLDPRT
CAD_files/mould 4.0/assm.iam
CAD_files/mould 4.0/base.ipt
CAD_files/mould 4.0/cyl inner.ipt
CAD_files/mould 4.0/cyl outer.ipt
CAD_files/nozzle v1.f3d
FlightData_N3_launch/Motor_design_Aluminum_casing/CAD/casing.SLDDRW
FlightData_N3_launch/Motor_design_Aluminum_casing/CAD/motor1.SLDDRW
FlightData_N3_launch/Motor_design_Aluminum_casing/CAD/socket head cap screw_am2.SLDPRT
FlightData_N3_launch/Motor_design_mildsteel_casing/CAD/bulkhead.SLDDRW
FlightData_N3_launch/Motor_design_mildsteel_casing/CAD/casing.SLDDRW
FlightData_N3_launch/Motor_design_mildsteel_casing/CAD/motor1.SLDDRW
FlightData_N3_launch/Motor_design_mildsteel_casing/CAD/nozzle6.SLDDRW
FlightData_N3_launch/Motor_design_mildsteel_casing/CAD/socket head cap screw_am2.SLDPRT
FlightData_N3_launch/Motor_design_mildsteel_casing/for_outsourcing/CAD/bulkhead_rev.SLDDRW
FlightData_N3_launch/Motor_design_mildsteel_casing/for_outsourcing/CAD/casing_rev.SLDDRW
FlightData_N3_launch/Motor_design_mildsteel_casing/for_outsourcing/CAD/nozzle7.SLDDRW
FlightData_N3_launch/Motor_design_mildsteel_casing/for_outsourcing/CAD/order_summary.SLDDRW
Grain Mould/bottom.ipt
Grain Mould/center.ipt
Grain Mould/clamp.ipt
Grain Mould/half cylinder.ipt
Grain Mould/mould assembly prs.ipn
Grain Mould/mould assembly.iam
Grain Mould/seal.ipt
Grain Mould/top.ipt
