nakujaproject/N3-Solid-_Propulsion/Static Test Results/1 grain static test 1.txt

11:38:07.638 -> 71.05
11:38:07.638 -> 77.84
11:38:07.638 -> 80.00
11:38:07.672 -> 94.11
11:38:07.672 -> 131.44
11:38:07.672 -> 191.67
11:38:07.705 -> 279.04
11:38:07.705 -> 403.29
11:38:07.705 -> 571.29
11:38:07.739 -> 782.67
11:38:07.739 -> 1026.91
11:38:07.739 -> 1293.05
11:38:07.772 -> 1575.33
11:38:07.772 -> 1869.60
11:38:07.772 -> 2160.82
11:38:07.805 -> 2432.11
11:38:07.805 -> 2687.55
11:38:07.805 -> 2940.20
11:38:07.837 -> 3193.73
11:38:07.837 -> 3432.51
11:38:07.837 -> 3671.13
11:38:07.870 -> 3917.33
11:38:07.870 -> 4166.96
11:38:07.870 -> 4400.31
11:38:07.905 -> 4611.07
11:38:07.905 -> 4807.31
11:38:07.905 -> 4991.58
11:38:07.938 -> 5158.04
11:38:07.938 -> 5315.75
11:38:07.938 -> 5463.87
11:38:07.972 -> 5598.62
11:38:07.972 -> 5726.85
11:38:07.972 -> 5872.75
11:38:08.005 -> 6036.95
11:38:08.005 -> 6221.29
11:38:08.005 -> 6413.13
11:38:08.038 -> 6582.62
11:38:08.038 -> 6704.42
11:38:08.038 -> 6776.84
11:38:08.071 -> 6817.49
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
