nakujaproject/N3-Solid-_Propulsion/Static Test Results/1 grain static test2.txt

 7.16, 12.73, 16.18, 20.13, 24.55, 29.58, 35.98, 41.95, 48.82, 57.07, 77.89, 91.31, 112.73, 144.36, 158.75, 168.62, 181.51, 196.15, 213.60, 233.87, 255.87, 279.69, 309.80, 347.80, 382.56, 391.33, 406.33, 439.11, 534.95, 593.71, 832.38, 922.65, 1015.82, 1108.93, 1200.04, 1293.35, 1390.33, 1467.11, 1517.96, 1595.04, 1699.15, 1789.29, 1875.47, 1946.75, 2031.15, 2193.69, 2460.27, 2543.73, 2629.35, 2797.44, 3043.35, 3180.71, 3244.51, 3290.67, 3400.64, 3459.22, 3493.24, 3636.29, 3769.95, 4084.53, 4089.73, 4089.73, 3913.07, 3512.16, 3373.69, 3215.42, 3027.05, 2567.78, 2012.78, 1467.80, 1218.09, 529.44, 327.13, 130.71

start: 11:36:09.621
finish: 11:36:20.917
