nakujaproject/N3-Solid-_Propulsion/Static Test Results/2 grain static test 3.txt

14:31:00.520 -> -10.09, -10.16, -10.73, -10.91, -12.53, -12.53, -12.36, -5.11, 17.98, 46.20, 74.64, 103.05, 131.67, 160.67, 190.73, 230.51, 286.35, 342.20, 458.25, 522.47, 598.85, 701.45, 835.49, 1001.98, 1211.33, 1481.00, 1809.95, 2192.87, 2622.96, 3114.65, 3644.42, 4216.42, 4875.87, 5615.78, 6540.29, 7625.80, 8715.31, 9771.20, 10791.45, 11759.13, 12680.34, 13519.34, 14361.93, 15174.85, 15979.87, 16484.65, 16873.38, 17167.67, 17618.47, 18016.60, 18316.49, 18490.78, 18368.44, 18090.56, 17724.51, 17259.87, 16591.71, 15909.33, 15177.87, 14409.69, 13461.13, 12414.05, 11378.76, 10512.36, 9681.64, 8862.60, 7779.29, 6650.27, 5543.76, 4558.40, 3797.60, 3141.29, 2684.75, 2245.84, 1852.75, 1517.16, 1273.95, 1089.42, 935.02, 807.00, 711.44, 640.36, 589.64, 555.65, 537.04, 527.67, 521.22, 516.18, 512.15, 509.22, 508.22, 508.20, 508.20, 508.89, 509.96, 510.75, 511.89, 513.31, 514.80, 516.20, 517.45, 518.56, 519.55, 520.40, 520.98, 521.36, 521.56, 521.58, 521.38, 521.04, 520.71, 520.33, 519.85, 519.36, 518.60, 517.65, 516.67, 515.62, 514.51, 513.42, 512.25, 511.05, 509.89, 508.62, 507.38, 506.15, 504.85, 503.62, 502.45, 501.31, 500.18, 499.16, 498.15, 497.07, 495.91, 494.69, 493.44, 492.13, 490.78, 489.51, 488.18, 486.89, 485.69, 484.45, 483.20, 481.91, 480.60, 479.33, 478.09, 476.93, 475.89, 474.95, 474.07, 473.31, 472.60, 471.80, 471.05, 470.31, 469.56, 468.84, 468.07, 467.31, 466.62, 465.93, 465.20, 464.51, 463.85, 463.24, 462.60, 461.95, 461.27, 460.67, 460.13, 459.58, 459.02, 458.44, 457.93, 457.47, 457.02, 456.51, 455.98, 455.44, 454.91, 454.33, 453.78, 453.25, 452.73, 452.25, 451.73, 451.16, 450.65, 450.20, 449.76, 449.33, 448.85, 407.69

14:30:37.498 -> -5.11
14:30:44.511 -> 521.22

14:30:44.869 -> 0

7.013
