nakujaproject/N3-Solid-_Propulsion/Static Test Results/2 grain static test2.txt

1.00, 4.55, 12.56, 23.44, 35.93, 49.11, 65.16, 82.55, 102.35, 123.13, 143.80, 166.35, 189.38, 212.38, 232.82, 252.42, 272.24, 285.93, 292.60, 293.84, 294.53, 294.53, 293.96, 292.67, 289.27, 282.00, 272.18, 261.75, 248.29, 234.36, 220.64, 210.82, 202.13, 194.00, 190.84, 190.31, 190.31, 193.98, 199.07, 204.84, 211.22, 216.84, 222.87, 229.91, 238.49, 247.27, 256.02, 266.22, 275.55, 287.15, 300.02, 312.09, 323.93, 334.15, 343.16, 352.07, 361.05, 368.62, 375.73, 381.98, 386.58, 389.75, 393.76, 396.18, 398.27, 399.95, 397.98, 393.56, 388.69, 380.96, 371.47, 362.82, 354.22, 344.44, 334.87, 323.47, 313.45, 303.85, 295.00, 286.98, 278.89, 271.11, 263.93, 260.58, 260.53, 260.53, 264.64, 271.53, 281.87, 294.93, 309.35, 326.89, 347.42, 369.98, 393.76, 445.78, 473.55, 502.51, 532.02, 733.80, 757.64, 779.87, 803.53, 865.69, 883.31, 898.18, 911.73, 899.22, 893.15, 887.04, 883.85, 889.85, 897.22, 906.51, 919.29, 931.51, 946.05, 957.95, 991.84, 1008.33, 1025.31, 1044.55, 1062.36, 1080.89, 1098.65, 1116.73, 1132.24, 1148.31, 1164.18, 1175.45, 1187.47, 1198.07, 1208.07, 1221.07, 1227.78, 1236.25, 1243.24, 1248.13, 1250.84, 1254.15, 1255.85, 1253.42, 1249.95, 1246.00, 1239.55, 1232.76, 1226.25, 1220.64, 1213.27, 1208.38, 1208.67, 1208.67, 1214.55, 1219.73, 1224.09, 1231.16, 1241.78, 1254.31, 1265.93, 1277.93, 1292.04, 1305.55, 1317.02, 1328.18, 1339.13, 1347.49, 1356.13, 1368.69, 1378.18, 1385.49, 1394.29, 1403.00, 1413.76, 1419.36, 1424.09, 1424.53, 1423.56, 1425.60, 1423.91, 1427.24, 1430.55, 1435.18, 1438.75, 1445.91, 1453.40, 1456.36, 1460.53, 1464.33, 1465.85, 1465.85, 1465.95, 1464.69, 1464.47, 1467.35, 1471.24, 1472.00, 1473.58, 1472.47, 1472.38, 1472.89, 1475.02, 1474.27, 1471.75, 1471.78, 1469.11, 1466.38, 1466.42, 1464.35, 1464.35, 1464.40, 1465.31, 1469.62, 1474.02, 1481.11, 1490.65, 1501.84, 1510.76, 1520.31, 1529.38, 1538.38, 1547.33, 1557.85, 1568.40, 1579.96, 1591.82, 1605.64, 1620.78, 1635.09, 1649.55, 1664.07, 1674.49, 1685.76, 1697.29, 1709.13, 1722.51, 1737.87, 1755.24, 1775.53, 1796.95, 1821.53, 1844.58, 1866.40, 1889.85, 1909.95, 1929.22, 1945.20, 1962.49, 1979.47, 1997.22, 2013.47, 2030.53, 2047.36, 2063.49, 2076.89, 2090.13, 2101.53, 2110.73, 2121.69, 2130.45, 2141.27, 2151.73, 2165.02, 2181.24, 2199.31, 2218.13, 2234.56, 2250.04, 2263.09, 2273.20, 2280.67, 2284.98, 2290.24, 2296.20, 2331.78, 2365.62, 2385.04, 2424.45, 2446.45, 2524.11, 2584.20, 2618.15, 2649.60, 2691.42, 2701.91, 2706.91, 2711.47, 2711.47, 2712.65, 2715.40, 2720.56, 2724.58, 2730.22, 2733.69, 2726.02, 2711.15, 2666.31, 3552.22, 3535.45, 3521.16, 3532.44, 3541.07, 3581.07, 3598.96, 3606.22, 3609.56, 3608.44, 3588.51, 3575.56, 3554.13, 3555.29, 3550.44, 3540.44, 3532.89, 3523.47, 3505.04, 3481.33, 3455.11, 3428.24, 3400.35, 3375.35, 3360.58, 3345.69, 3327.93, 3312.29, 3288.09, 3268.82, 3250.51, 3227.82, 3204.40, 3172.07, 3133.49, 3091.87, 3051.82, 3010.95, 2966.98, 2926.05, 2882.02, 2834.51, 2777.96, 2723.09, 2673.75, 2622.69, 2565.71, 2499.33, 2429.53, 2354.05, 2282.96, 2205.42, 2127.65, 2049.36, 1971.02, 1884.95, 1788.04, 1692.27, 1594.42, 1492.73, 1388.18, 1283.58, 1176.42, 1072.62, 958.89, 838.62, 706.82, 580.02, 454.82, 331.56, 211.89, 99.82, 1.15 

13:50:00.058 --> 13:50:11.754
