nakujaproject/N3-Solid-_Propulsion/Static Test Results/4GrainMotor Static test results - test 1.txt

 71.25, 74.67, 71.58, 70.33, 94.33, 132.17, 140.00, 147.17, 156.17, 161.33, 179.50, 222.42, 240.67, 220.92, 229.92, 268.67, 288.92, 313.50, 354.00, 385.75, 417.33, 433.83, 446.33, 473.17, 489.33, 506.33, 553.33, 732.75, 1265.50, 3105.92, 3723.50, 5167.42, 5439.00, 5439.00, 5837.17, 6272.50, 6558.92, 7591.50, 8984.17, 9988.92, 10205.67, 10758.08, 10858.17, 10953.67, 11029.83, 11104.83, 11176.08, 11250.25, 11348.00, 11430.83, 11483.25, 11534.33, 11563.58, 11585.25, 11599.83, 11623.92, 11658.42, 11694.50, 11749.42, 11807.50, 11887.17, 12129.67, 12241.08, 12334.67, 12446.50, 12549.42, 12676.00, 12845.67, 13060.17, 13277.67, 13490.08, 13717.75, 13961.00, 14207.17, 14459.92, 15283.08, 15959.83, 16342.25, 16732.17, 17533.17, 17951.33, 19421.42, 19924.17, 20470.08, 20977.92, 21426.75, 21783.33, 22039.00, 22228.67, 22279.42, 22279.42, 22187.25, 21847.42, 18085.50, 16012.83, 11720.50, 10222.67, 8402.83, 6351.17, 4066.50, 1523.00, -918.00
