nakujaproject/N3-Solid-_Propulsion/Static Test Results/2 grain motor test 3 thrust curve.png

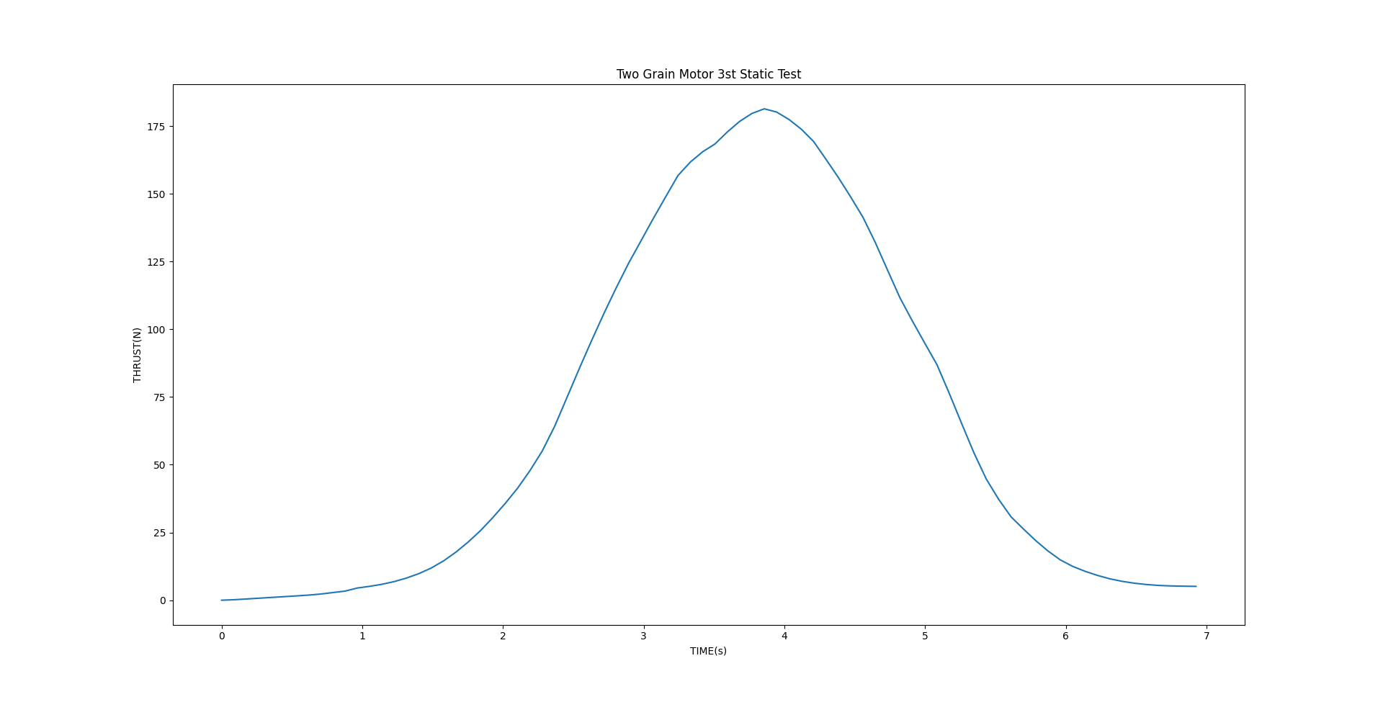
Static Test Results/2 grain motor test 3 thrust curve.png
