nakujaproject/N3-Solid-_Propulsion/Static Test Results/2GMt1.webp

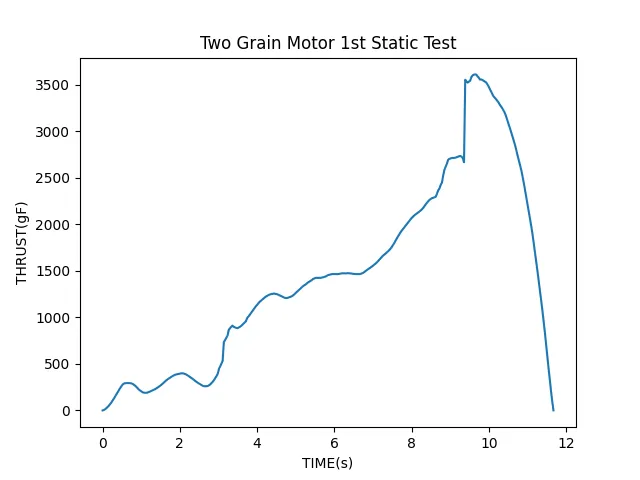
Static Test Results/2GMt1.webp
