nakujaproject/N3-Solid-_Propulsion/Static Test Results/theoretical vs actual - 4GM test1.png

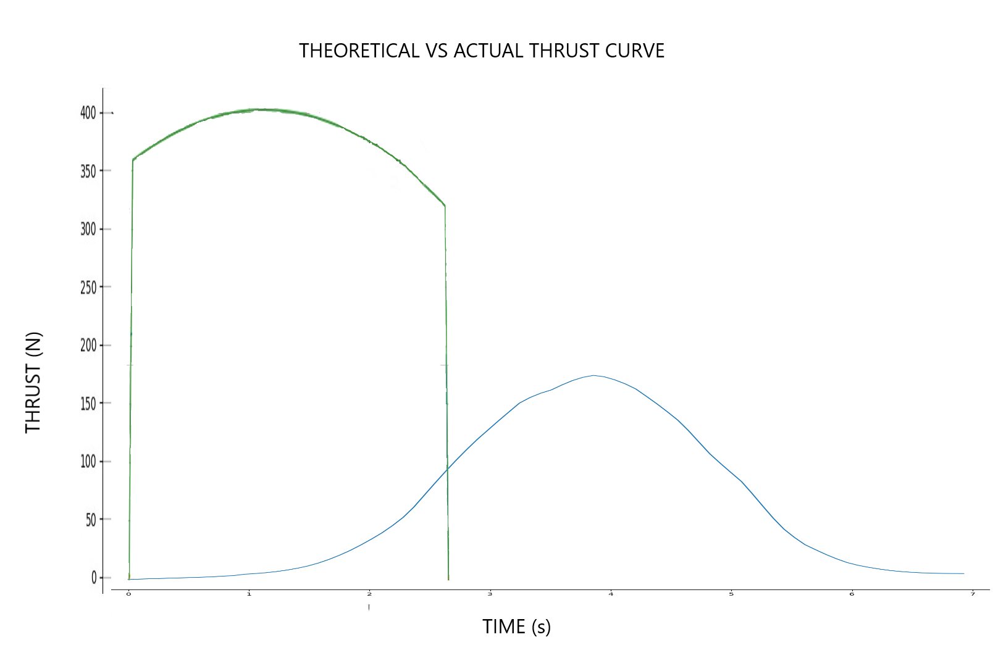
Static Test Results/theoretical vs actual - 4GM test1.png
