nakujaproject/N3-Solid-_Propulsion/FlightData_N3_launch/Motor_design_mildsteel_casing/for_outsourcing/order_summary.pdf

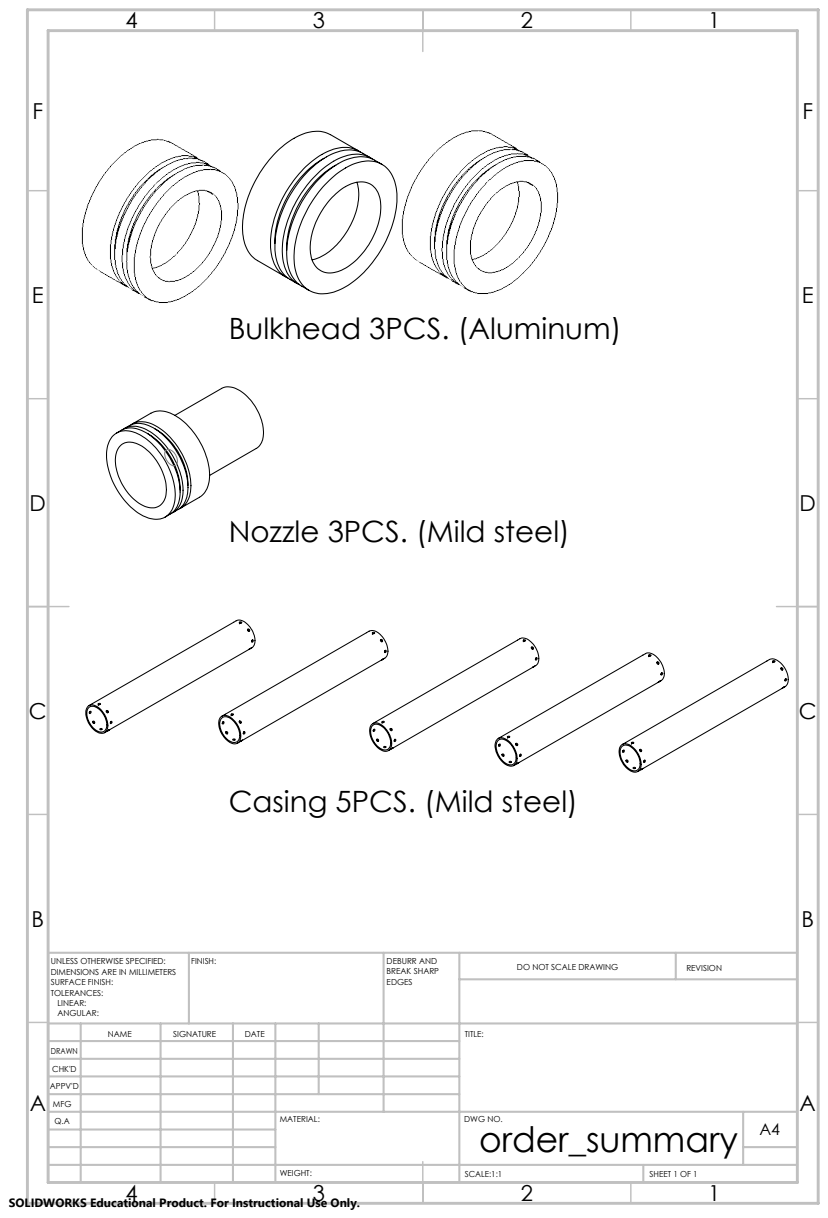
[picture p137: page 1]
Bulkhead 3PCS. (Aluminum); FINISH:; DEBURR AND; BREAK SHARP; DO NOT SCALE DRAWING; REVISION; SCALE:1:1; SHEET 1 OF 1

Nozzle 3PCS. (Mild steel)

Casing 5PCS. (Mild steel)

UNLESS OTHERWISE SPECIFIED:
DIMENSIONS ARE IN MILLIMETERS
SURFACE FINISH:
TOLERANCES:
LINEAR:
ANGULAR:

NAME | SIGNATURE | DATE | | | | TITLE:

DRAWN
CHK'D
APPV'D
MFG
Q.A | | | | MATERIAL: | DWG NO. order_summary | A4

SOLIDWORKS Educational Product. For Instructional Use Only.
