nakujaproject/N3-Solid-_Propulsion/FlightData_N3_launch/Motor_design_mildsteel_casing/CAD/bulkhead.pdf

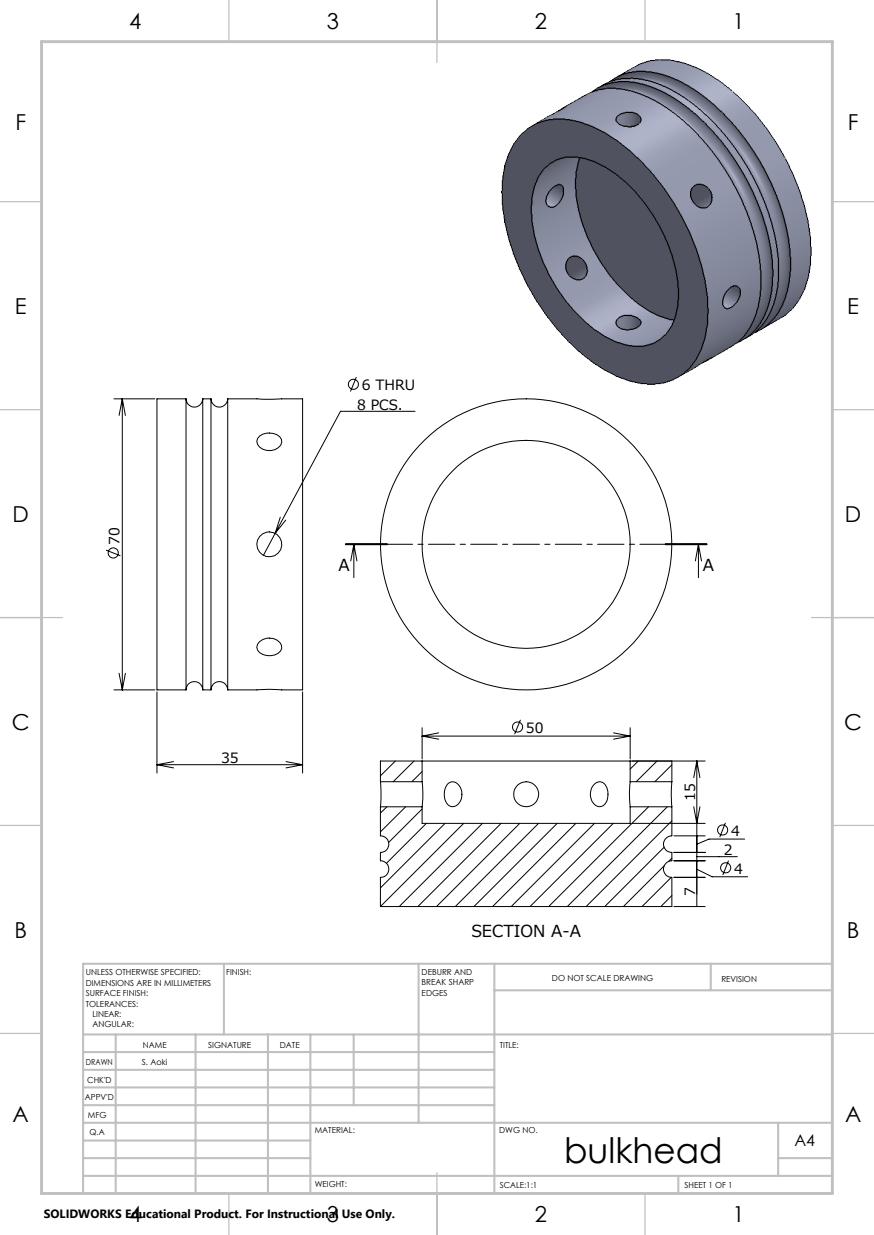
[picture p139: page 1]
6 THRU 8 PCS.; SECTION A-A; FINISH:; DEBURR AND; BREAK SHARP; DO NOT SCALE DRAWING; REVISION; SCALE:1:1; SHEET 1 OF 1

UNLESS OTHERWISE SPECIFIED:
DIMENSIONS ARE IN MILLIMETERS
SURFACE FINISH:
TOLERANCES:
LINEAR:
ANGULAR:

NAME | SIGNATURE | DATE | | | | TITLE:

DRAWN | S. Aoki
CHK'D
APPV'D
MFG
Q.A | | | | MATERIAL: | DWG NO. bulkhead | A4

SOLIDWORKS Educational Product. For Instructional Use Only.
