nakujaproject/N3-Solid-_Propulsion/(list of files, drawings)

Other design files:
Ignition circuit 2.0.pdsprj
