nakujaproject/N3-Solid-_Propulsion/CODE/staticTestCodeV2/MAIN_INITIATOR/MAIN_INITIATOR.ino

/*
  NAKUJA PROJECT
  MAIN INTIATOR
  - Transmits load cell calibrated readings
  - Ignition of motor
*/

// Include Libraries
#include <WiFi.h>
#include <esp_now.h>
#include <HX711_ADC.h> //------------------



// Define Ignition pin----------------------------------------------
#define ign_pin 33
bool IGN_STATUS = false;
bool ign_tare = false;
unsigned long t_ = 0;

// Define Load Cell pins----------------------------------------------
const int HX711_dout = 13; //mcu > HX711 dout pin, must be external interrupt capable!
const int HX711_sck = 32; //mcu > HX711 sck pin


//HX711 constructor:-------------------------------------------------
HX711_ADC LoadCell(HX711_dout, HX711_sck);


unsigned long t = 0;
volatile boolean newDataReady;


//Ignition func-----------------------------------------------------------


//interrupt routine:----------------------------------------------------------
void dataReadyISR() {
  if (LoadCell.update()) {
    newDataReady = 1;
  }
}



void formatMacAddress(const uint8_t *macAddr, char *buffer, int maxLength)
// Formats MAC Address
{
  snprintf(buffer, maxLength, "%02x:%02x:%02x:%02x:%02x:%02x", macAddr[0], macAddr[1], macAddr[2], macAddr[3], macAddr[4], macAddr[5]);
}


void receiveCallback(const uint8_t *macAddr, const uint8_t *data, int dataLen)
// Called when data is received
{
  // Only allow a maximum of 250 characters in the message + a null terminating byte
  char buffer[ESP_NOW_MAX_DATA_LEN + 1];
  int msgLen = min(ESP_NOW_MAX_DATA_LEN, dataLen);
  strncpy(buffer, (const char *)data, msgLen);

  // Make sure we are null terminated
  buffer[msgLen] = 0;

  // Format the MAC address
  char macStr[18];
  formatMacAddress(macAddr, macStr, 18);

  // Send Debug log message to the serial port---------------------
  //Serial.printf("Received message from: %s - %s\n", macStr, buffer);

  // Check switch status
  if (strcmp("on", buffer) == 0)
  {
    //Start ignition-------------------------------------------------
    //Serial.println("Staring engine: ");
    IGN_STATUS = true;
    ign_tare = true;
    t_ = millis();
  }
  
}


void sentCallback(const uint8_t *macAddr, esp_now_send_status_t status)
// Called when data is sent
{
  char macStr[18];
  formatMacAddress(macAddr, macStr, 18);
  //Serial.print("Last Packet Sent to: ");
  //Serial.println(macStr);
  //Serial.print("Last Packet Send Status: ");
  //Serial.println(status == ESP_NOW_SEND_SUCCESS ? "Delivery Success" : "Delivery Fail");
}

void broadcast(const String &message)
// Emulates a broadcast
{
  // Broadcast a message to every device in range
  uint8_t broadcastAddress[] = {0xFF, 0xFF, 0xFF, 0xFF, 0xFF, 0xFF};
  esp_now_peer_info_t peerInfo = {};
  memcpy(&peerInfo.peer_addr, broadcastAddress, 6);
  if (!esp_now_is_peer_exist(broadcastAddress))
  {
    esp_now_add_peer(&peerInfo);
  }
  // Send message
  esp_err_t result = esp_now_send(broadcastAddress, (const uint8_t *)message.c_str(), message.length());

  // Print results to serial monitor
  if (result == ESP_OK)
  {
    //Serial.println("Broadcast message success");
  }
  else if (result == ESP_ERR_ESPNOW_NOT_INIT)
  {
    Serial.println("ESP-NOW not Init.");
  }
  else if (result == ESP_ERR_ESPNOW_ARG)
  {
    Serial.println("Invalid Argument");
  }
  else if (result == ESP_ERR_ESPNOW_INTERNAL)
  {
    Serial.println("Internal Error");
  }
  else if (result == ESP_ERR_ESPNOW_NO_MEM)
  {
    Serial.println("ESP_ERR_ESPNOW_NO_MEM");
  }
  else if (result == ESP_ERR_ESPNOW_NOT_FOUND)
  {
    Serial.println("Peer not found.");
  }
  else
  {
    Serial.println("Unknown error");
  }
}

void setup()
{

  // Set up Serial Monitor
  Serial.begin(115200);
  delay(1000);

  //Set ign_pin to OUTPUT
  pinMode(ign_pin, OUTPUT);

  //LoadCell stuff -----------------------------------------------------------------
  Serial.println("Starting...");

  float calibrationValue; // calibration value
  calibrationValue = 9.2; // uncomment this if you want to set this value in the sketch

  LoadCell.begin();
  //LoadCell.setReverseOutput();
  unsigned long stabilizingtime = 2000; // tare preciscion can be improved by adding a few seconds of stabilizing time
  boolean _tare = true; //set this to false if you don't want tare to be performed in the next step
  LoadCell.start(stabilizingtime, _tare);
  if (LoadCell.getTareTimeoutFlag()) {
    Serial.println("Timeout, check MCU>HX711 wiring and pin designations");
    while (1);
  }
  else {
    LoadCell.setCalFactor(calibrationValue); // set calibration value (float)
    Serial.println("Startup is complete");
  }

  attachInterrupt(digitalPinToInterrupt(HX711_dout), dataReadyISR, FALLING);
  //----------------------------------------------------------

  // Set ESP32 in STA mode to begin with
  WiFi.mode(WIFI_STA);
  Serial.println("ESP-NOW Broadcast");

  // Print MAC address
  Serial.print("MAC Address: ");
  Serial.println(WiFi.macAddress());

  // Disconnect from WiFi
  WiFi.disconnect();

  // Initialize ESP-NOW
  if (esp_now_init() == ESP_OK)
  {
    Serial.println("ESP-NOW Init Success");
    esp_now_register_recv_cb(receiveCallback);
    esp_now_register_send_cb(sentCallback);
  }
  else
  {
    Serial.println("ESP-NOW Init Failed");
    delay(3000);
    ESP.restart();
  }
\

}

void loop()
{
  const int serialPrintInterval = 0; //increase value to slow down serial print activity---------------------------------------

  // get smoothed value from the dataset:--------------------------------------------------------------
  if (newDataReady) {
    if (millis() > t + serialPrintInterval) {
      float i = LoadCell.getData();
      newDataReady = 0;
      //Serial.print("Load_cell output val: ");
      Serial.println(i);
      Serial.println("g");
      broadcast(String(i));

      t = millis();
    }
  }

  // receive command from serial terminal, send 't' to initiate tare operation:
  if (Serial.available() > 0) {
    char inByte = Serial.read();
    if (inByte == 't') LoadCell.tareNoDelay();
  }

  /*if (ign_tare){
    LoadCell.tareNoDelay();
    ign_tare = false;
  }*/

  //check if last tare operation is complete
  if (LoadCell.getTareStatus() == true) {
    Serial.println("Tare complete");
  }
  //------------------------------------------------------------------
  
  if(IGN_STATUS && t_ + 15000 > millis()){
    digitalWrite(ign_pin, HIGH);
    Serial.println('ign!');
    
  }else{
    IGN_STATUS = false;
    digitalWrite(ign_pin, LOW);
  }

  

}
