nakujaproject/N3-Solid-_Propulsion/(commit log)

2023-02-07 Added All files relating to nozzle and propelant
    [SRM_2014.1.xls, nozzle v1.f3d]
2023-02-22 Added material comparison
    [material_comparion.csv]
2023-05-26 Add Batch 2 open motor files
2023-05-29 Add motor reading python UI code
2023-06-12 Add files via upload
    CAD files for grain mould with a compaction mechanism.
    [bottom.ipt, center.ipt, clamp.ipt, half cylinder.ipt, mould assembly prs.ipn, mould assembly-1 drg.dwg, mould assembly.iam, seal.ipt]
2023-06-19 Create CIRCUITS
2023-06-20 Add files via upload
    Remote ignition and wireless transmission of load cell data for static test.
2023-06-27 Create Grain mould and Motor Holder
2023-11-19 add flight data
    [base.stl, cyl inner.stl, cyl outer.stl]
2023-11-19 create folder
    [base.stl, cyl inner.stl, cyl outer.stl]
2023-11-21 add motor design files
    [bulkhead.SLDDRW, bulkhead.SLDPRT, casing.SLDDRW, casing.SLDPRT, liner.SLDPRT, motor1.SLDASM, motor1.SLDDRW, nozzle3.SLDPRT]
2023-11-22 add CAD
    [bulkhead.SLDPRT, bulkhead_rev.SLDDRW, casing.SLDPRT, casing_rev.SLDDRW, nozzle7.SLDDRW, nozzle7.SLDPRT, order_summary.SLDDRW]
2023-12-03 Add files via upload
    Mould for casting KNSB grains. Consists of two half cylinders with prismatic joining feature and a base.
    [assm.iam, base.ipt, base.stl, cyl inner.ipt, cyl inner.stl, cyl outer.ipt, cyl outer.stl, drng.dwg]
